zettrik/eddy2power/project_presentation_notes.md

# Windpower to the people
sense, think, act

## hardware
* nodemcu, mcp3208, mosfets, acs, 
* think pcb

## software
* arduino code, munin plugin

## data/information flow
* nodemcu -> sensor -> mqtt -> grafana

## visualization
* realtime: mqtt channel
* overview: munin
* better overview: grafana

## ideas
* drop nodemcus high power usage
* design sensor pcb
* design highpower switching (acting) pcb
