zettrik/eddy2power/work_in_progress/dumploadcontroller.pdf

https://www.warlock.com.au/dumploadcontroller.htm

Design & Construction:

# Dumpload and charge-controller circuit

### for Wind Turbines

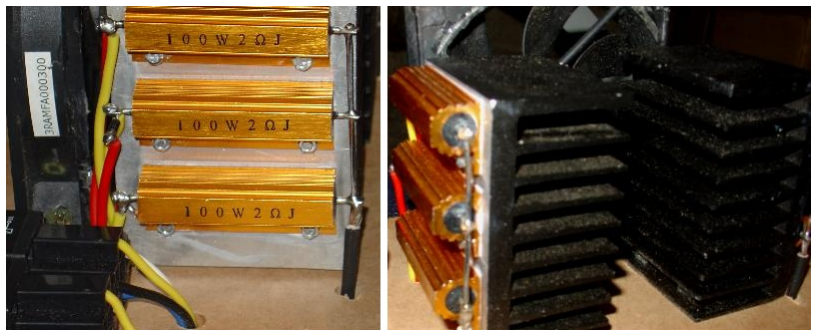
[picture p5: figure]

Abstract:
Wind turbine voltage regulation is usually achieved by diverting or dumping excess power into a dumpload (as heat). A universal 4-stage wind turbine dumpload charge controller circuit (inc. resistor load) was designed and built (using veroboard) for $140.

Without a charge controller, the wind turbine's main storage battery will overcharge resulting in reduced battery capacity and damage. Exceeding the maximum charging voltage on your 12/24v lead-acid battery system, will overcharge the battery, release hydrogen gas and result in permanent capacity loss.

14/12/2009

www.warlock.com.au

- 1/5 -

Copyright © 2009 - 2016 Warlock Engineering Pty. Ltd, All rights reserved. No part of this publication may not be reproduced or used in any manner without the express written permission of the publisher .

Rev. 2.0 - 16/8/2016

## Table of Contents

- 2/5 -

## Charge Controller Circuit

Four voltage comparator OP-AMPs switch-on 40 amp automotive relays when the battery voltage exceeds the trimpot set-voltages.

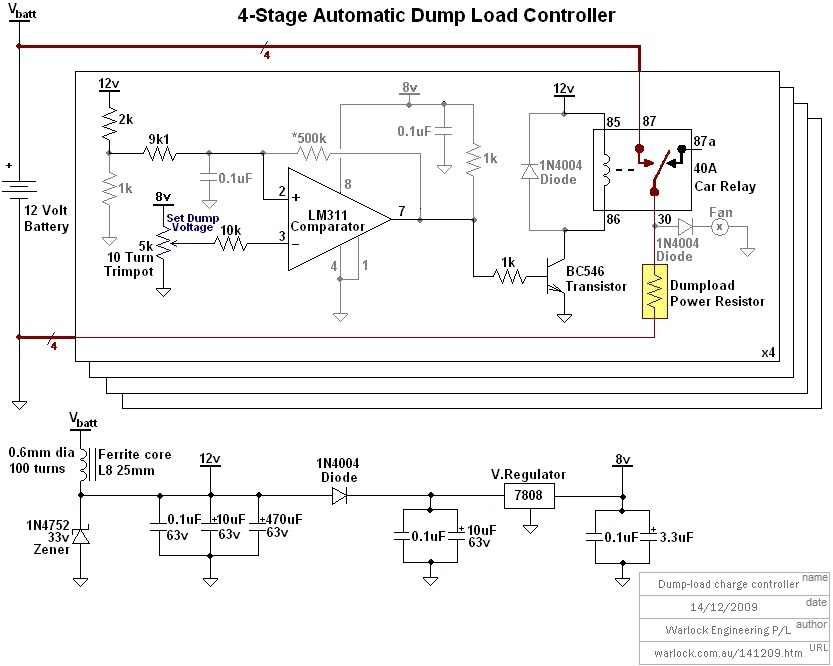
[picture p6: figure]

Figure 1. Circuit Diagram
A Zener diode and LC filter protects the op-amp from voltage spikes and noise. The 7808 voltage regulator provides power to the op-amp and voltage reference.
relay | on-
| voltage | off-
| | voltage | resistance | power | total-
| | | | | power
1 | 13.90 V | 13.75 V | 2 Ohm | 100 W | 100 W
2 | 14.00 V | 13.85 V | 2 Ohm | 100 W | 200 W
3 | 14.20 V | 14.05 V | 1 Ohm | 200 W | 400 W
4 | 14.30 V | 14.15 V | 1 Ohm | 200 W | 600 W

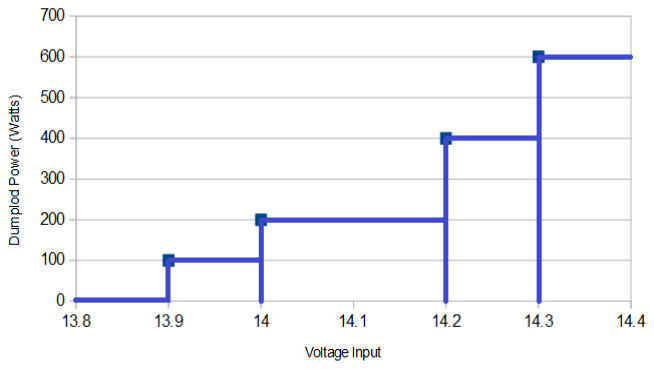
[picture p7: figure]

Figure 2. - Voltage thresholds and Power-load curve

- 3/5 -

The 500kW positive feedback resistor protects the relays from becoming unstable (oscillation) with 0.15 Volts of on/off hysteresis.

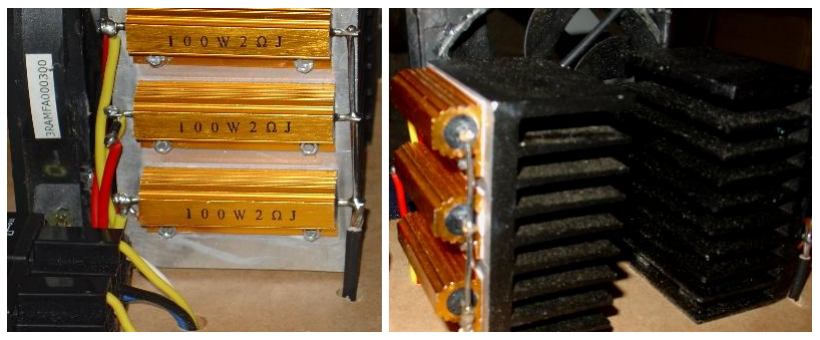
[picture p8: figure]

Figure 3. - Heatsink and Fan 6 x 100 watt power resistors connect to the battery with the automotive relays (see table 1), each relay is capable of diverting up to 40 Amps (576 Watts @ 12V) to the dumpload, the power-load curve for a typical 12v battery system (double for 24 volts) is shown in figure 2 .

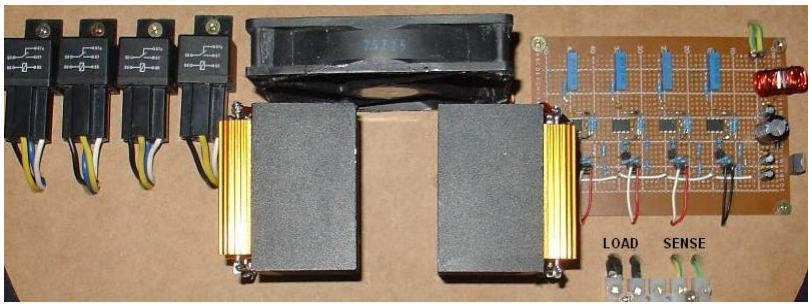
[picture p9: figure]

Figure 4. - Complete System Only 4 wires (load & sense) connect to the battery system, protecting it from overcharge and damage.

This type of power resistor requires a high quality fan and heatsink to operate, however the circuit works with any type of load (up to 40A).

- 4/5 -

Parts List

Qty | Part | Description | Unit cost | Cost
4 | LM311 | Comparator | $1.75 | $7.00
4 | BC547 | NPN Transistor | $0.26 | $1.04
1 | 7808 | Voltage Regulator, 8.0 Volts | $1.65 | $1.65
4 | 5k | 10-turn trimpot resistor | $1.75 | $7.00
9 | 1N4004 | Diode | $0.13 | $1.17
1 | 1N4752 | Zener diode , 33 Volts | $0.55 | $0.55
1 | L8 | 25x15x10mm Toroid Core | $1.75 | $1.75
28 | - | Resistors | $0.06 | $1.68
15 | - | Capicators | $0.35 | $5.25
1 | - | 305mm veroboard | $11.50 | $11.50
| | | Total | $38.95

Figure 5. Parts List (PCB)

Heatsink | $20.00
12 Volt Fan | $12.00
electronic components | $38.59
40 Amp automotive relays (x4) | $24.00
2 W (100 Watt) resistors (x6) | $48.00
Total cost | $142.59

Figure 6. Parts List (Misc.)

- 5/5 -
