zettrik/eddy2power/circuits/555_timer_pins.jpg

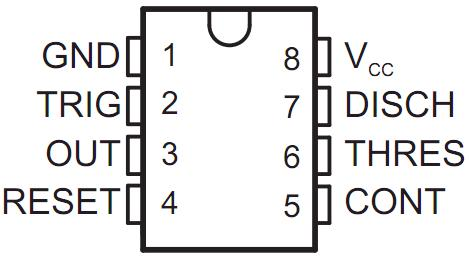
circuits/555_timer_pins.jpg
