zettrik/eddy2power/circuits/Entladeschutz_Steckplatine.png

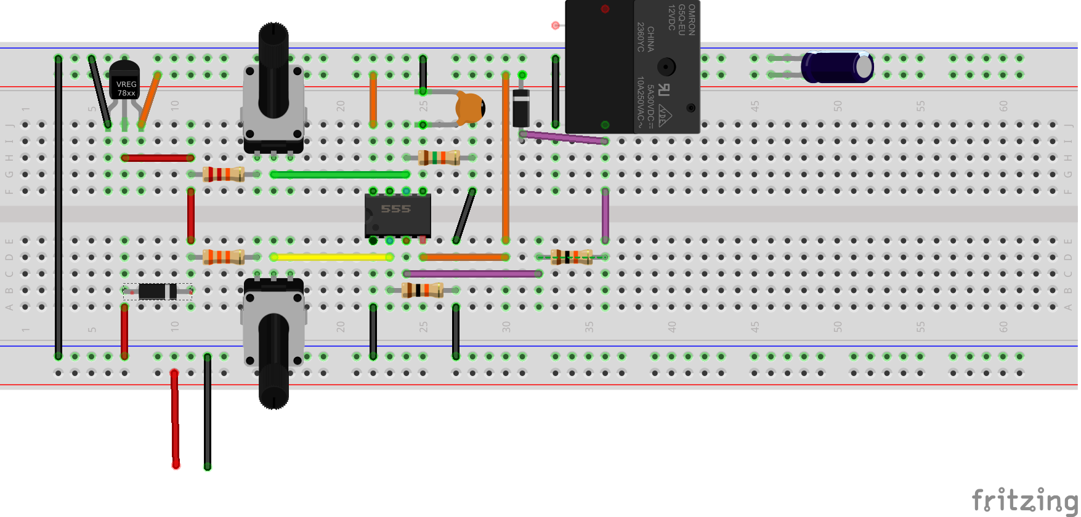
circuits/Entladeschutz_Steckplatine.png
