zettrik/eddy2power/circuits/mcp3008_3208_pins.png

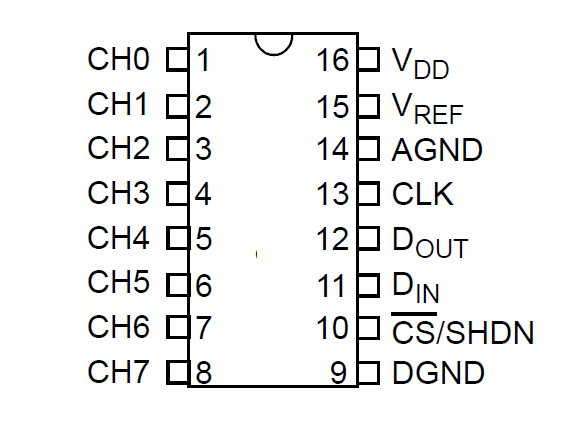
circuits/mcp3008_3208_pins.png
