zettrik/eddy2power/circuits/MCP3008_an_Pi_mit_Spannungsteiler_Steckplatine.png

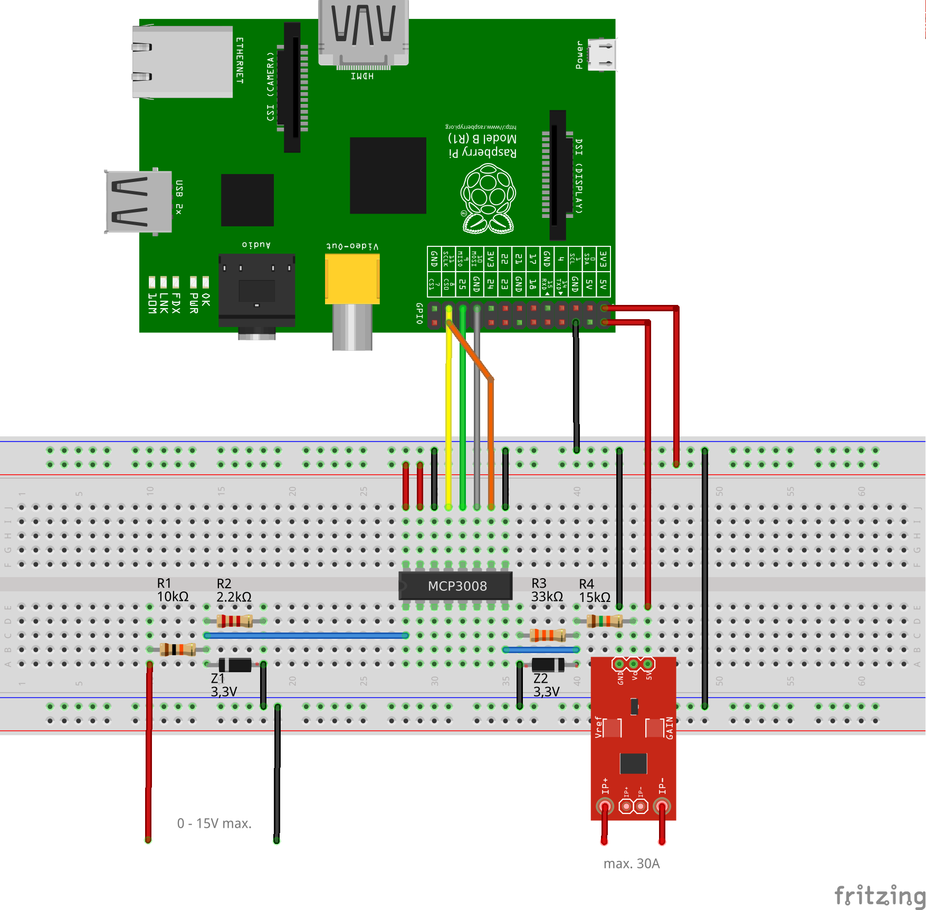
circuits/MCP3008_an_Pi_mit_Spannungsteiler_Steckplatine.png
