zettrik/eddy2power/circuits/nodemcu-sdcard_Steckplatine.png

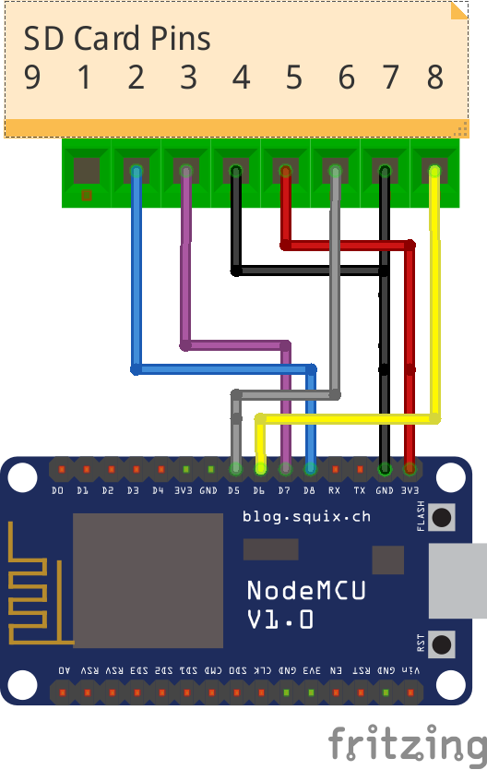
circuits/nodemcu-sdcard_Steckplatine.png
