zettrik/eddy2power/circuits/Spannungsteiler_Berechnung.jpg

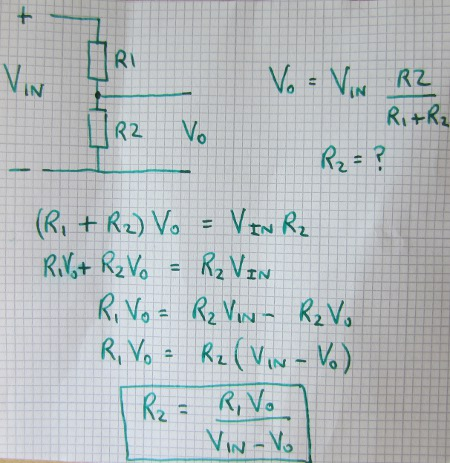
circuits/Spannungsteiler_Berechnung.jpg
