zettrik/eddy2power/circuits/Spannungsteiler_Steckplatine.png

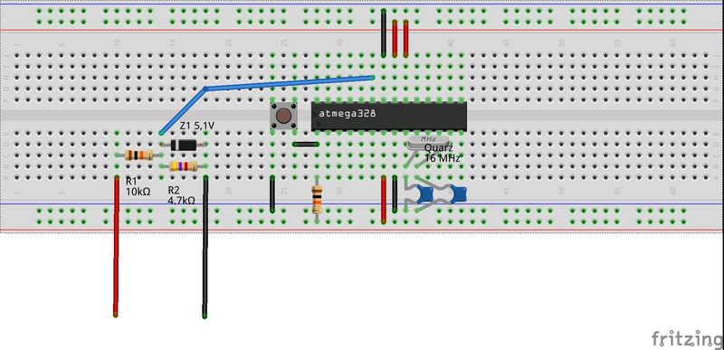
circuits/Spannungsteiler_Steckplatine.png
