zettrik/eddy2power/photos/anemometer/anemometer_am_mast.jpg

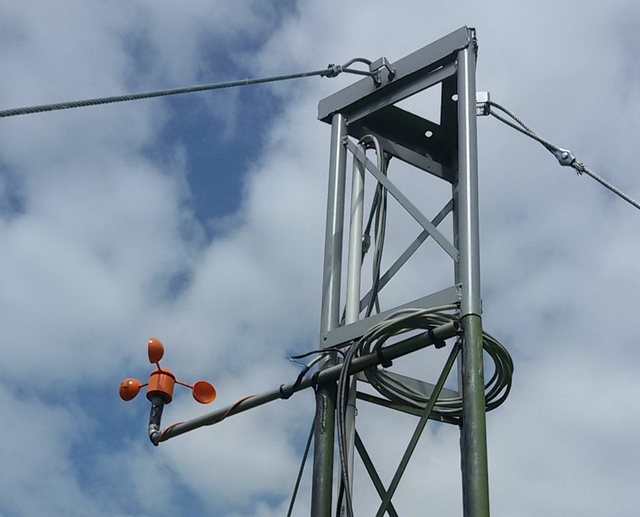
photos/anemometer/anemometer_am_mast.jpg
