zettrik/eddy2power/photos/rotor_blade/darrieus-skelett.jpg

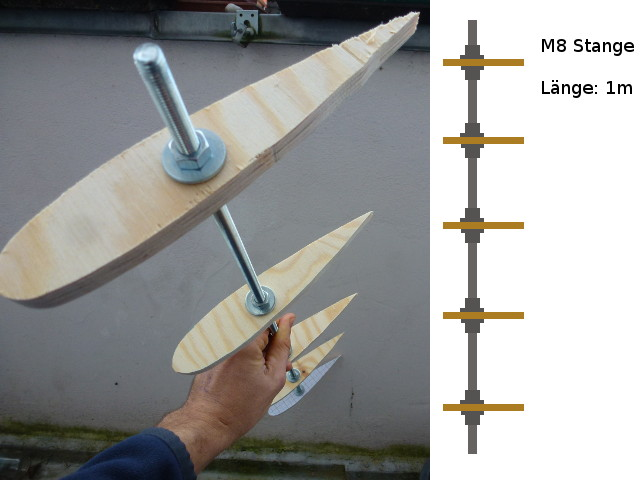
photos/rotor_blade/darrieus-skelett.jpg
