zettrik/eddy2power/photos/rotor_blade/folie_rippe_bohrloch.jpg

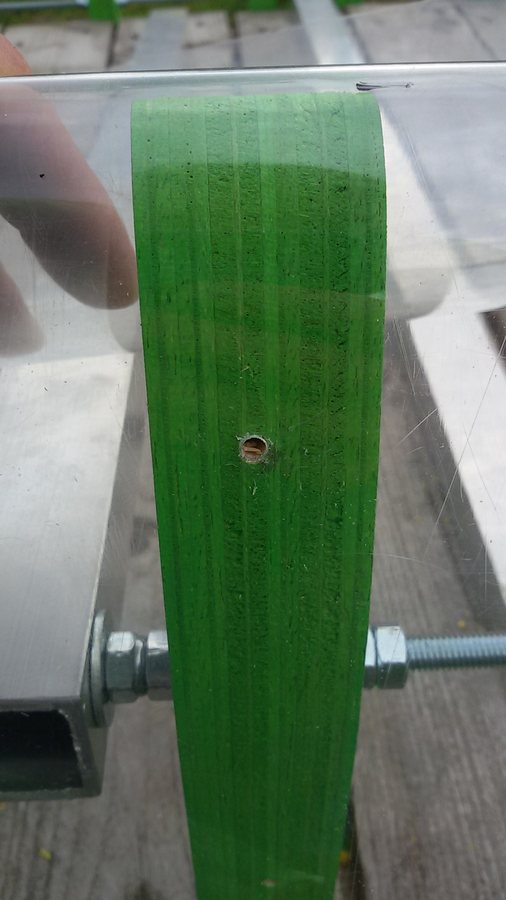
photos/rotor_blade/folie_rippe_bohrloch.jpg
