zettrik/eddy2power/photos/rotor_blade/folie_rotorarm_loch.jpg

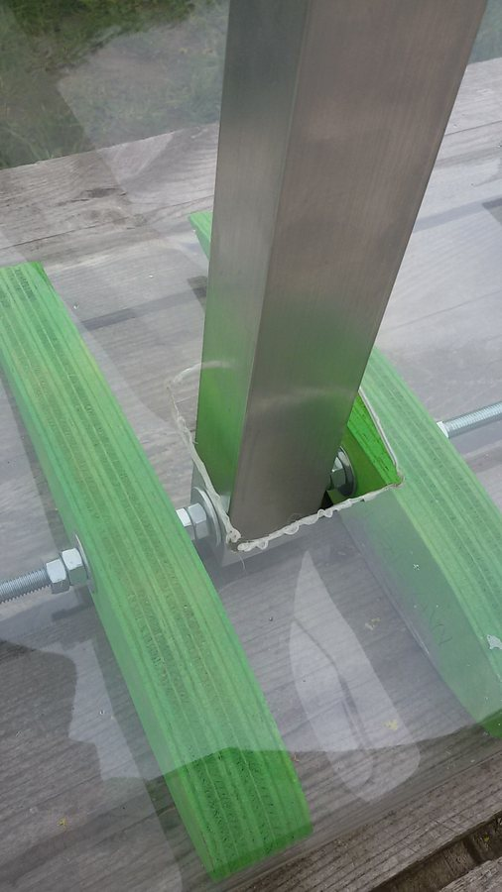
photos/rotor_blade/folie_rotorarm_loch.jpg
