zettrik/eddy2power/photos/rotor_blade/naca-profil.jpg

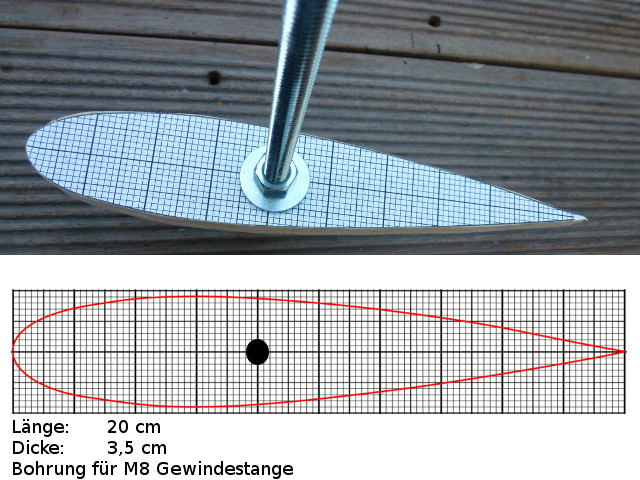
photos/rotor_blade/naca-profil.jpg
