zettrik/eddy2power/photos/rotor_blade/niete1.jpg

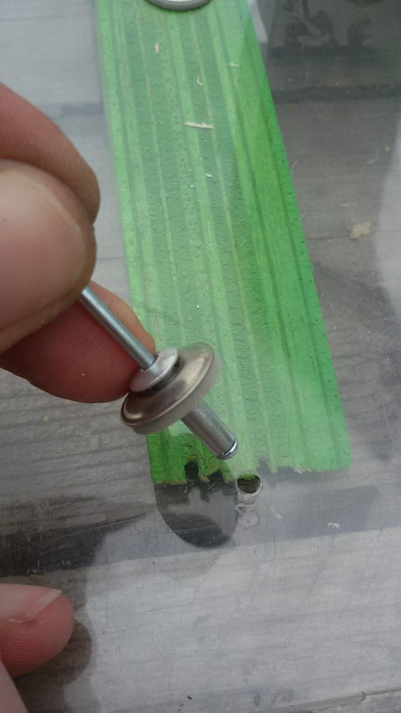
photos/rotor_blade/niete1.jpg
