zettrik/eddy2power/photos/rotor_blade/niete2.jpg

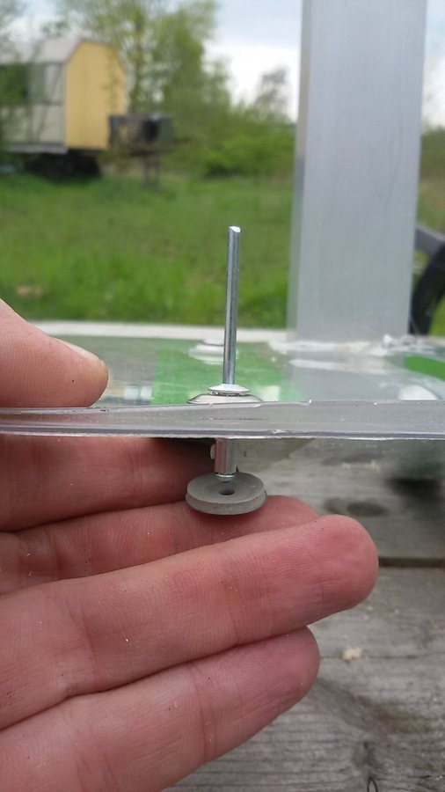
photos/rotor_blade/niete2.jpg
