zettrik/eddy2power/photos/rotor_blade/rotorblatt_fertig.jpg

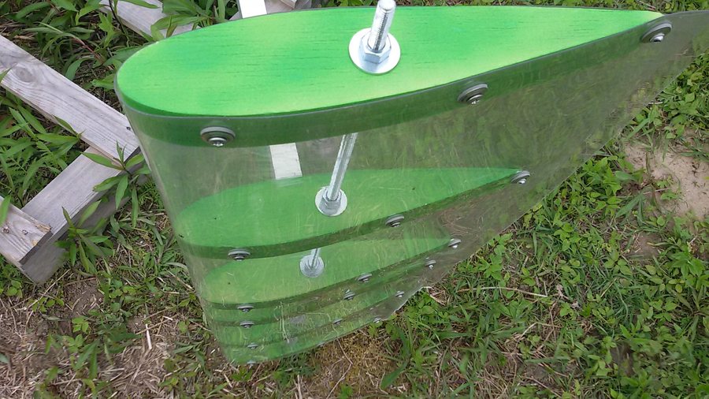
photos/rotor_blade/rotorblatt_fertig.jpg
