zettrik/eddy2power/photos/rotor_blade/verschrauben.jpg

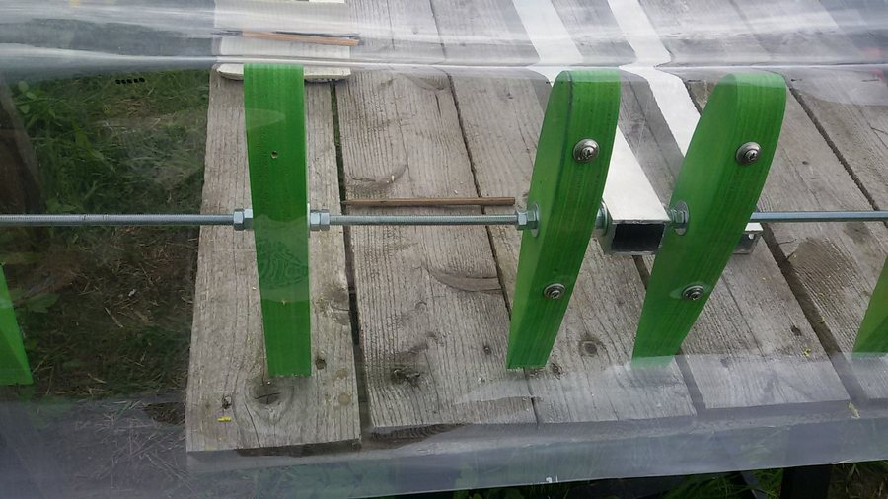
photos/rotor_blade/verschrauben.jpg
