zettrik/eddy2power/work_in_progress/3_Phasen_Gleichrichter_Spannung.png

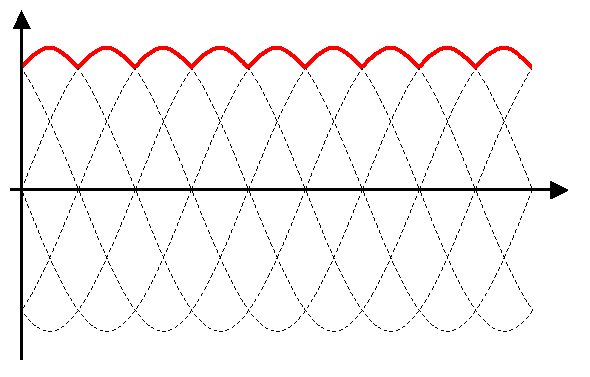
work_in_progress/3_Phasen_Gleichrichter_Spannung.png
