zettrik/eddy2power/work_in_progress/555ChargeController2.jpg

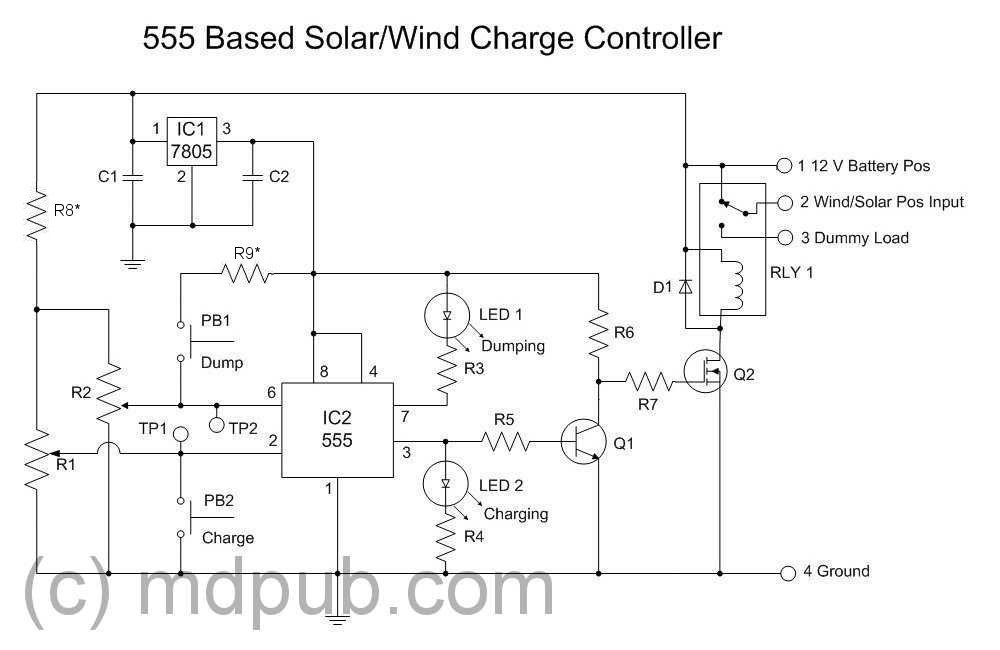
work_in_progress/555ChargeController2.jpg
