zettrik/eddy2power/work_in_progress/Brueckengleichrichter_ani.gif

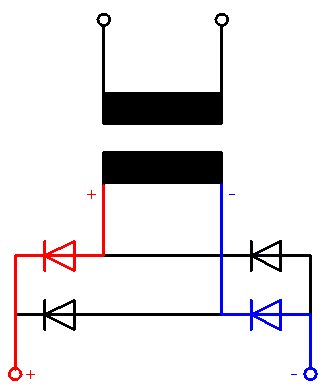
work_in_progress/Brueckengleichrichter_ani.gif
