zettrik/eddy2power/work_in_progress/Diagramm_Windleistung.png

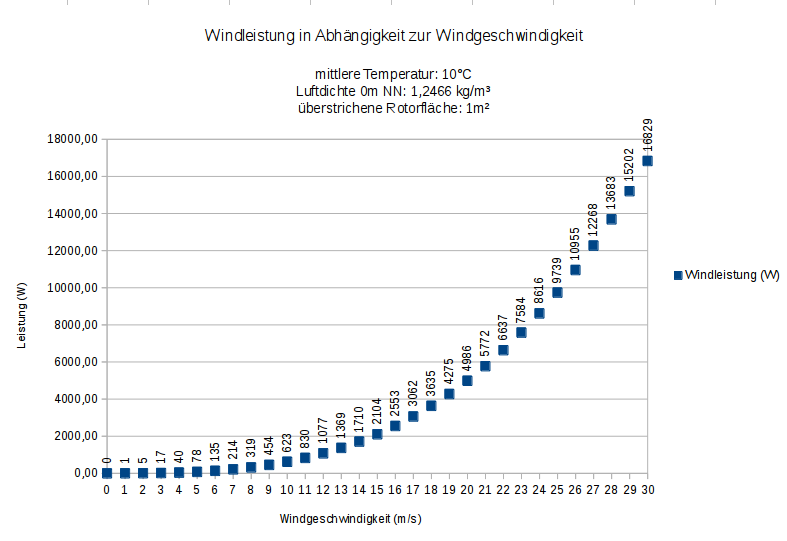
work_in_progress/Diagramm_Windleistung.png
