zettrik/eddy2power/work_in_progress/Drehmomente_H-Rotor.png

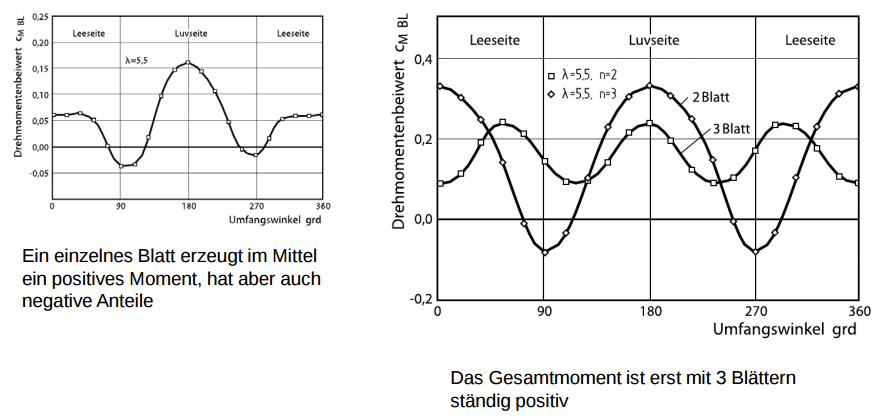
work_in_progress/Drehmomente_H-Rotor.png
