zettrik/eddy2power/work_in_progress/go_with_the_flow.jpg

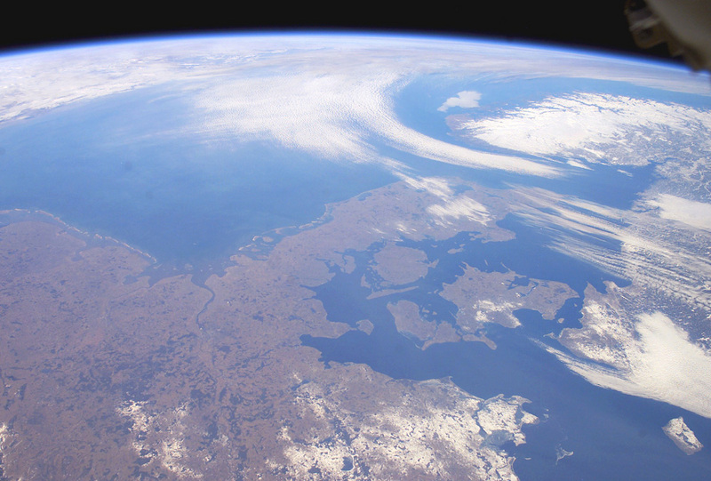
work_in_progress/go_with_the_flow.jpg
