zettrik/eddy2power/work_in_progress/Kräfte_am_H-Rotor.png

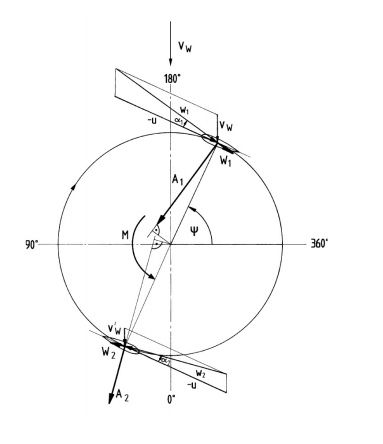
work_in_progress/Kräfte_am_H-Rotor.png
