zettrik/eddy2power/work_in_progress/nodemcu-esp8266/nodemcu-wind-power-monitor-mcp3208-relays_Steckplatine.png

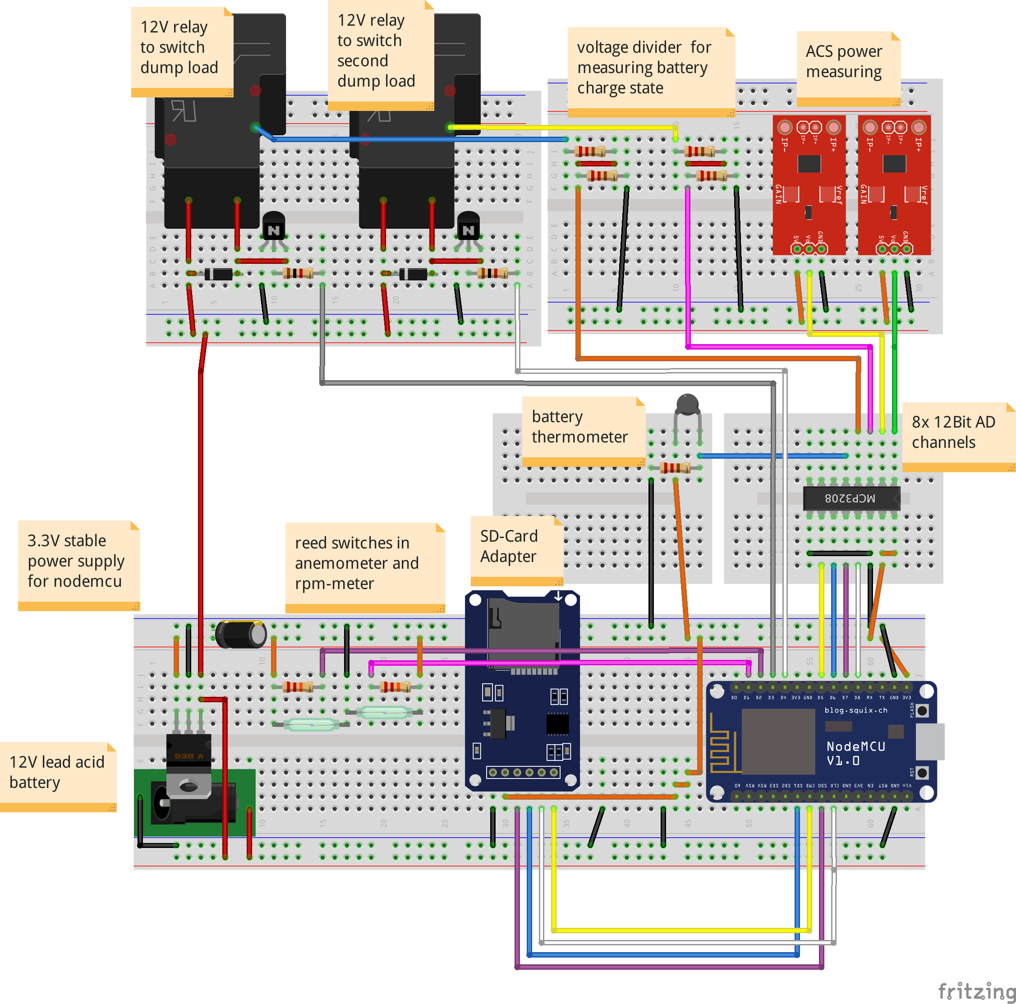
work_in_progress/nodemcu-esp8266/nodemcu-wind-power-monitor-mcp3208-relays_Steckplatine.png
