zettrik/eddy2power/work_in_progress/nodemcu-esp8266/nodemcu-wind-power-monitor.png

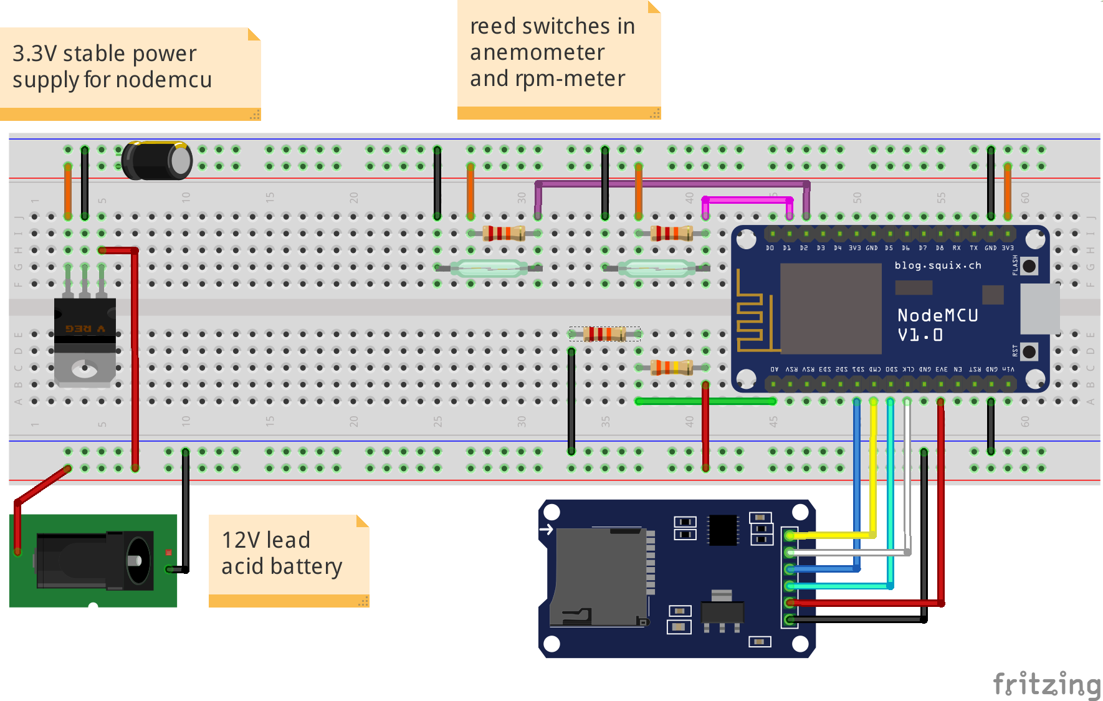
work_in_progress/nodemcu-esp8266/nodemcu-wind-power-monitor.png
