zettrik/eddy2power/work_in_progress/nodemcu-esp8266/NodeMCU_SD_Card_pin_mapping.png

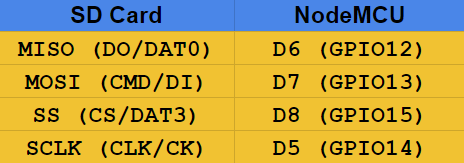
work_in_progress/nodemcu-esp8266/NodeMCU_SD_Card_pin_mapping.png
