zettrik/eddy2power/work_in_progress/raspberry-pi_pin-info.png

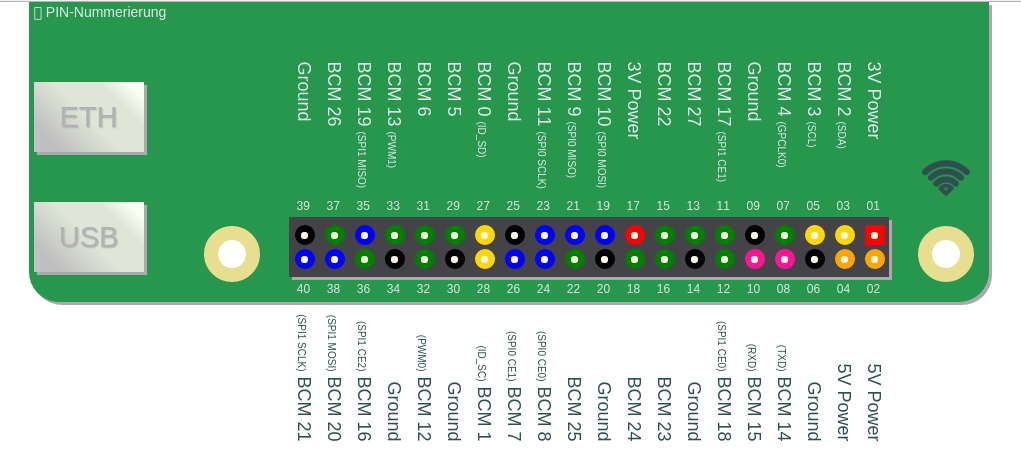
work_in_progress/raspberry-pi_pin-info.png
