zettrik/eddy2power/work_in_progress/ServoDriver.PNG

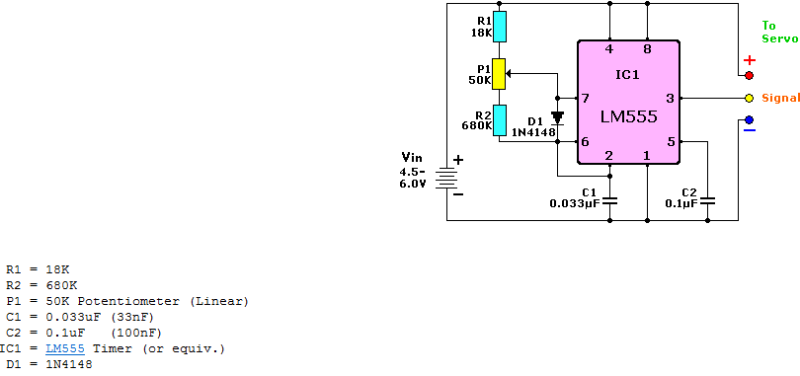
work_in_progress/ServoDriver.PNG
