zettrik/eddy2power/work_in_progress/nodemcu-esp8266/voltage_divider_for_ad_converter.ods

calculations for voltage divider at analog/digital converter
maximum input voltage (V) | 20,00 | 30,00 | 60,00
estimated voltage @mcp3208 (V) | 3,30 | 3,30 | 3,30
r1 (kOhm) | 30,00 | 47,00 | 100,00
r2 (kOhm) | 10,00 | 10,00 | 10,00
poti (kOhm) | 10,00 | 10,00 | 10,00
r2 parallel to poti (kOhm) | 5,00 | 5,00 | 5,00
r3 (kOhm) | 0,00 | 0,00 | 0,00
total resistance (kOhm) | 35,00 | 57,00 | 105,00
multiplier | 0,17 | 0,11 | 0,05
voltage @divider (V) | 3,33 | 3,19 | 3,00
