zettrik/eddy2power/work_in_progress/localelectricity_dot_org-Wind_Turbine_Instructions.pdf

## Local Electricity Project: DIY Wind Turbine

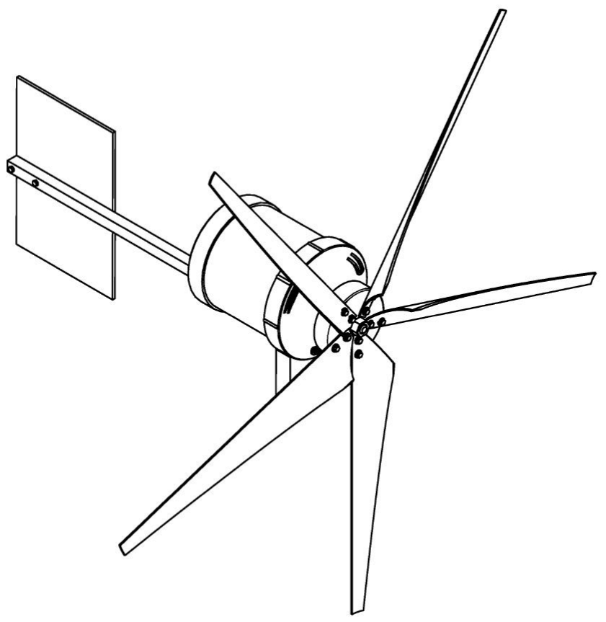
[picture p119: figure]

SAFETY NOTE: Wind turbines can be extremely dangerous and should never be installed near highly populated areas. Always double check your work and make sure all fasteners use locking nuts or threadlocker.

## Introduction

This is a guide to making your own low cost wind turbine using readily available parts, tools and labour. Please read the instructions all the way through before attempting to make your own turbine.

Most of the materials used were sourced from my local hardware store (Bunnings, Australia), with the exception of the treadmill motor, which was bought off eBay for $40AUD.

I tested the motor by turning it in a drill press and measured the voltage output at different speeds with a dummy load and datalogger, achieving 20W at 400RPM.

This wind turbine was built and tested with a
maximum output of 20W, although more detailed analysis is required to determine the power curve.

Tools and materials required are listed below, but it should be noted that the instructions can be altered to suit your own circumstances.

We have split tools into those that are required, and those that are recommended for better precision, which is particularly important with the blades.

## Contact Us

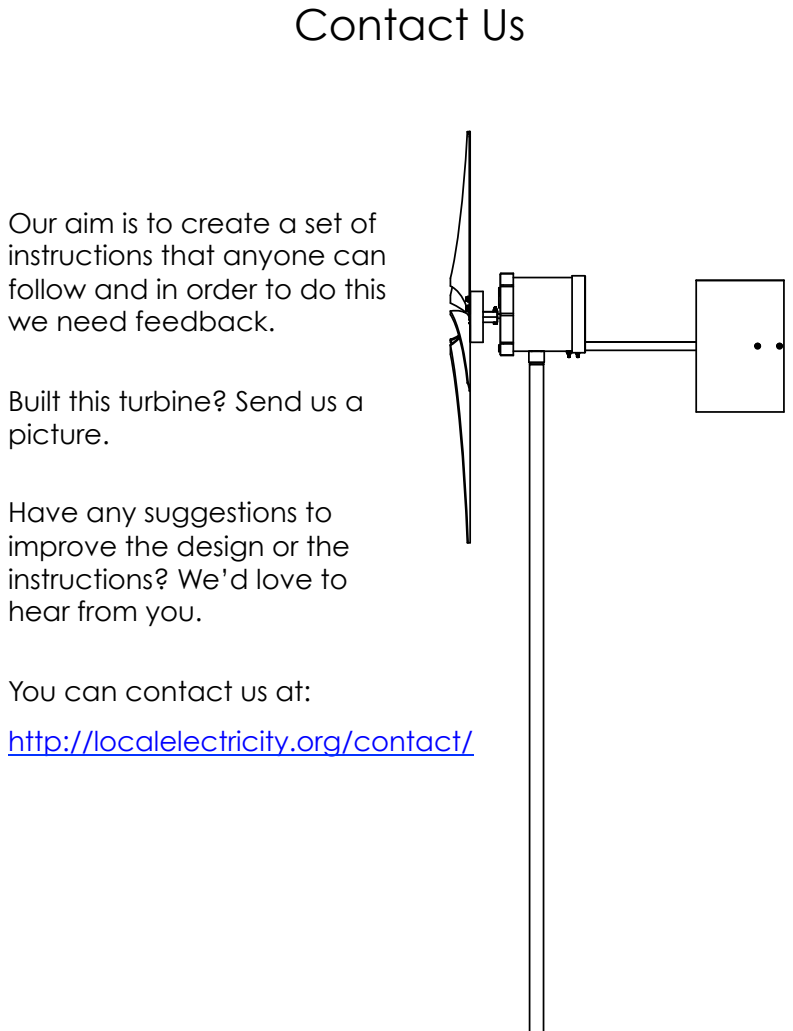
[picture p120: page 3]

Our aim is to create a set of
instructions that anyone can
follow and in order to do this
we need feedback.

Built this turbine? Send us a
picture.

Have any suggestions to
improve the design or the
instructions? We’d love to
hear from you.

You can contact us at:
http://localelectricity.org/contact/

## Tools Required

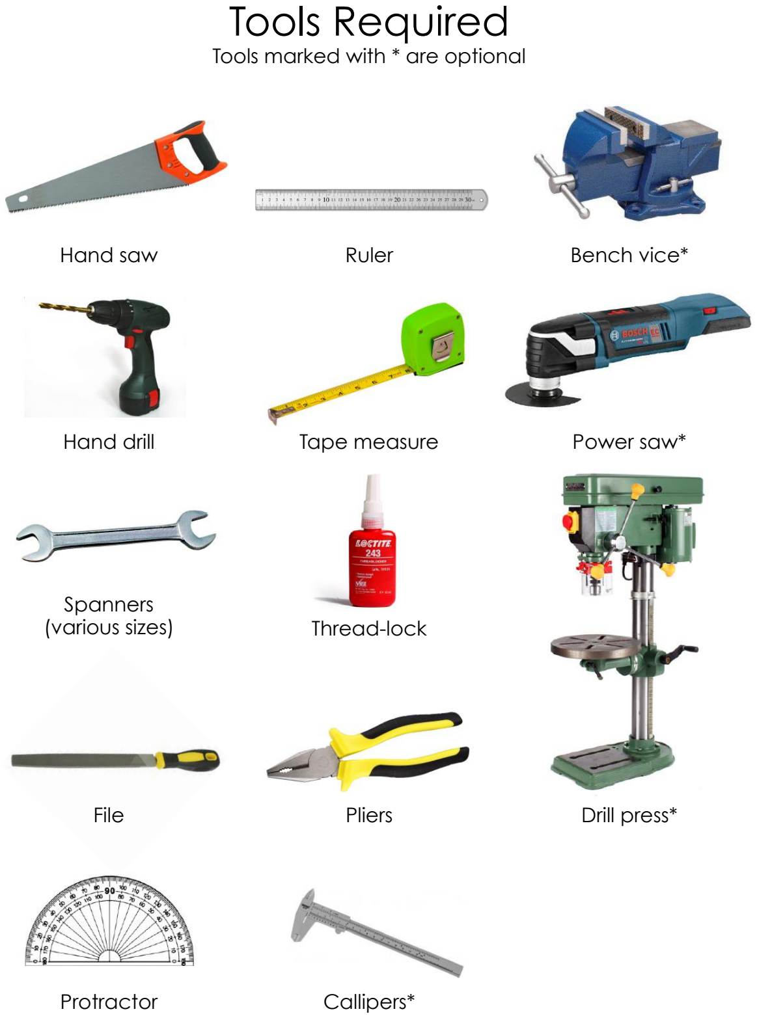
[picture p121: page 4]

Hand saw | Ruler | Bench vice*
Hand drill | Tape measure | Power saw*

Spanners
(various sizes) | Thread-lock
File | Pliers | Drill press*
Protractor | Callipers*

Tools marked with * are optional

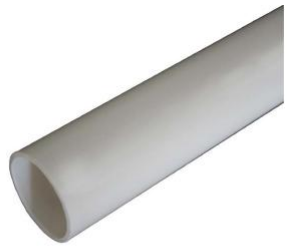
[picture p122: figure]

90mm!x!1m!PVC!pipe! | x1!

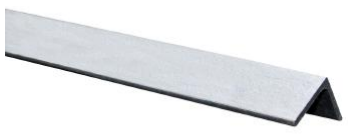
[picture p123: figure]

12x12x1.4mm!Angle! Iron!(0.5m!long)! | x1!

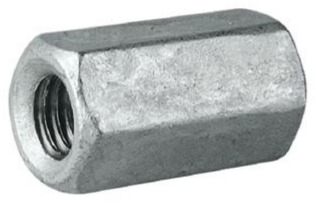
[picture p124: figure]

M16!x!60mm!hex! coupler! | x1!

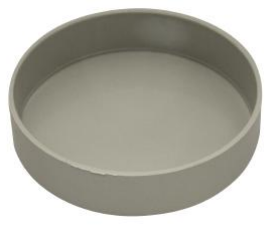
[picture p125: figure]

100mm!PVC!end!cap! | x1!

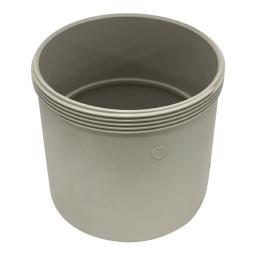
[picture p126: figure]

150mm!PVC!threaded! access!coupling! | x1!

## Materials

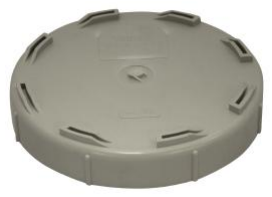
[picture p127: figure]

150mm!PVC!threaded! end!cap! | x1!
150mm!PVC!end!cap! | x1!

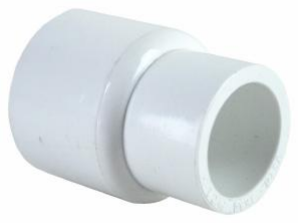
[picture p128: figure]

20mm!to!15mm!PVC! reducer! | x1!

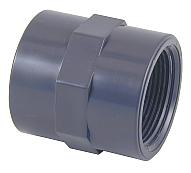
[picture p129: figure]

15mm!PVC!male! thread!adapter! | x1!

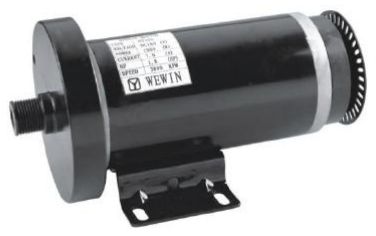
[picture p130: figure]

Treadmill!motor! | x1!

## Materials

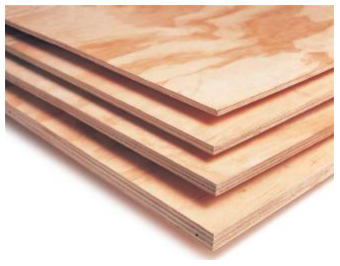
[picture p131: figure]

300x300x5mm! plywood! | x1!

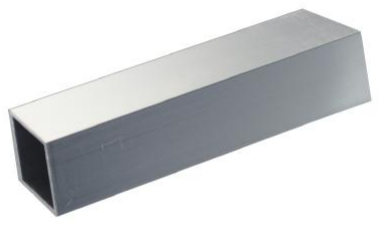
[picture p132: figure]

19mm!aluminium!box! secHon!(500mm!long)! | x1!
15mm!x!200mm!pipe! | x1!

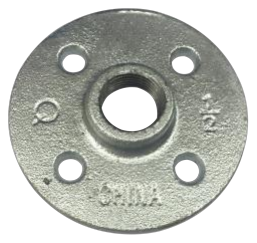
[picture p133: figure]

15mm!pipe!flange! | x1!

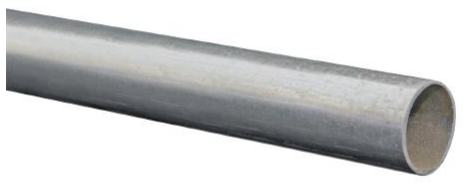
[picture p134: figure]

31.8x1.2mm!steel! tubing!(3m!long)! | x1!

## Materials

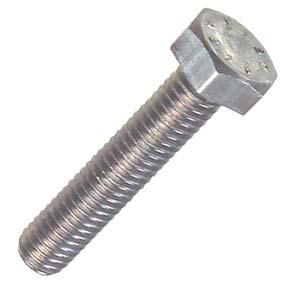
[picture p135: figure]

Bolts:! M16x100mm! M7x20mm! M5x25mm! M5x35mm! 0.5”x1.5”! | x1! x4! X10! X4! x4!

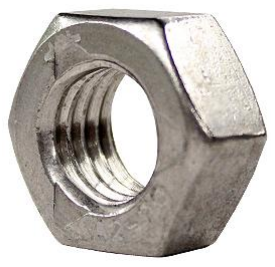
[picture p136: figure]

Nuts:! M16! M7! M5! 0.5”! | x1! x4! X14! x4!

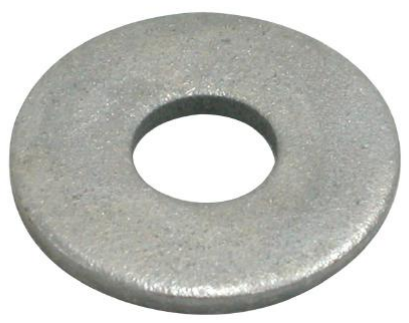
[picture p137: figure]

Washers:! M7! M5! 0.5”! | x4! X14! x4!

## Fasteners

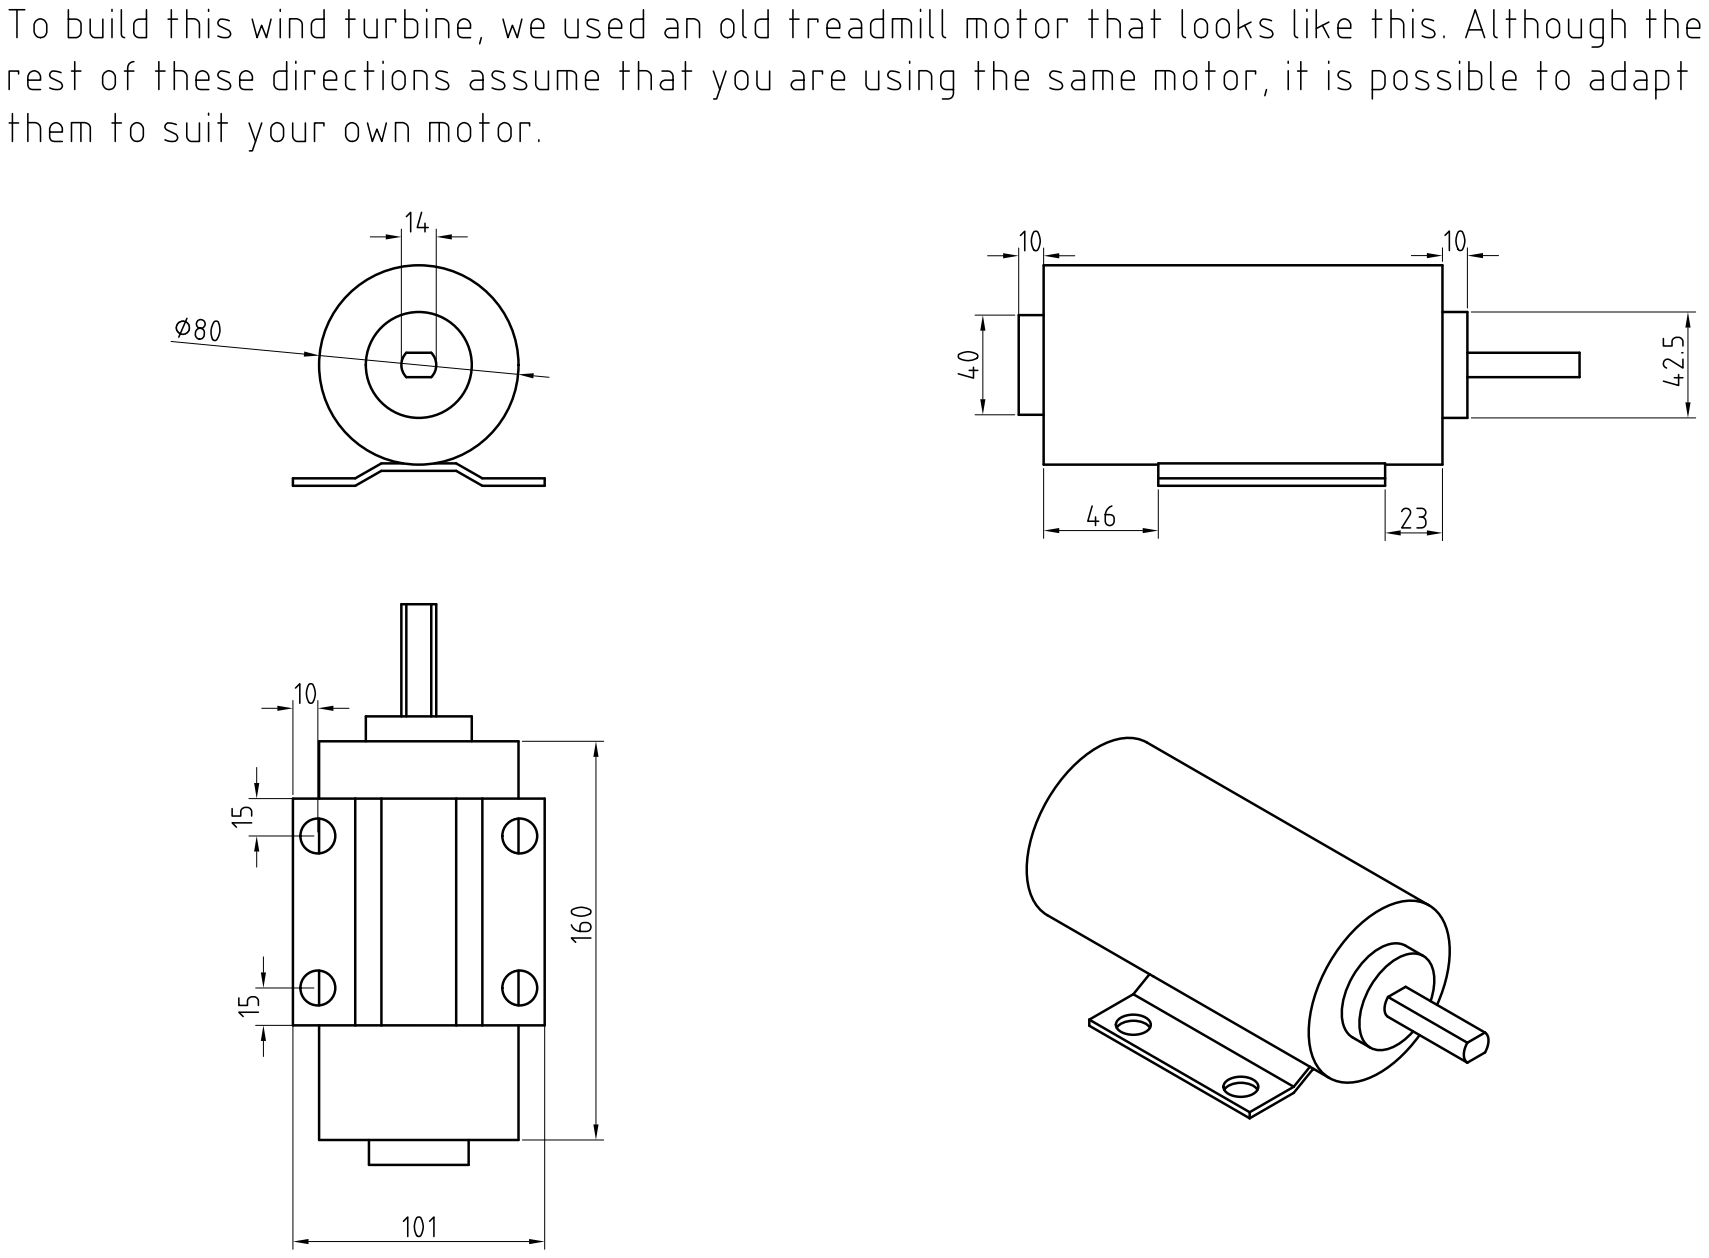
[picture p138: page 9]

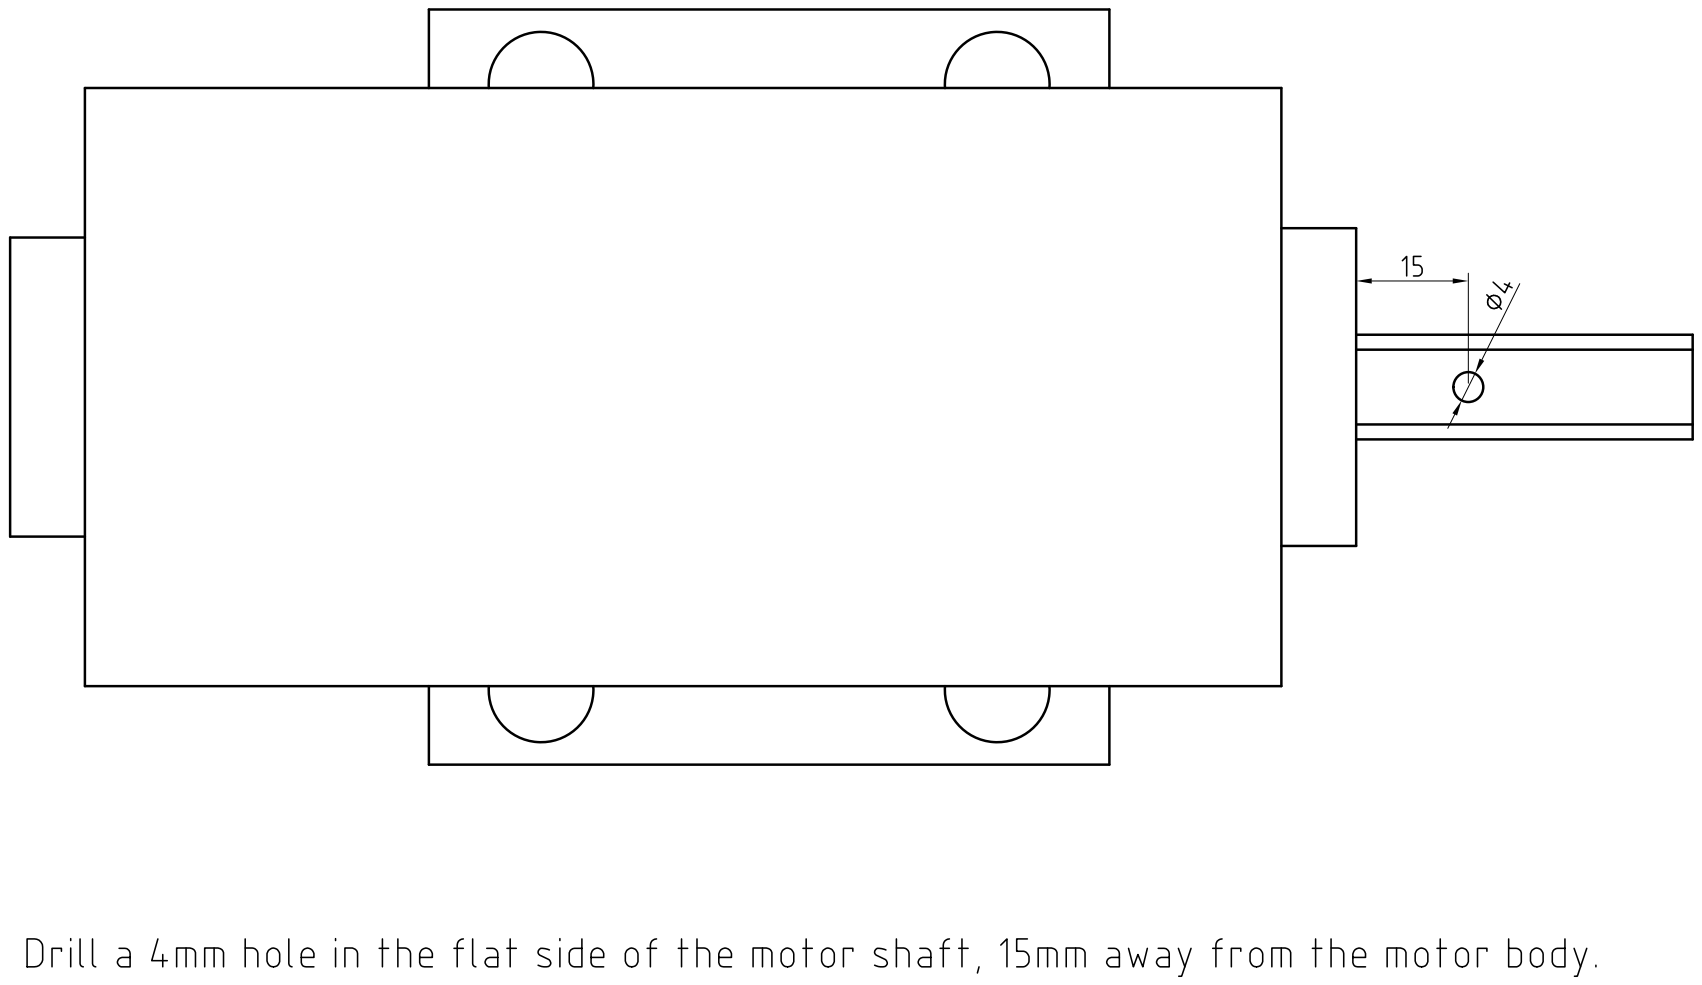
[picture p139: page 10]

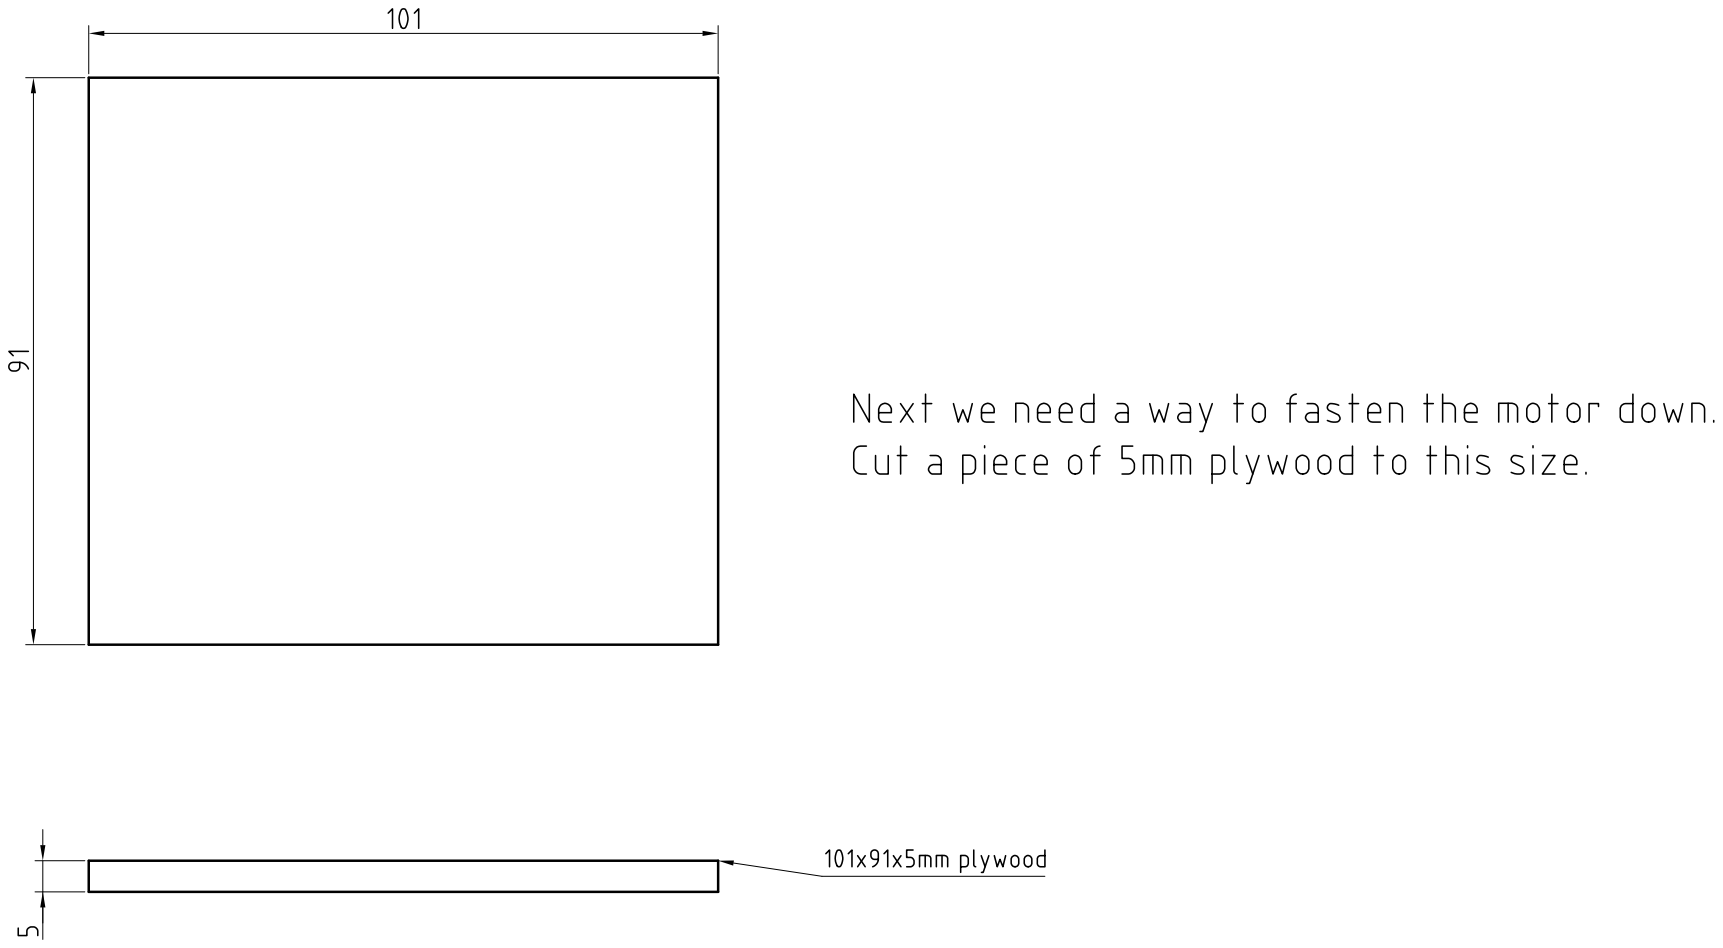
[picture p140: page 11]

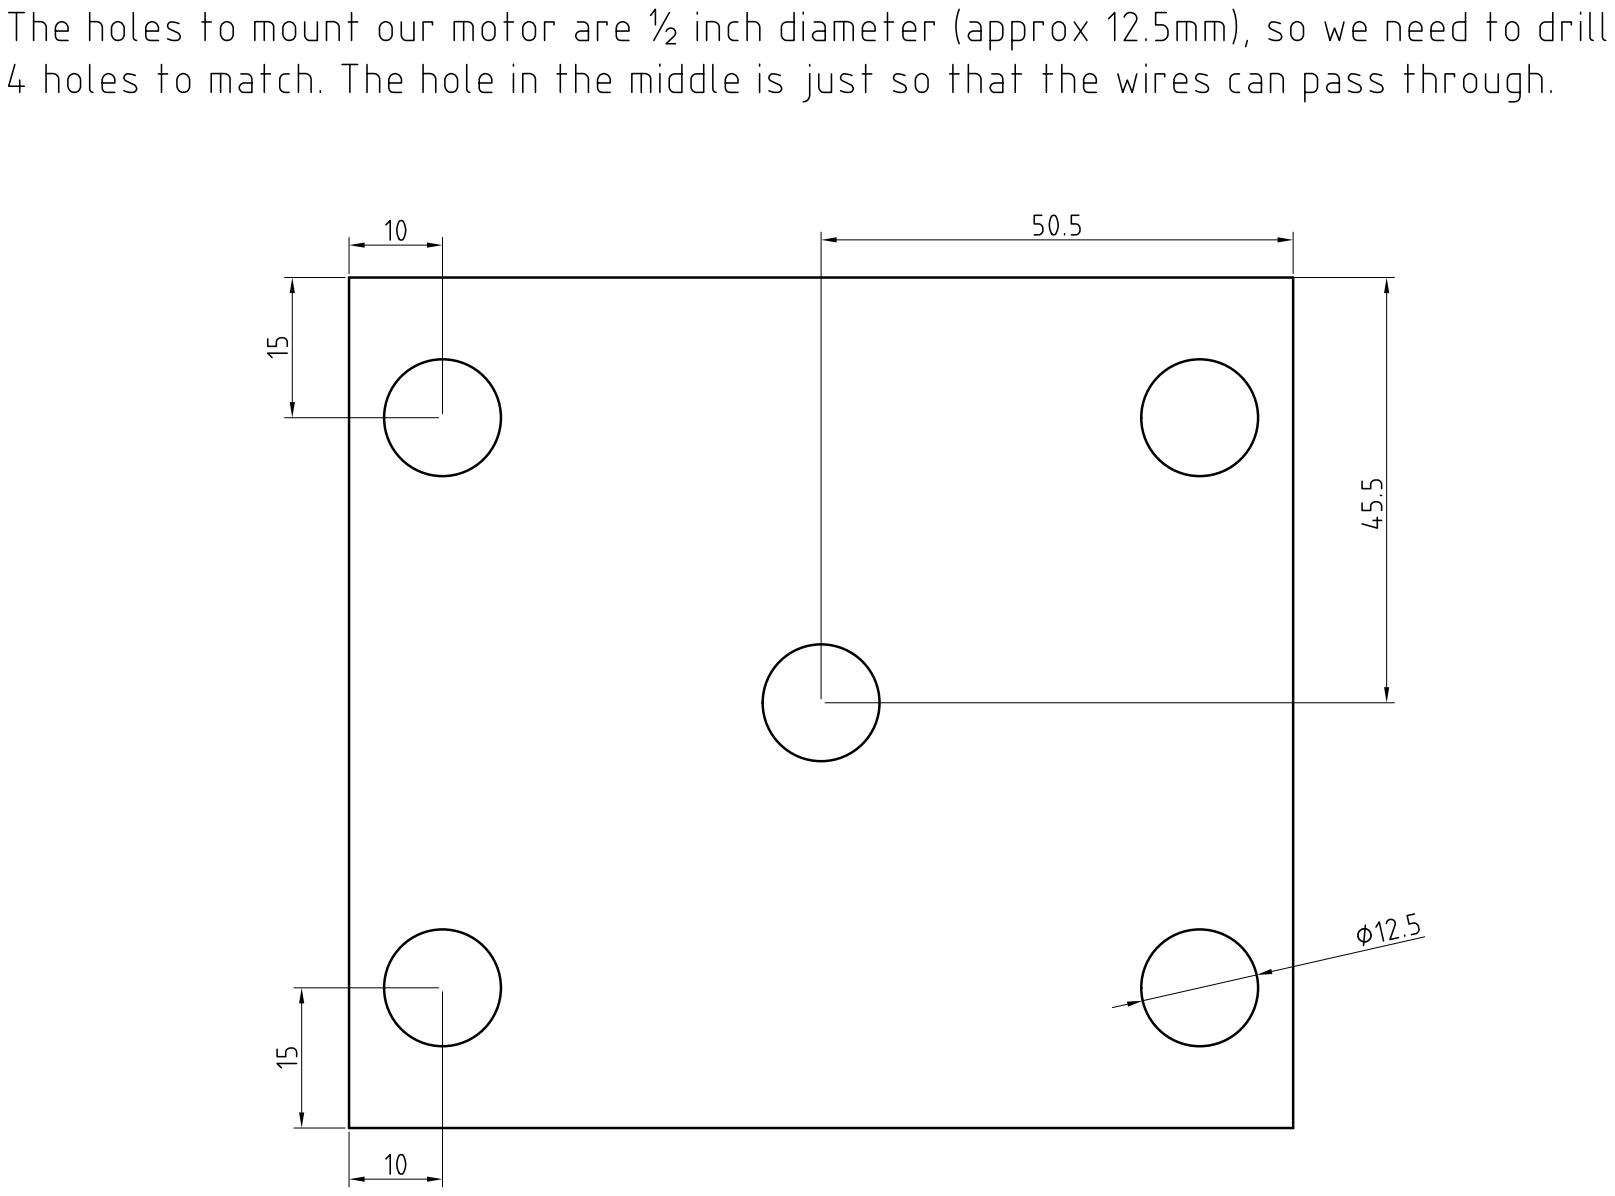
[picture p141: page 12]

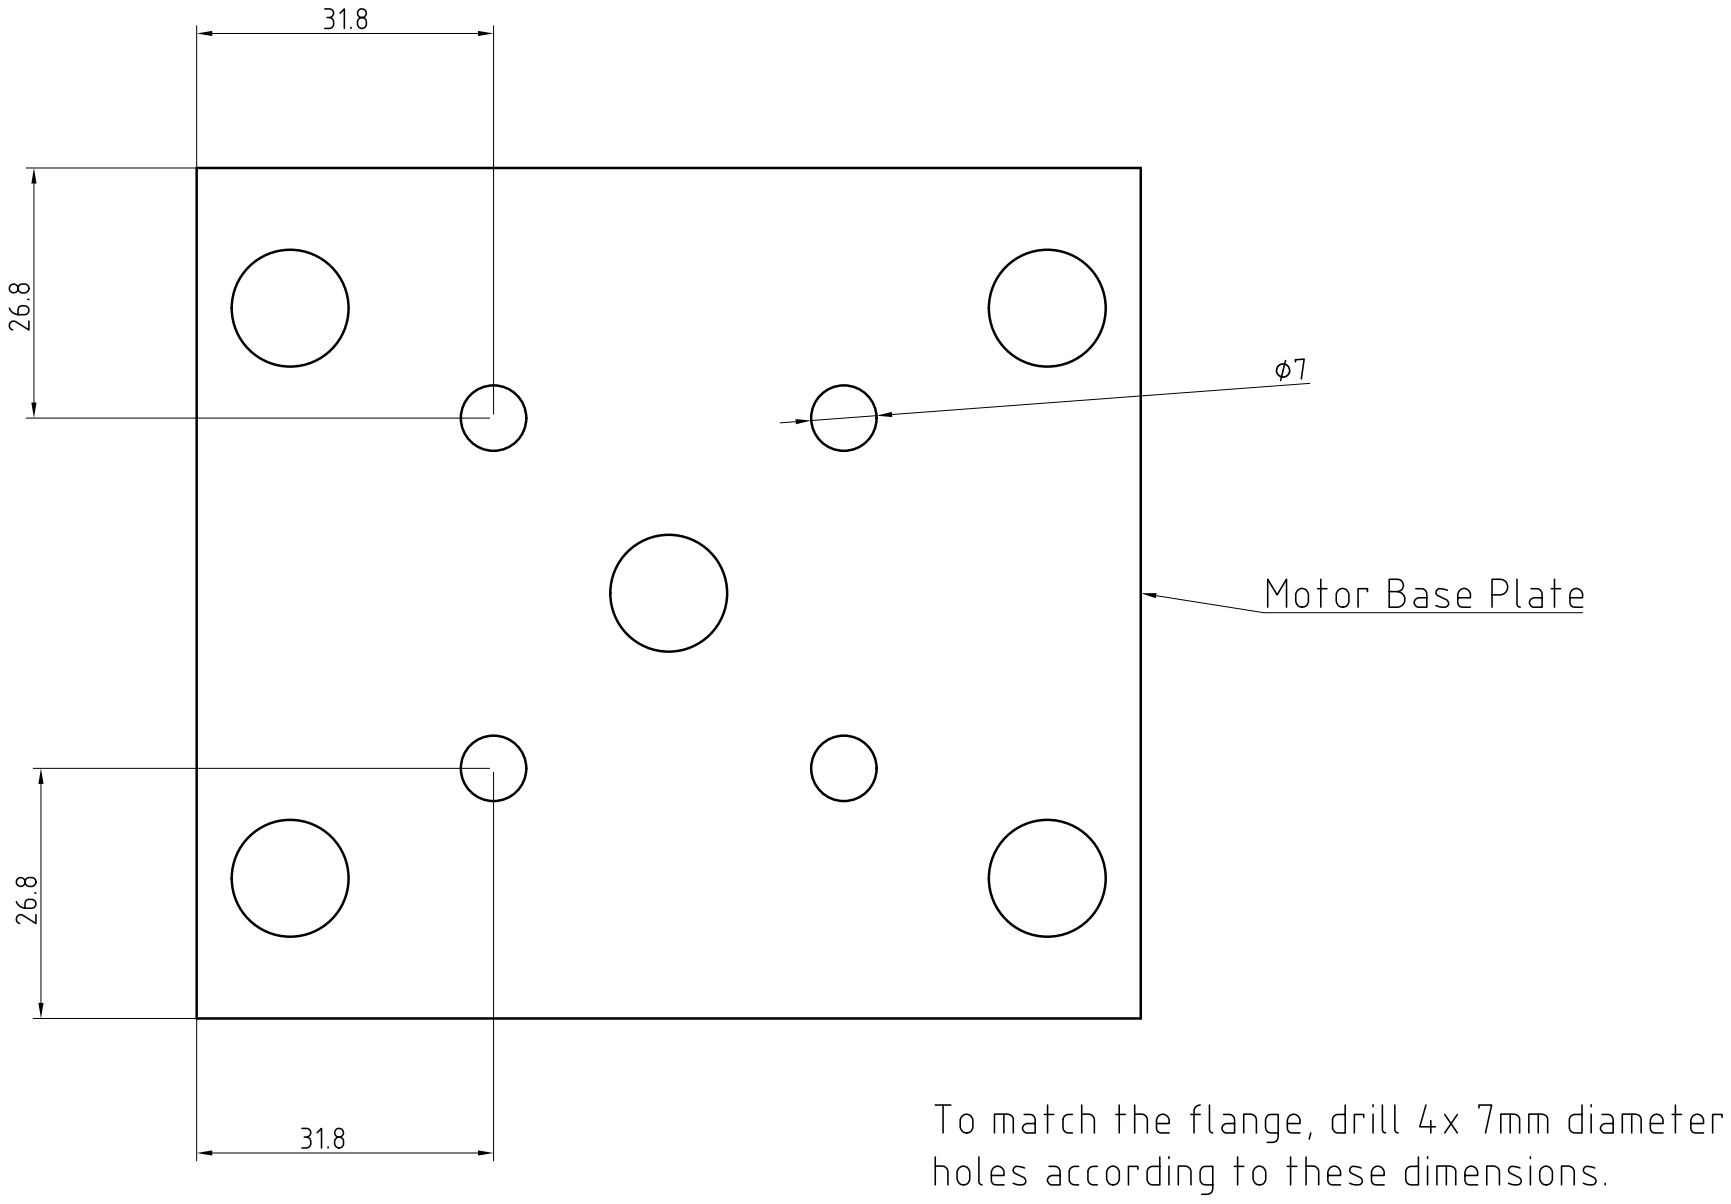
[picture p142: page 13]

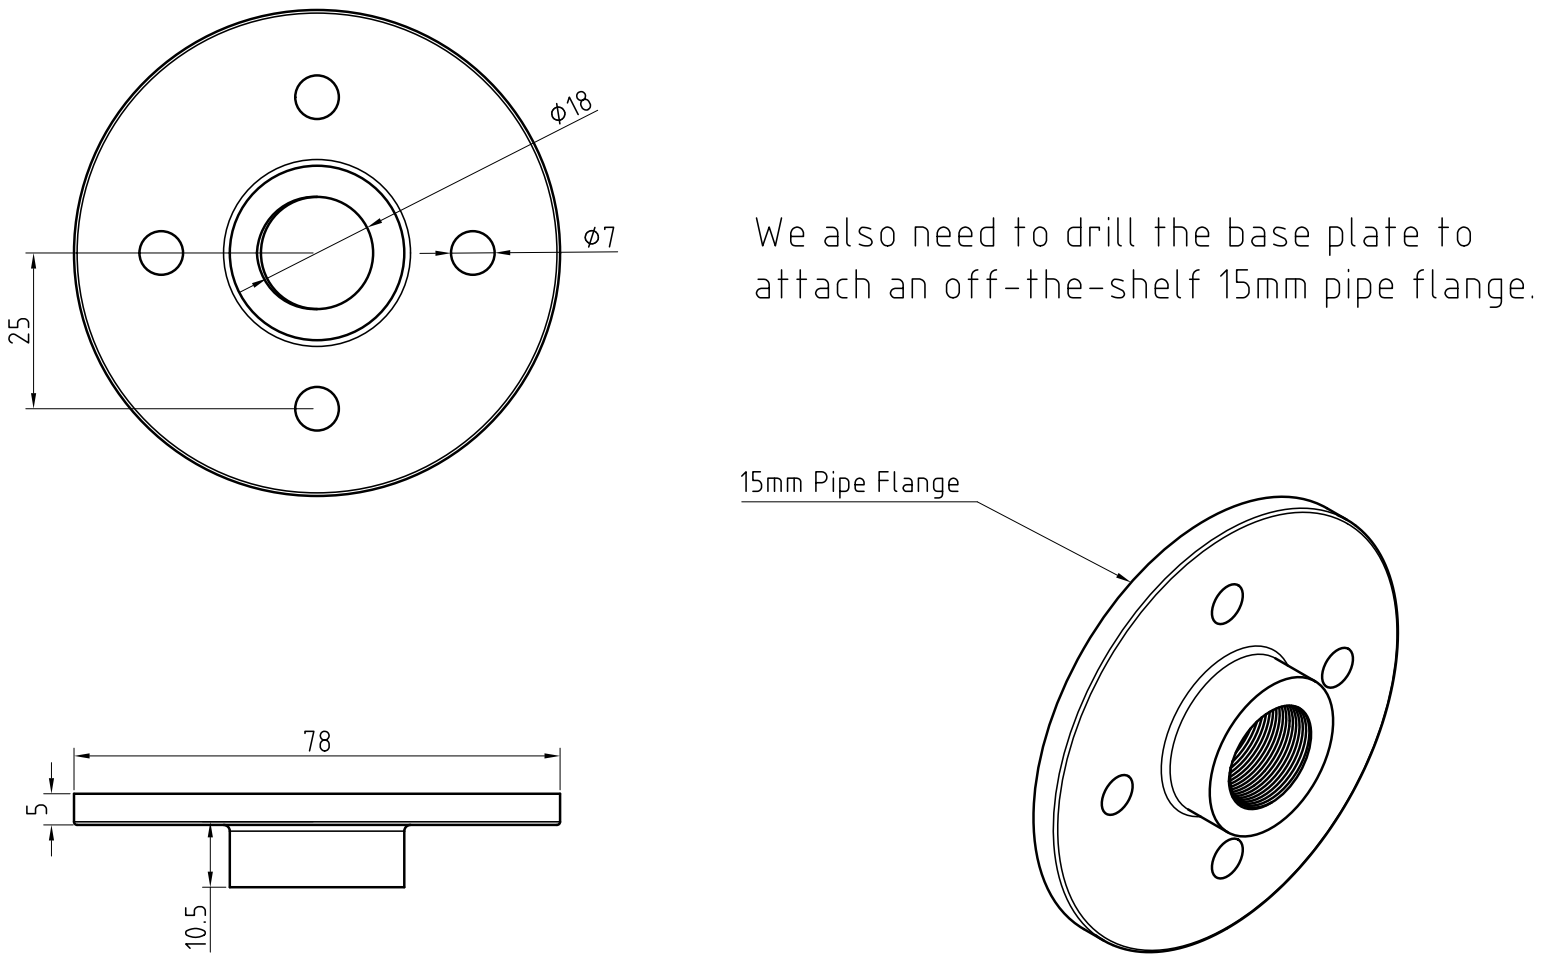
[picture p143: page 14]

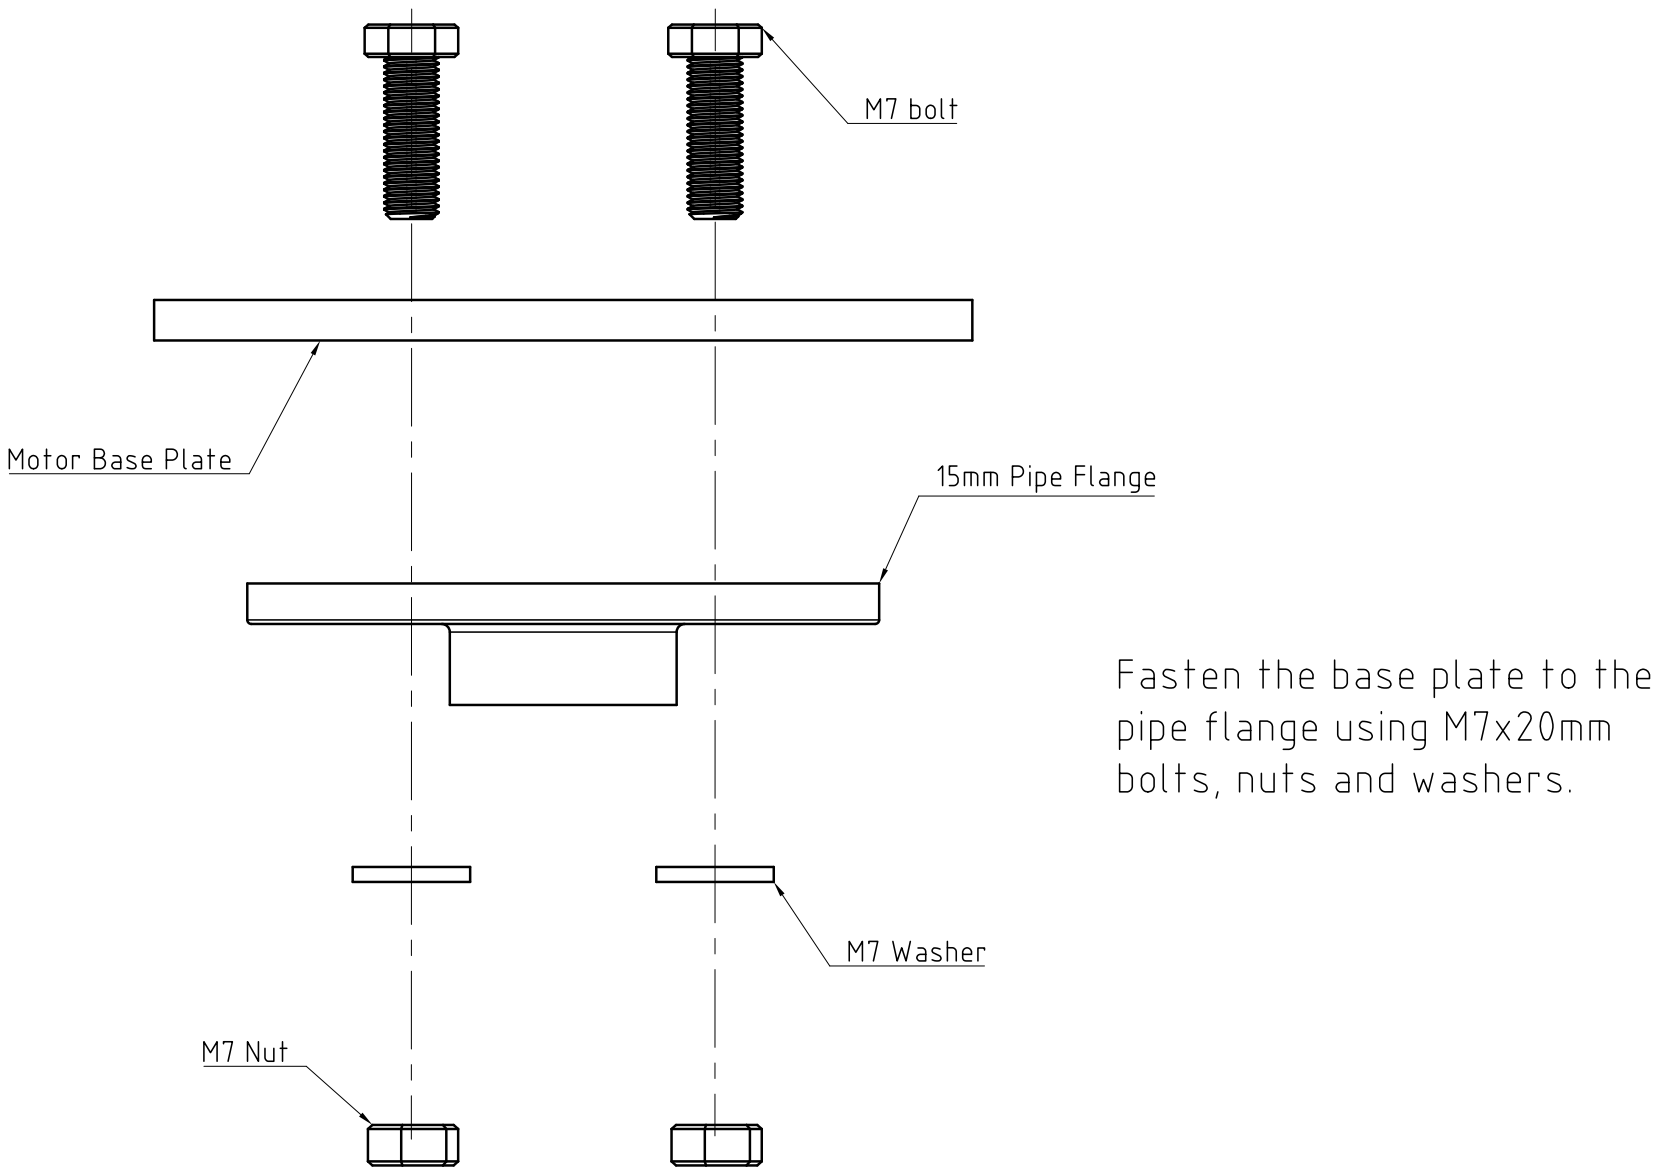
[picture p144: page 15]

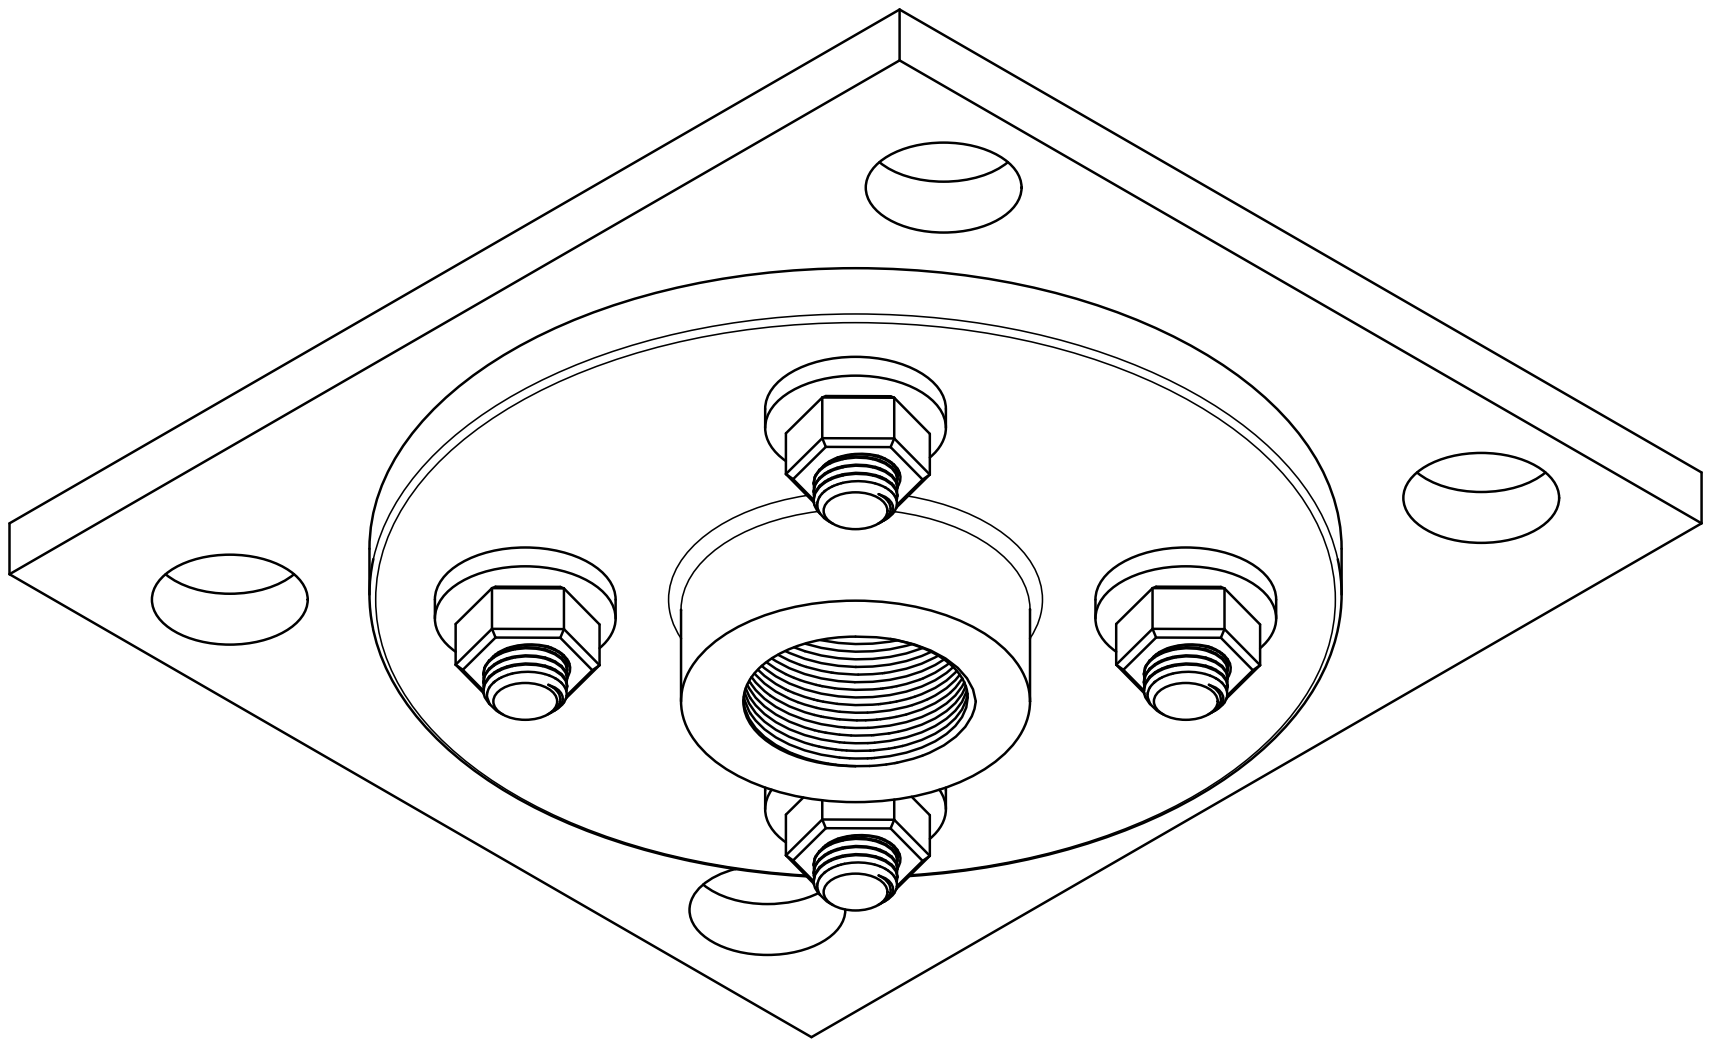
[picture p145: page 16]

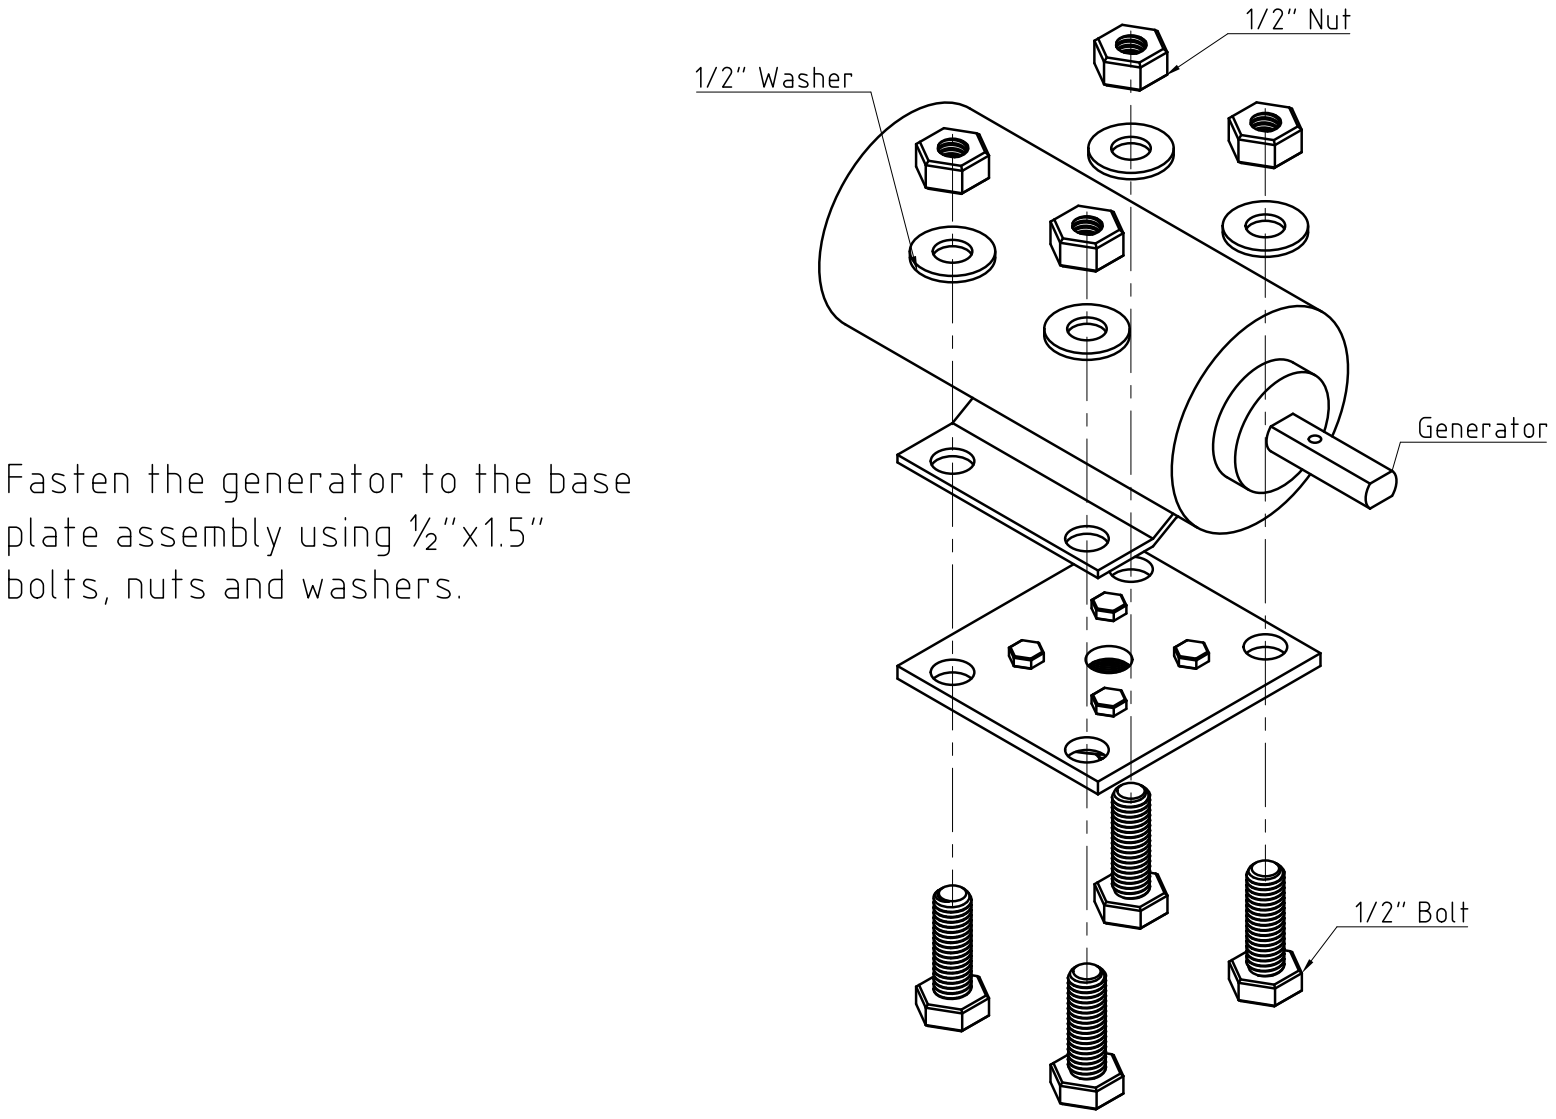
[picture p146: page 17]

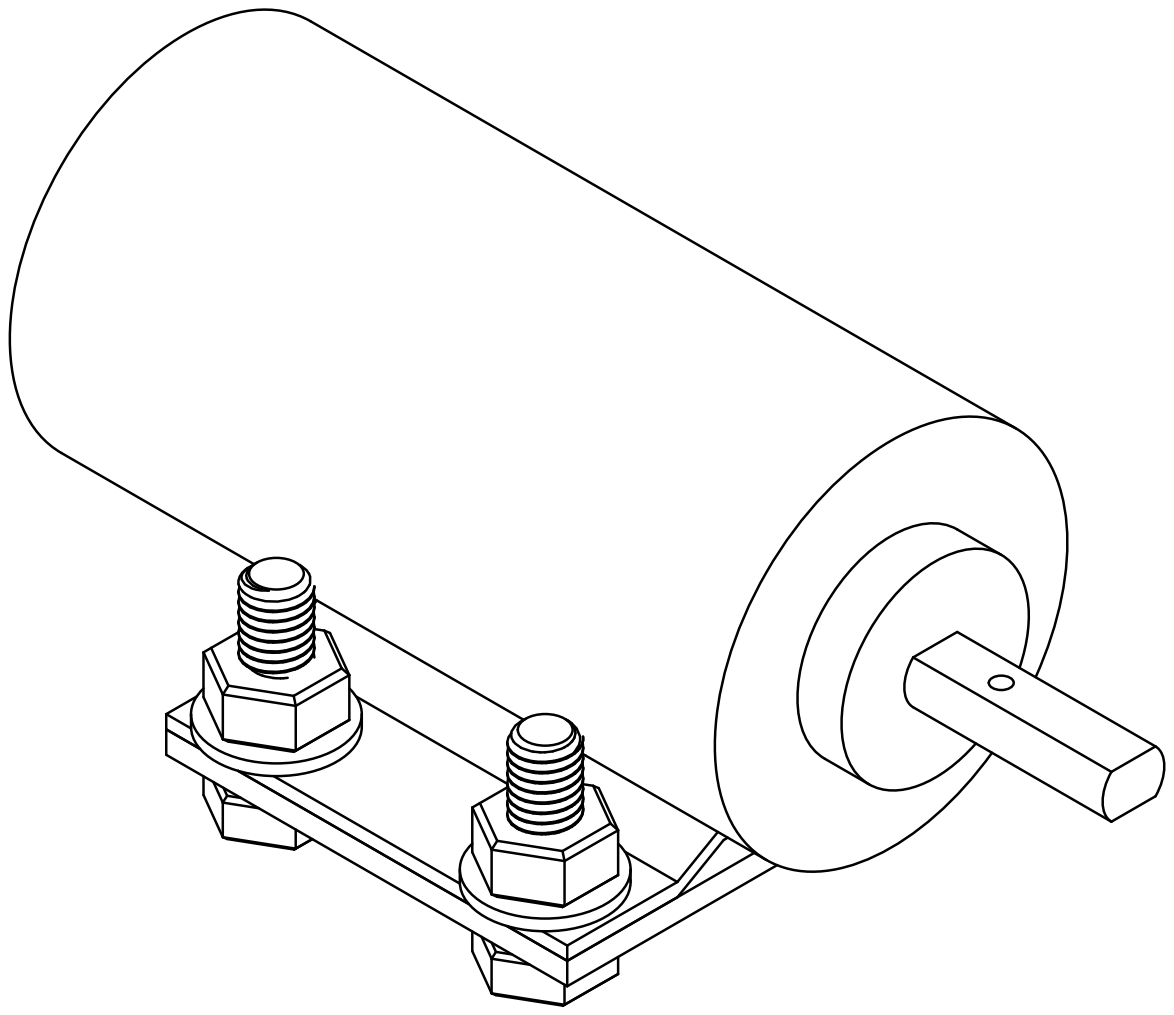
[picture p147: page 18]

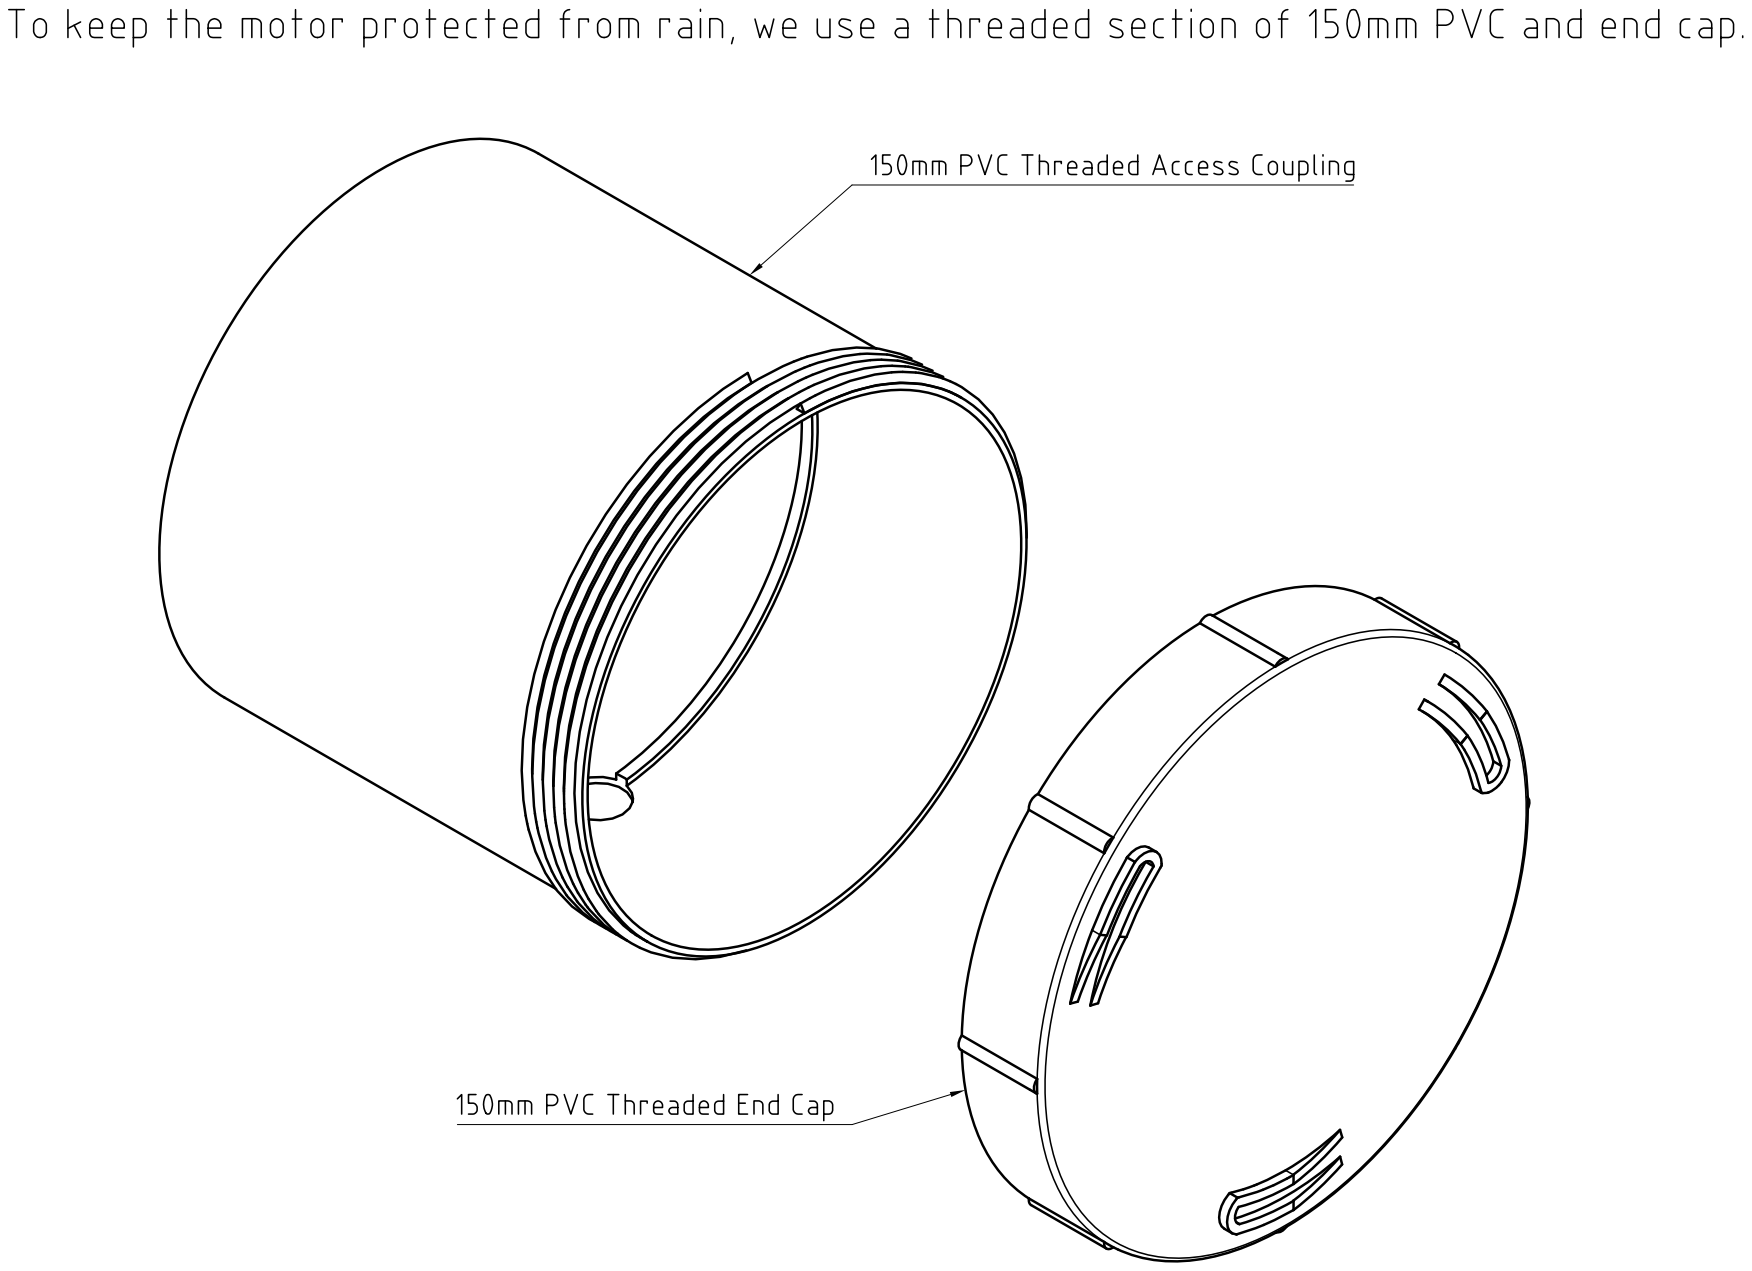
[picture p148: page 19]

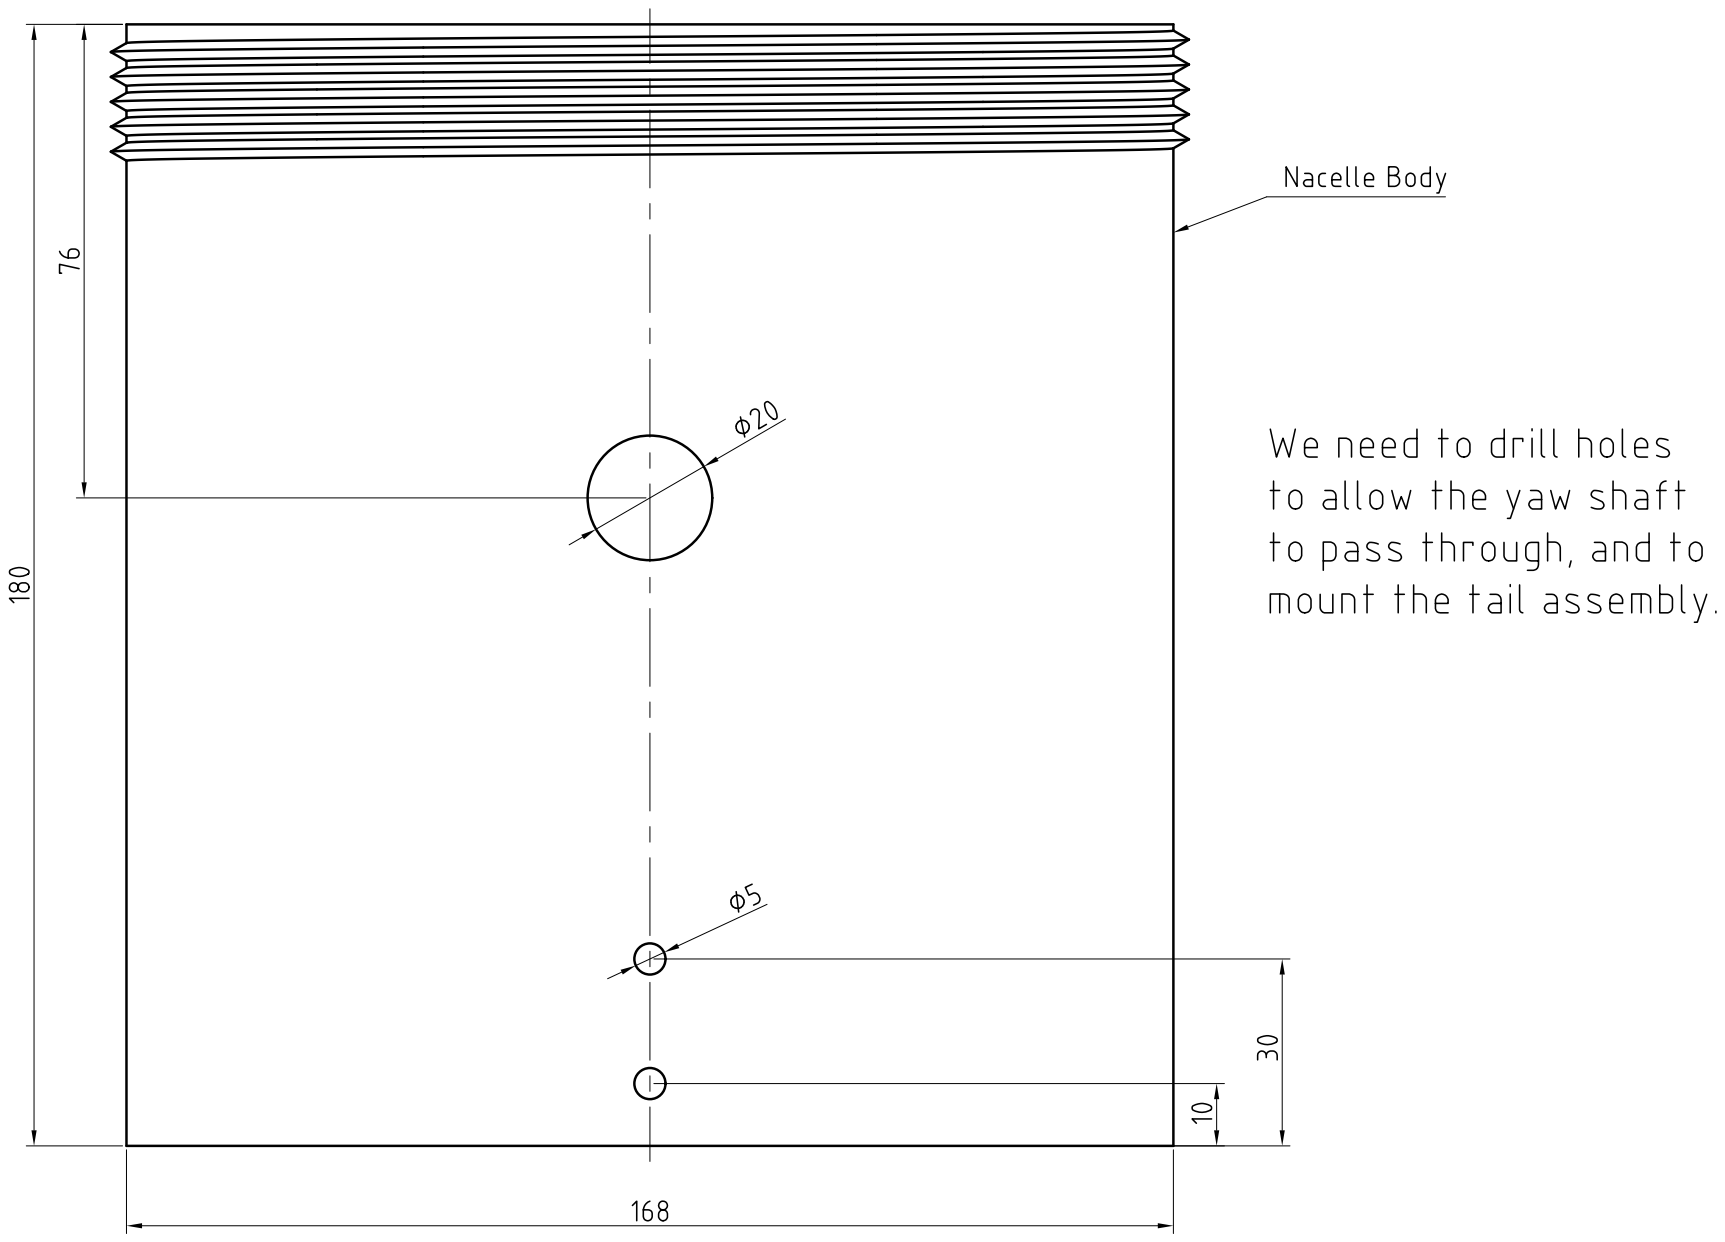
[picture p149: page 20]

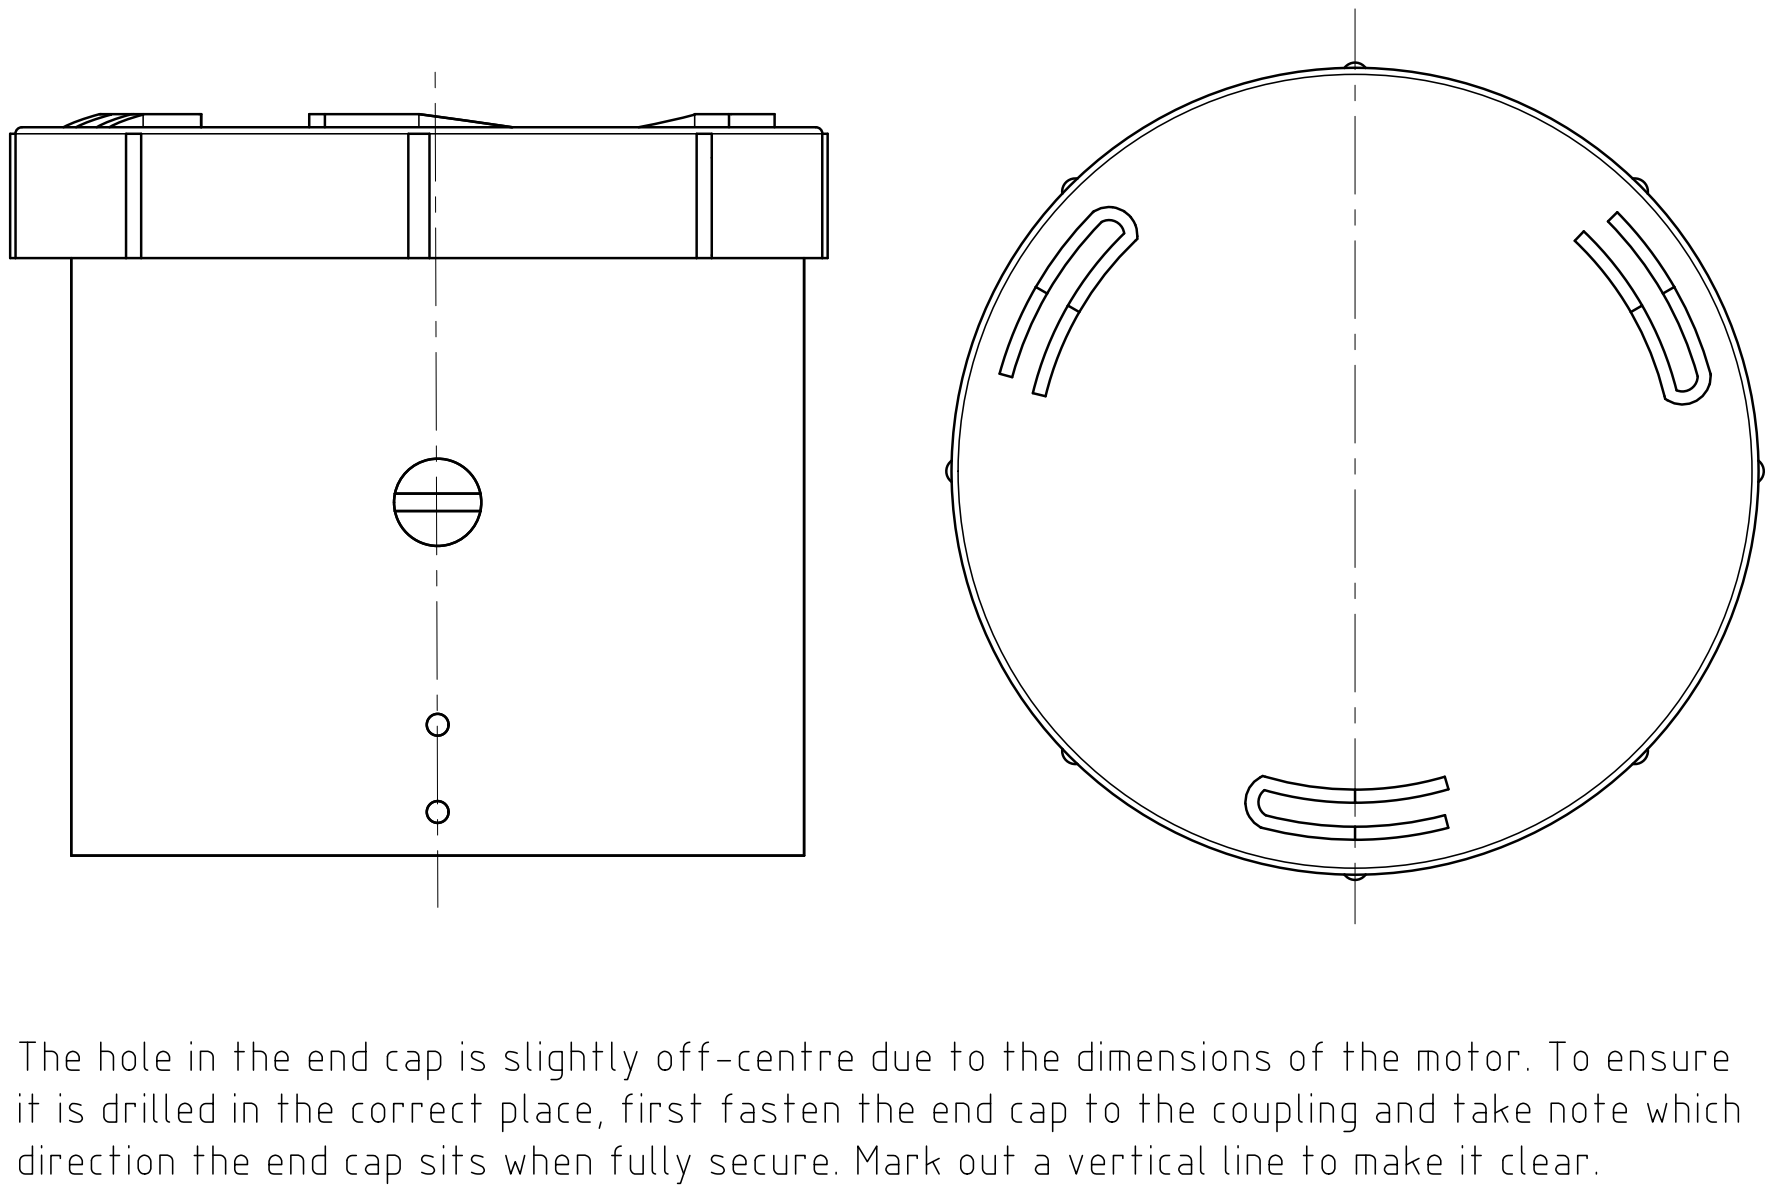
[picture p150: page 21]

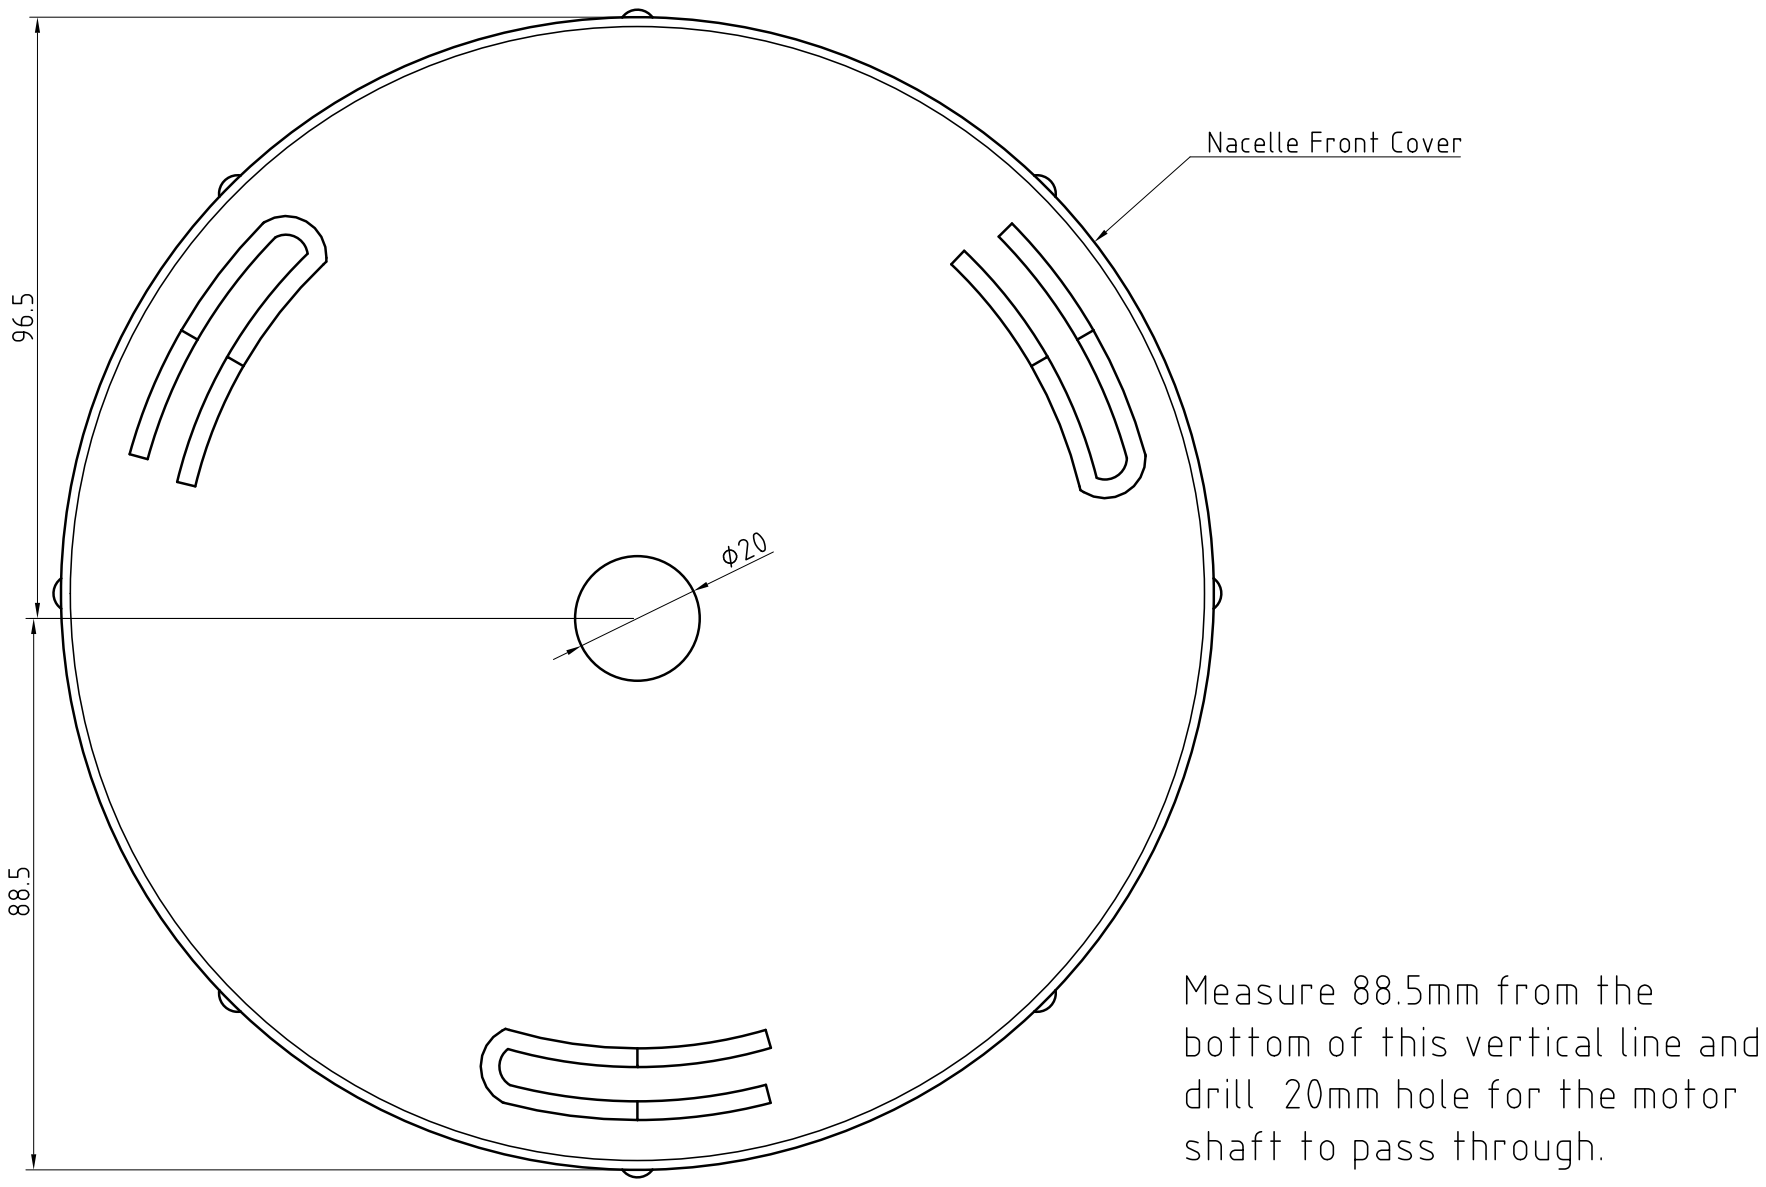
[picture p151: page 22]

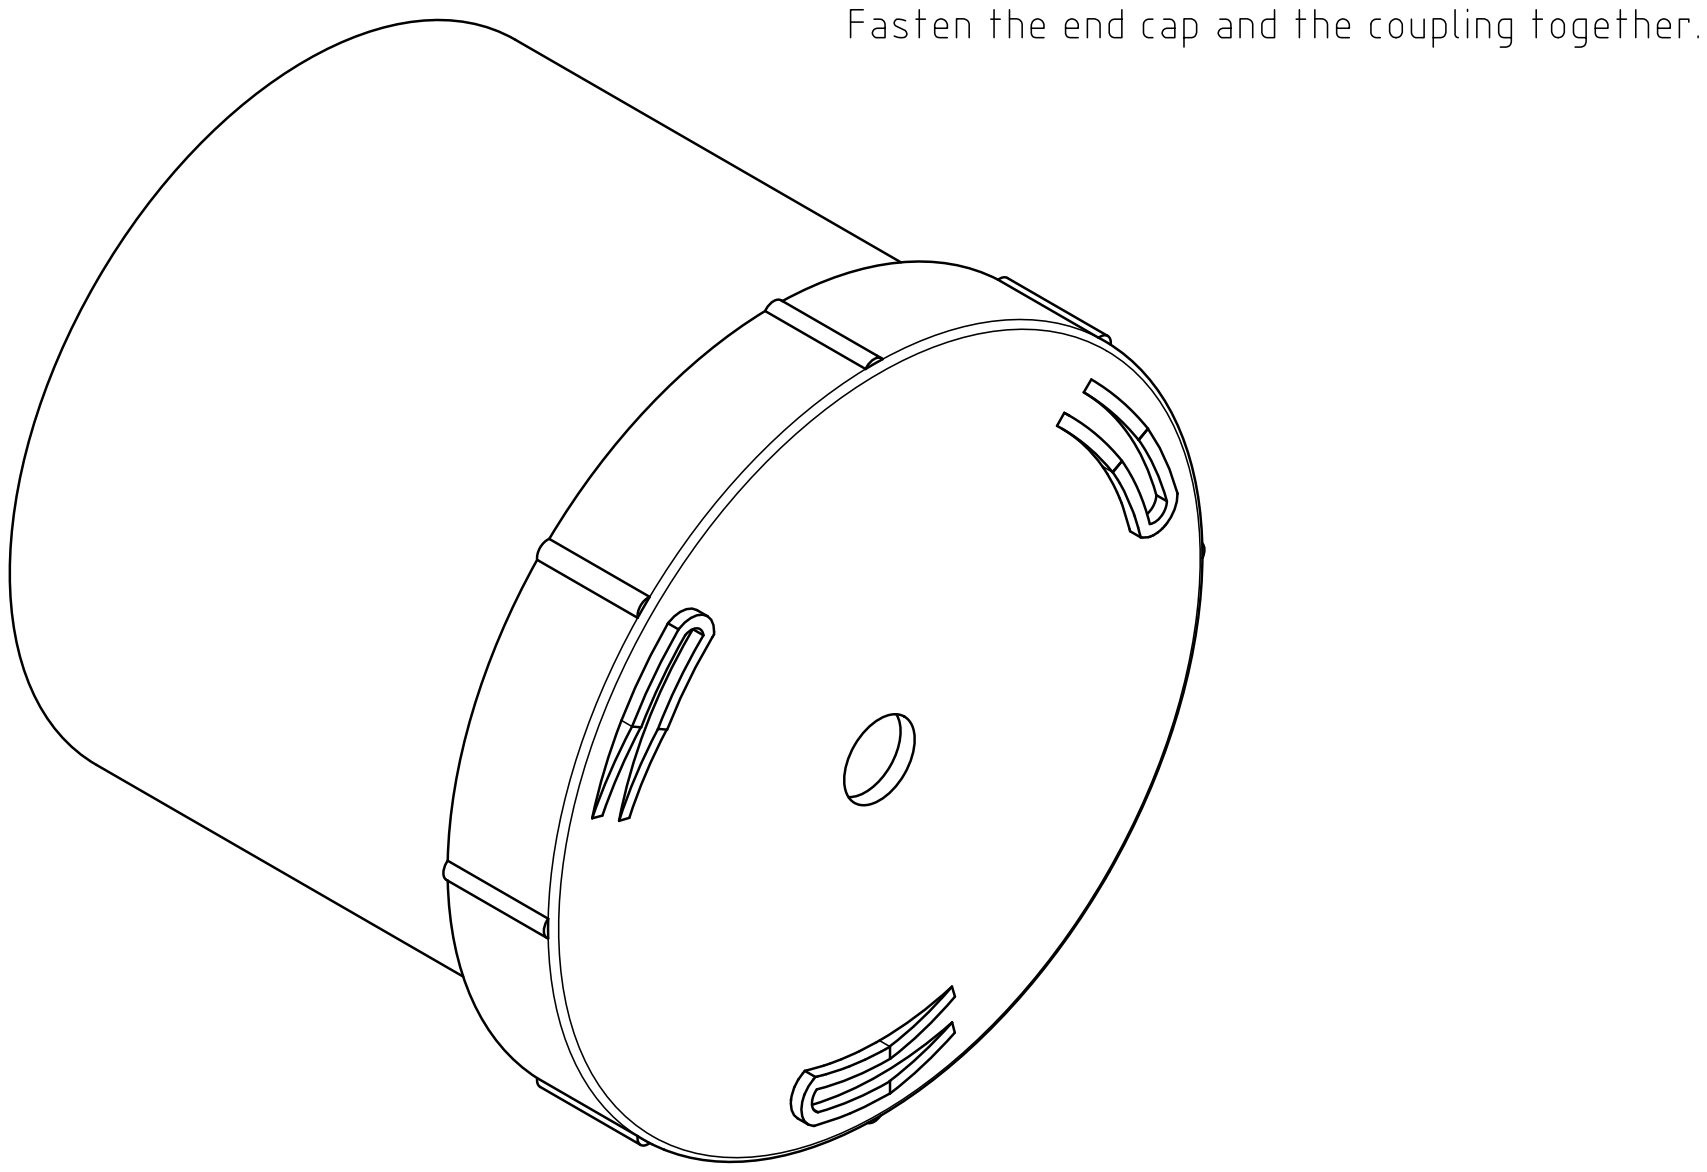
[picture p152: page 23]

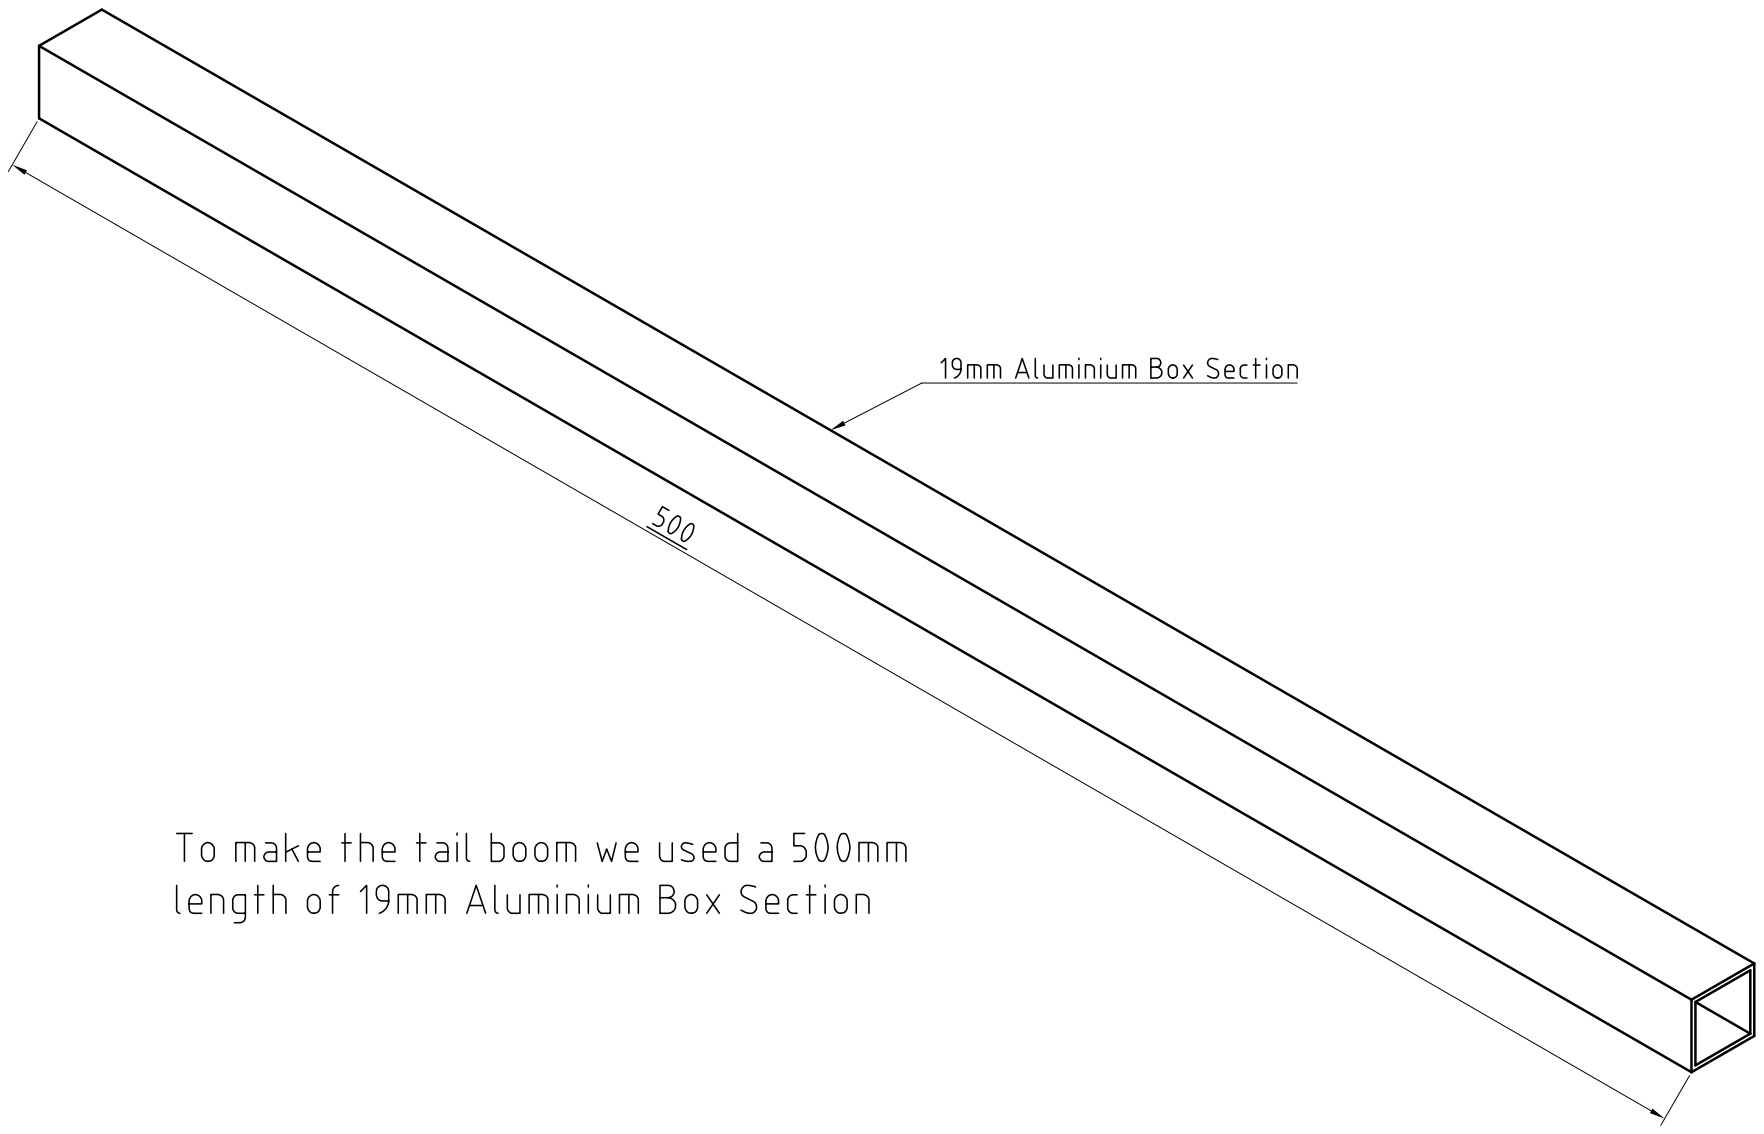
[picture p153: page 24]

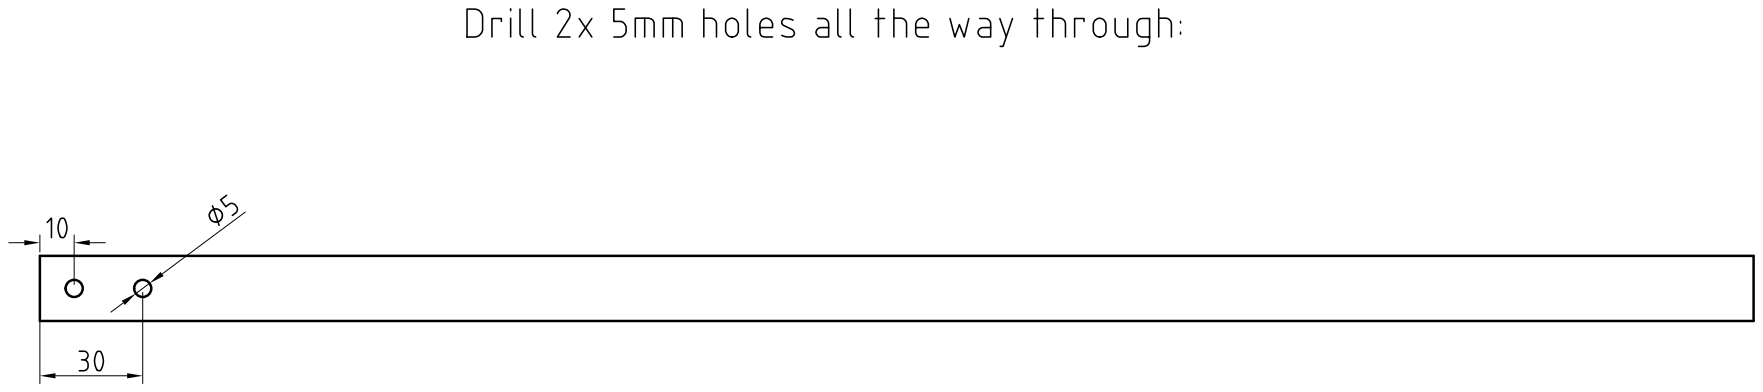
[picture p154: page 25]

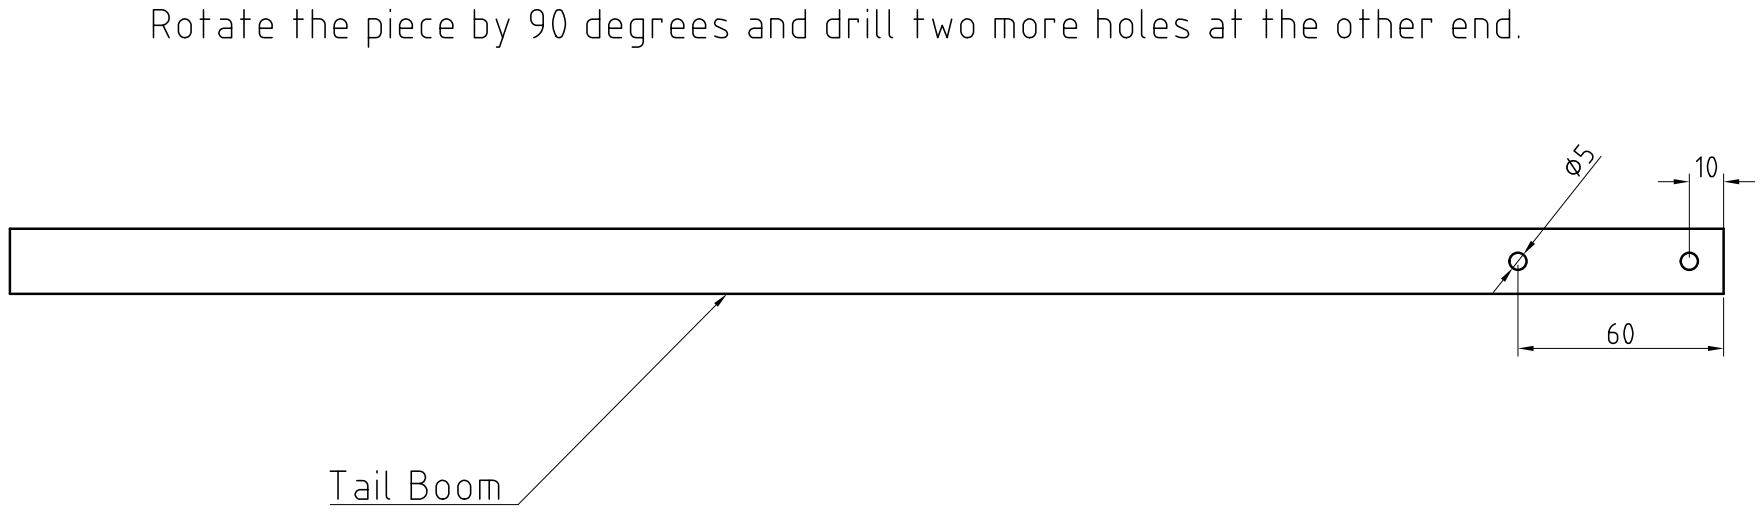
[picture p155: page 26]

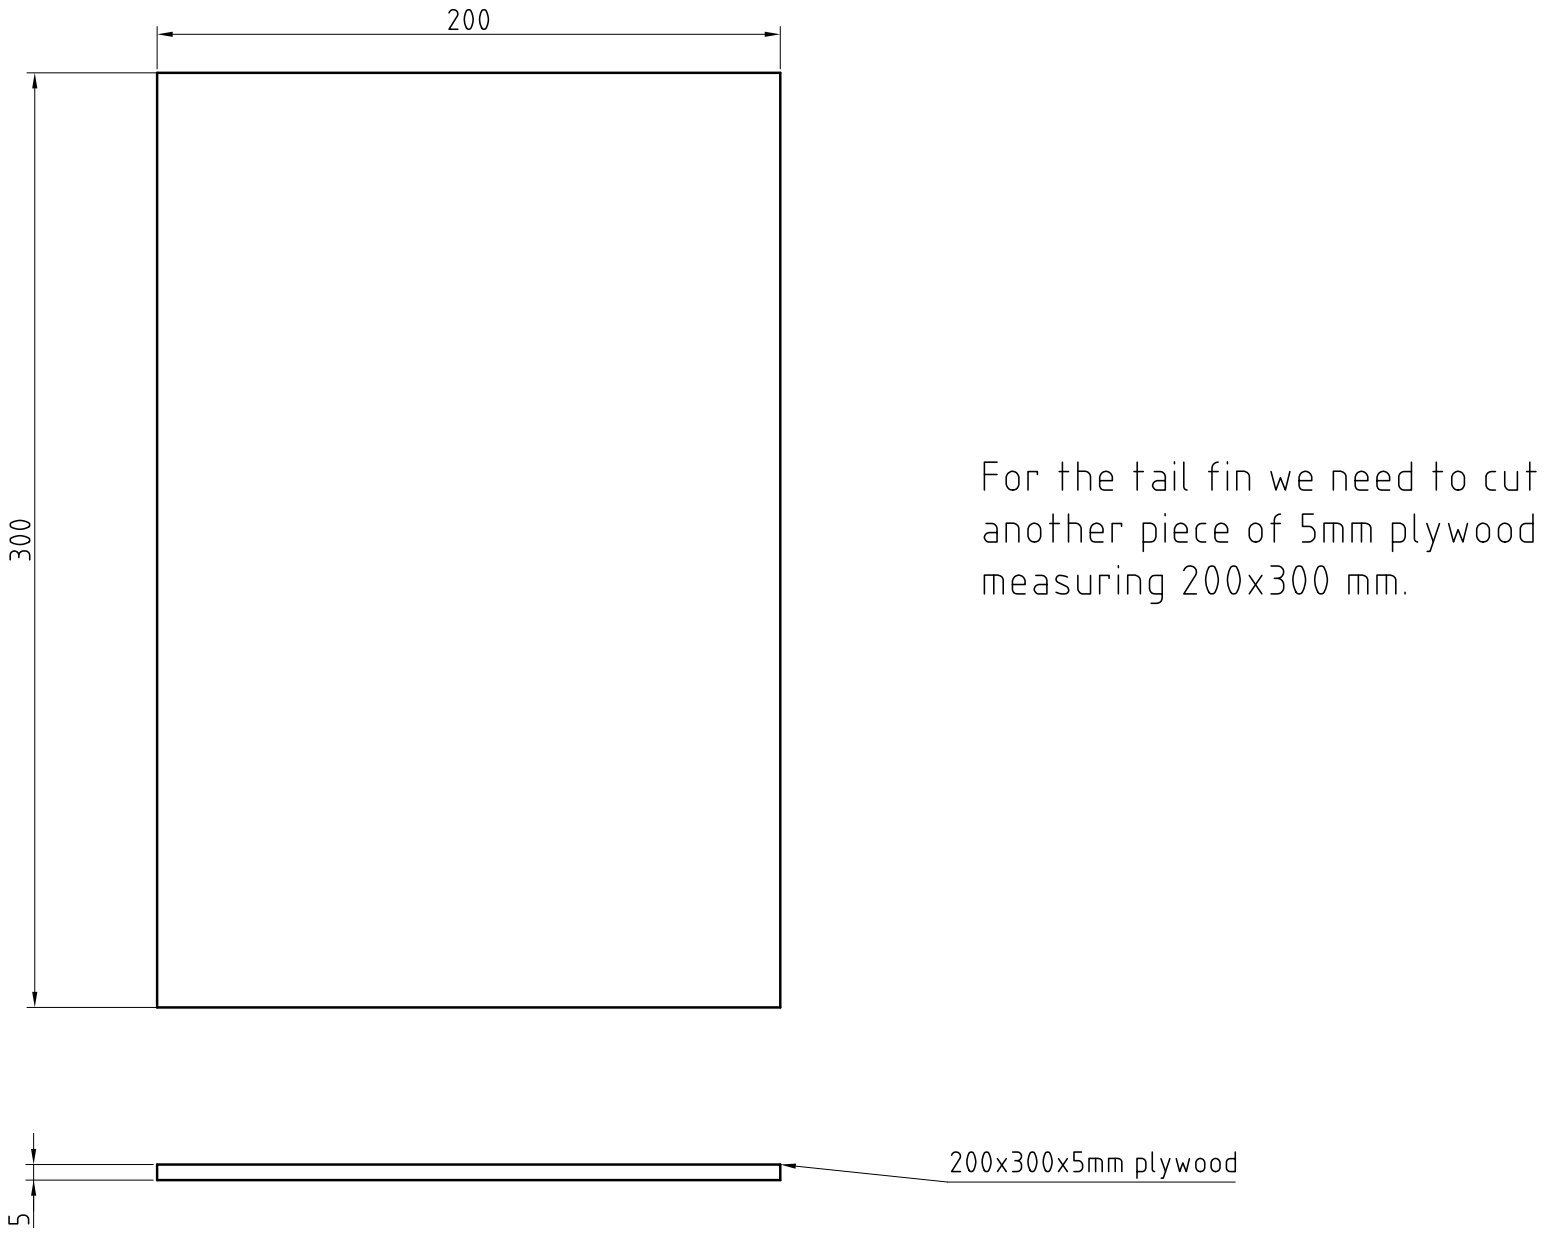
[picture p156: page 27]

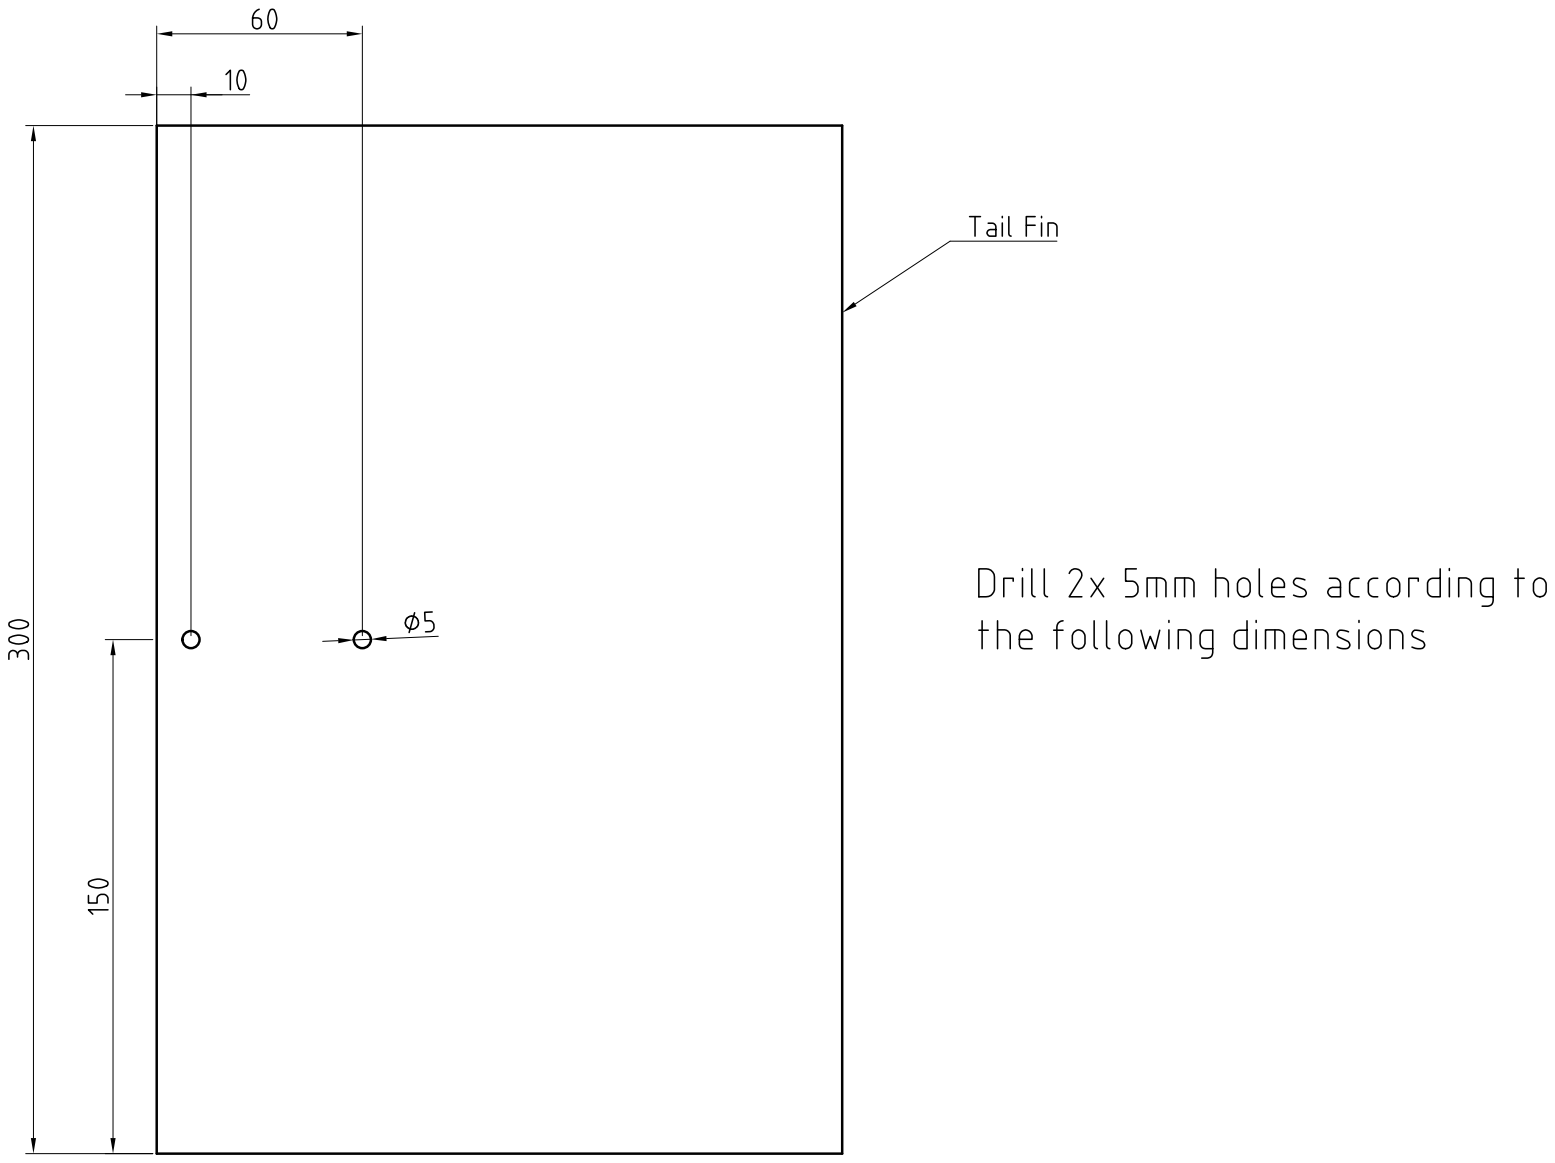
[picture p157: page 28]

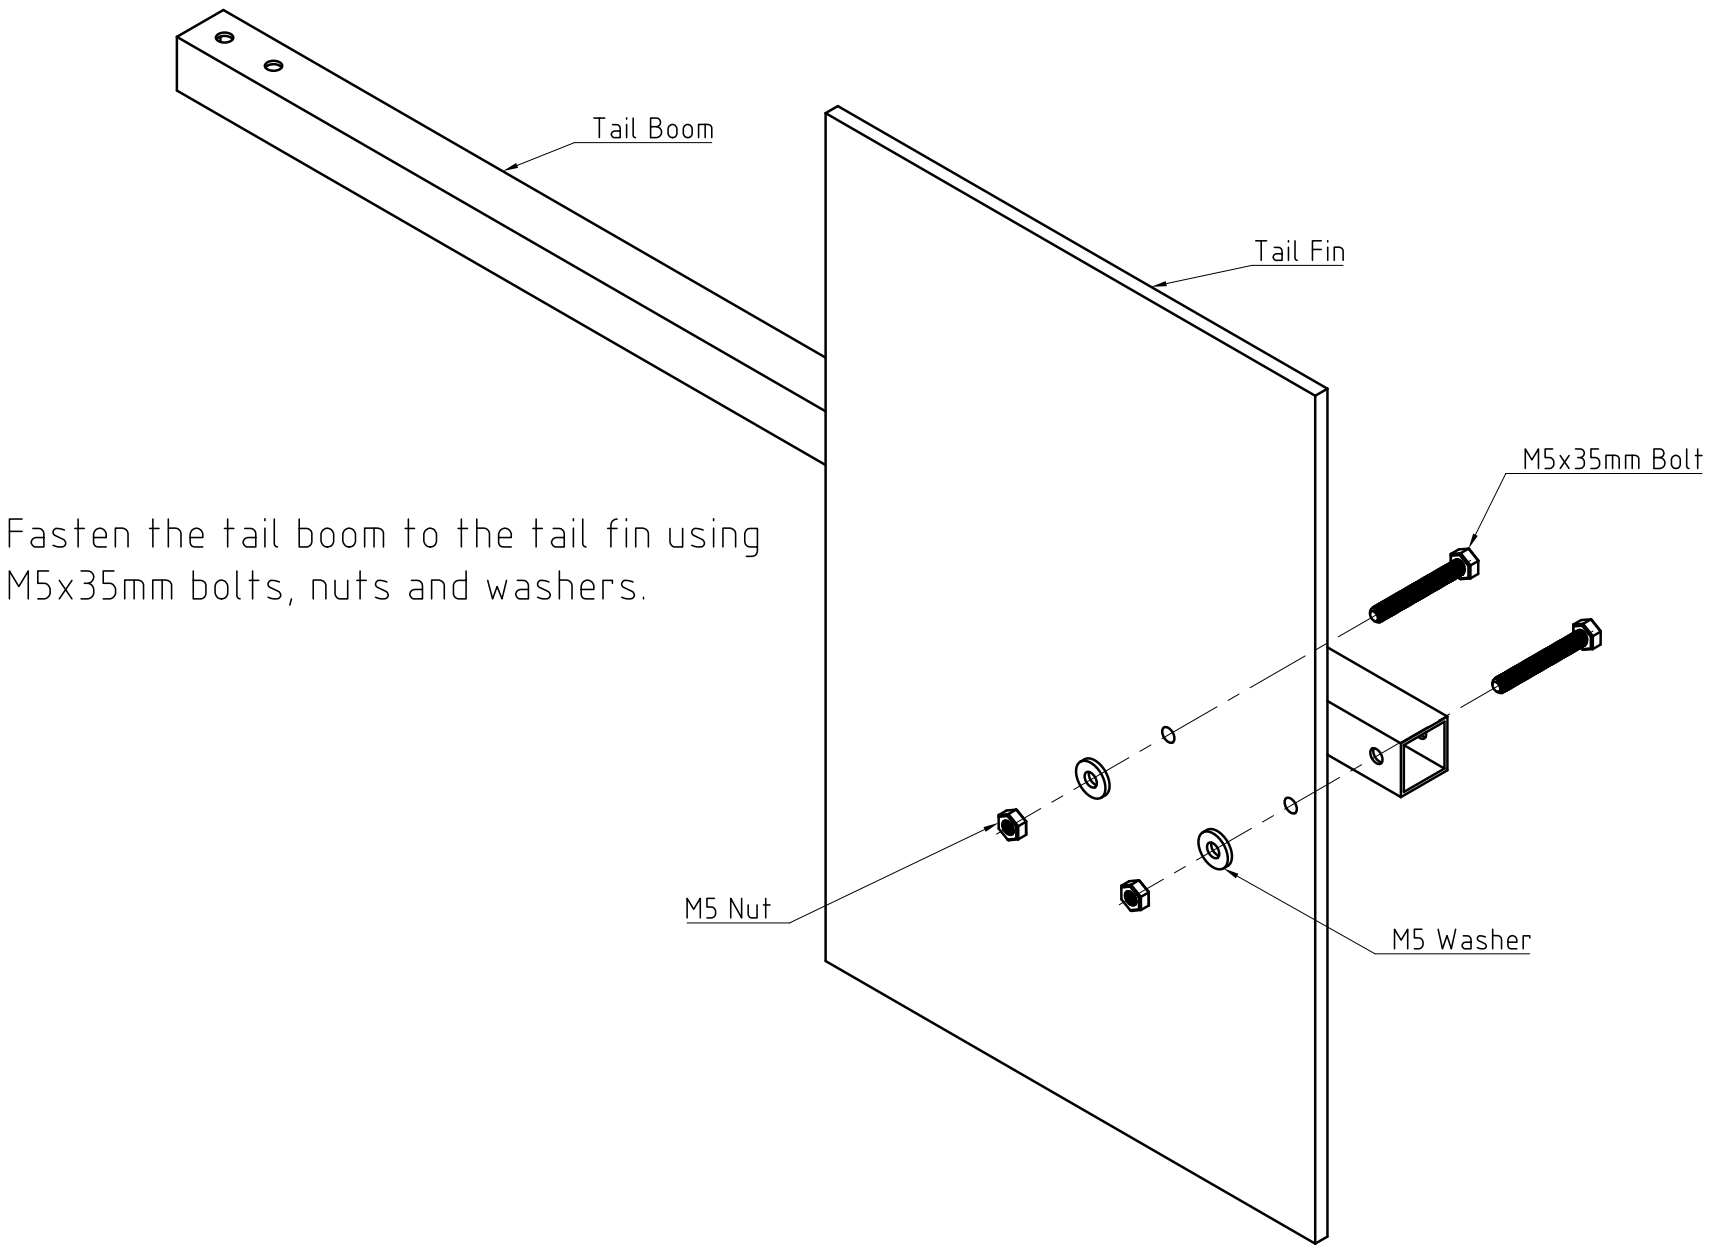
[picture p158: page 29]

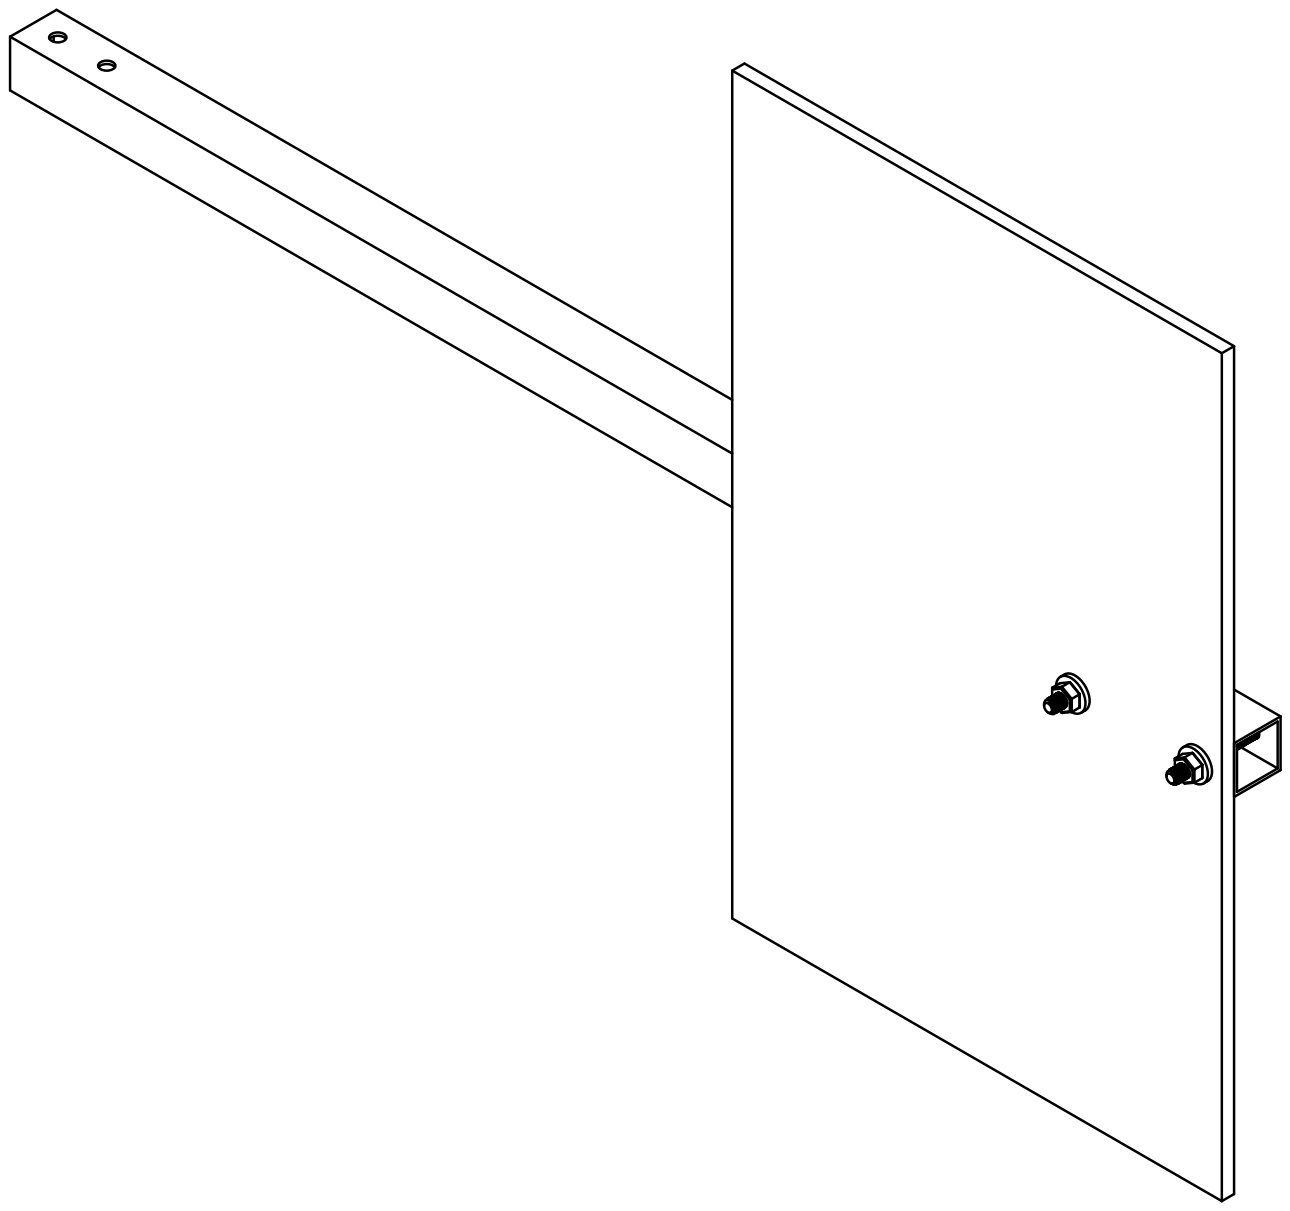
[picture p159: page 30]

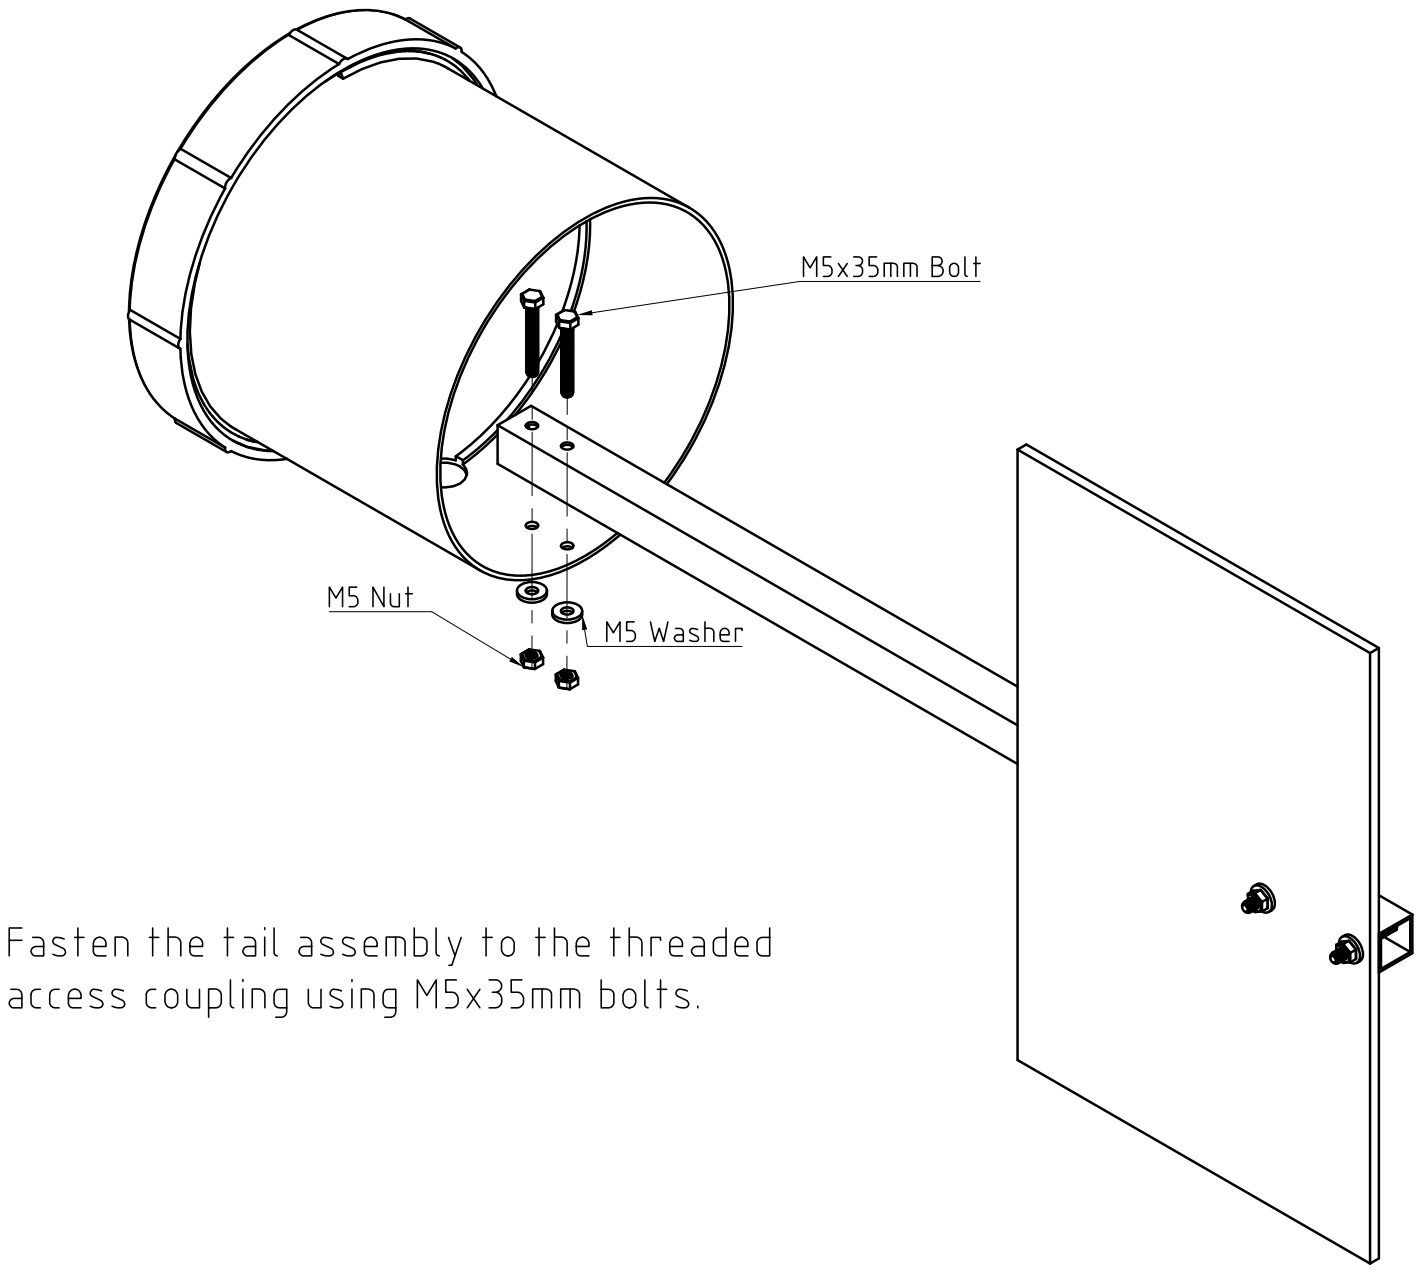
[picture p160: page 31]

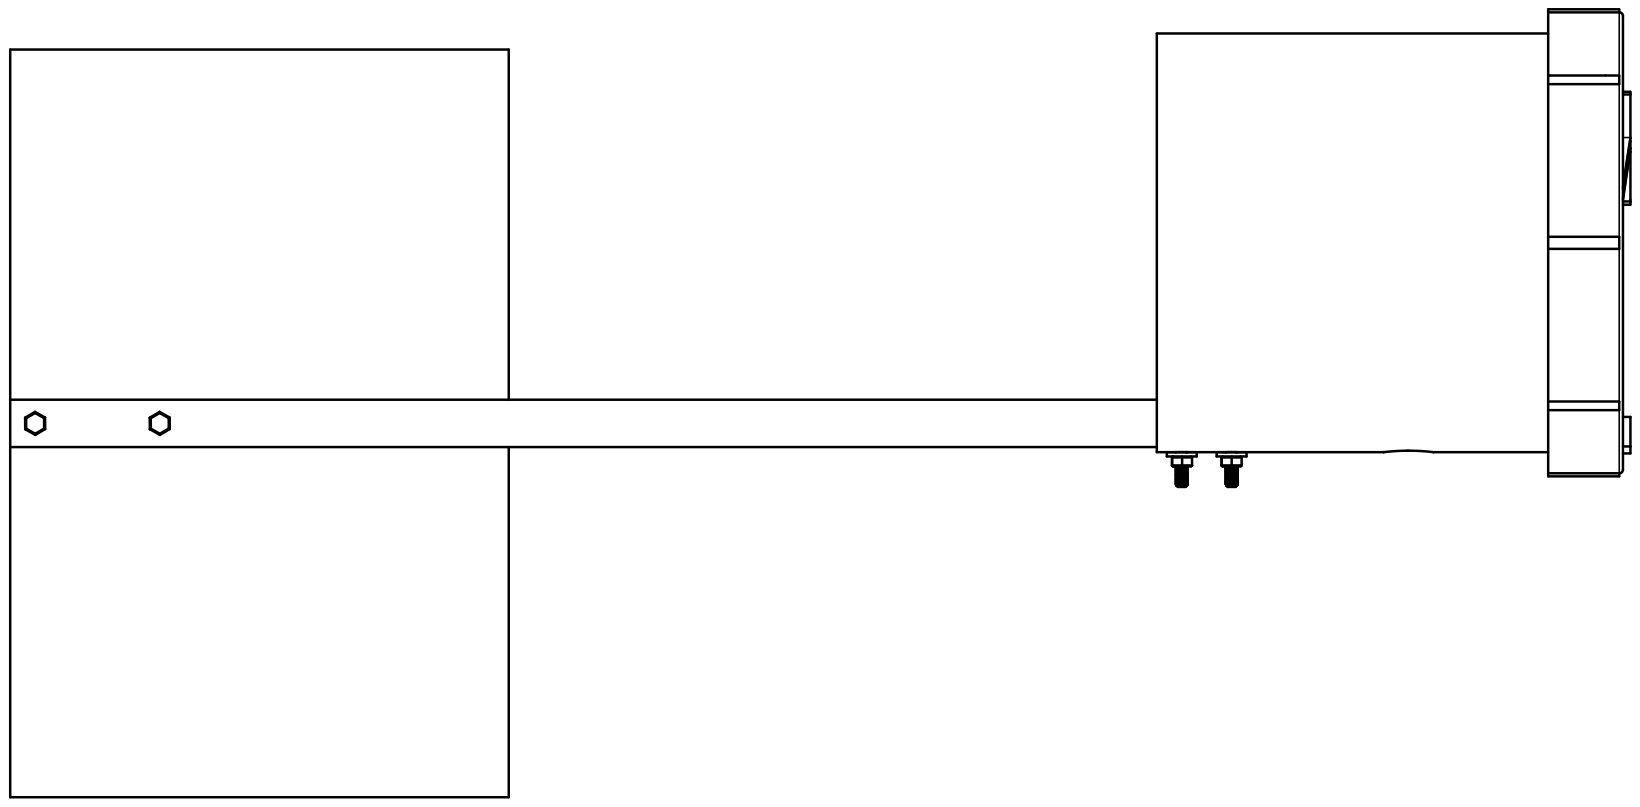
[picture p161: page 32]

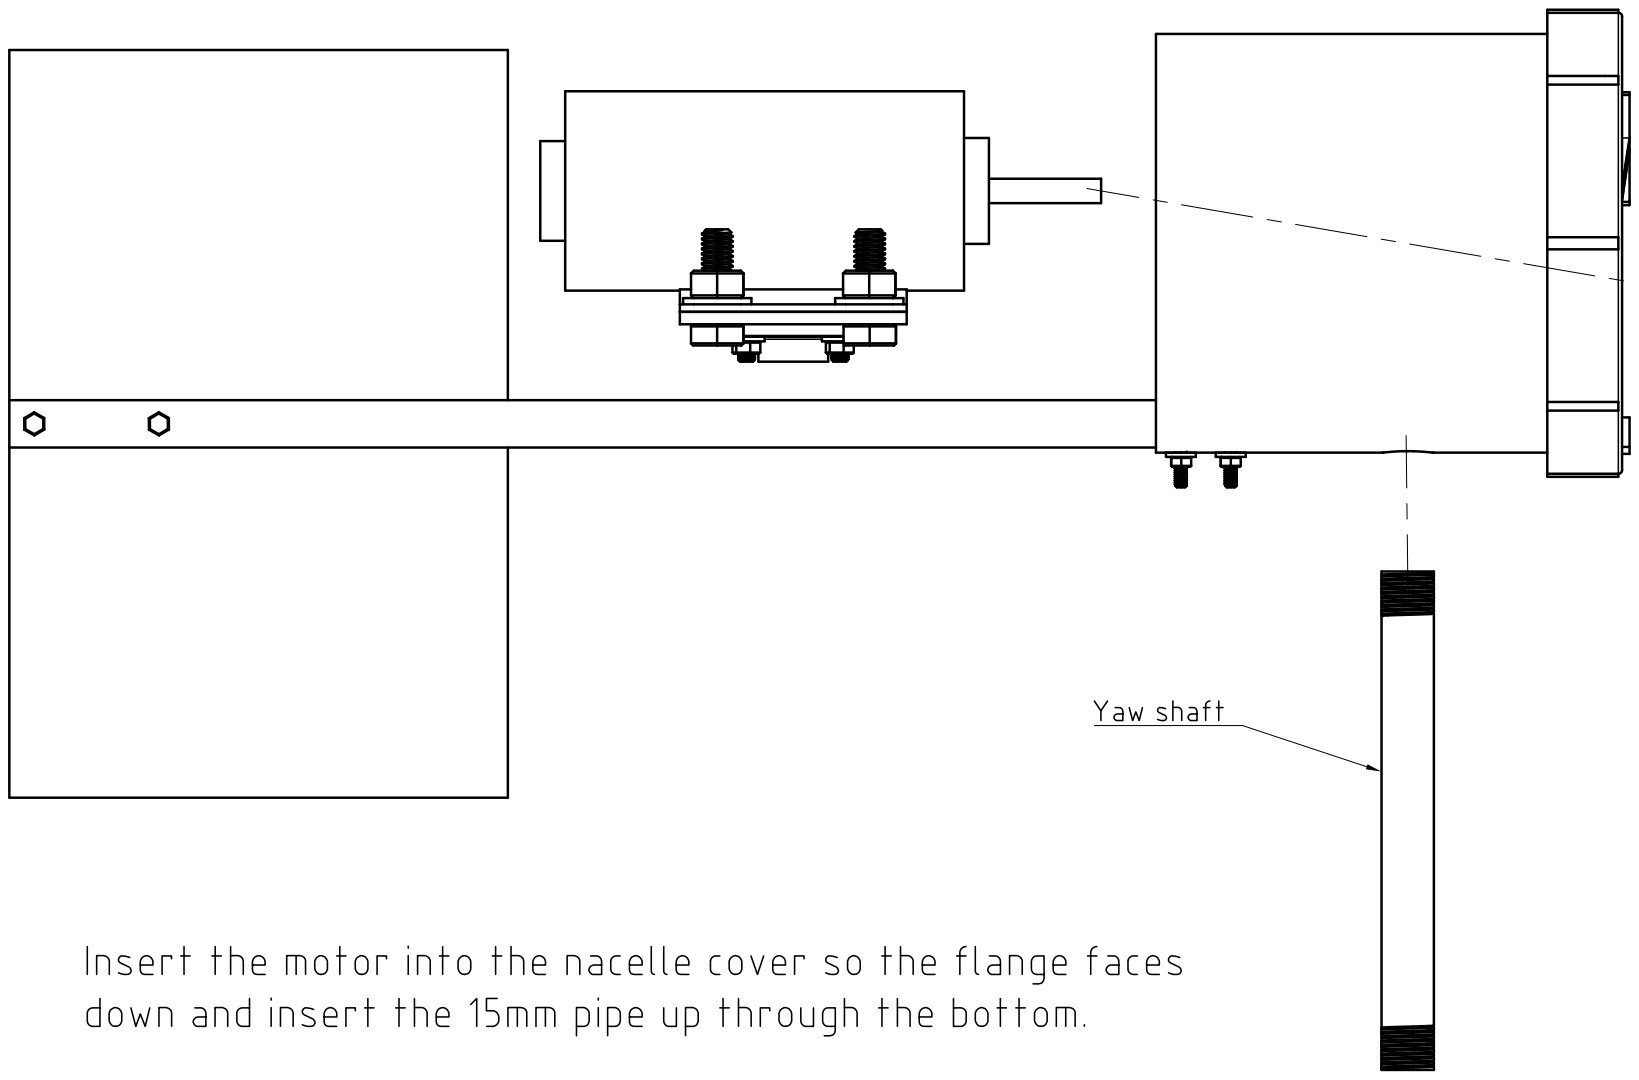
[picture p162: page 33]

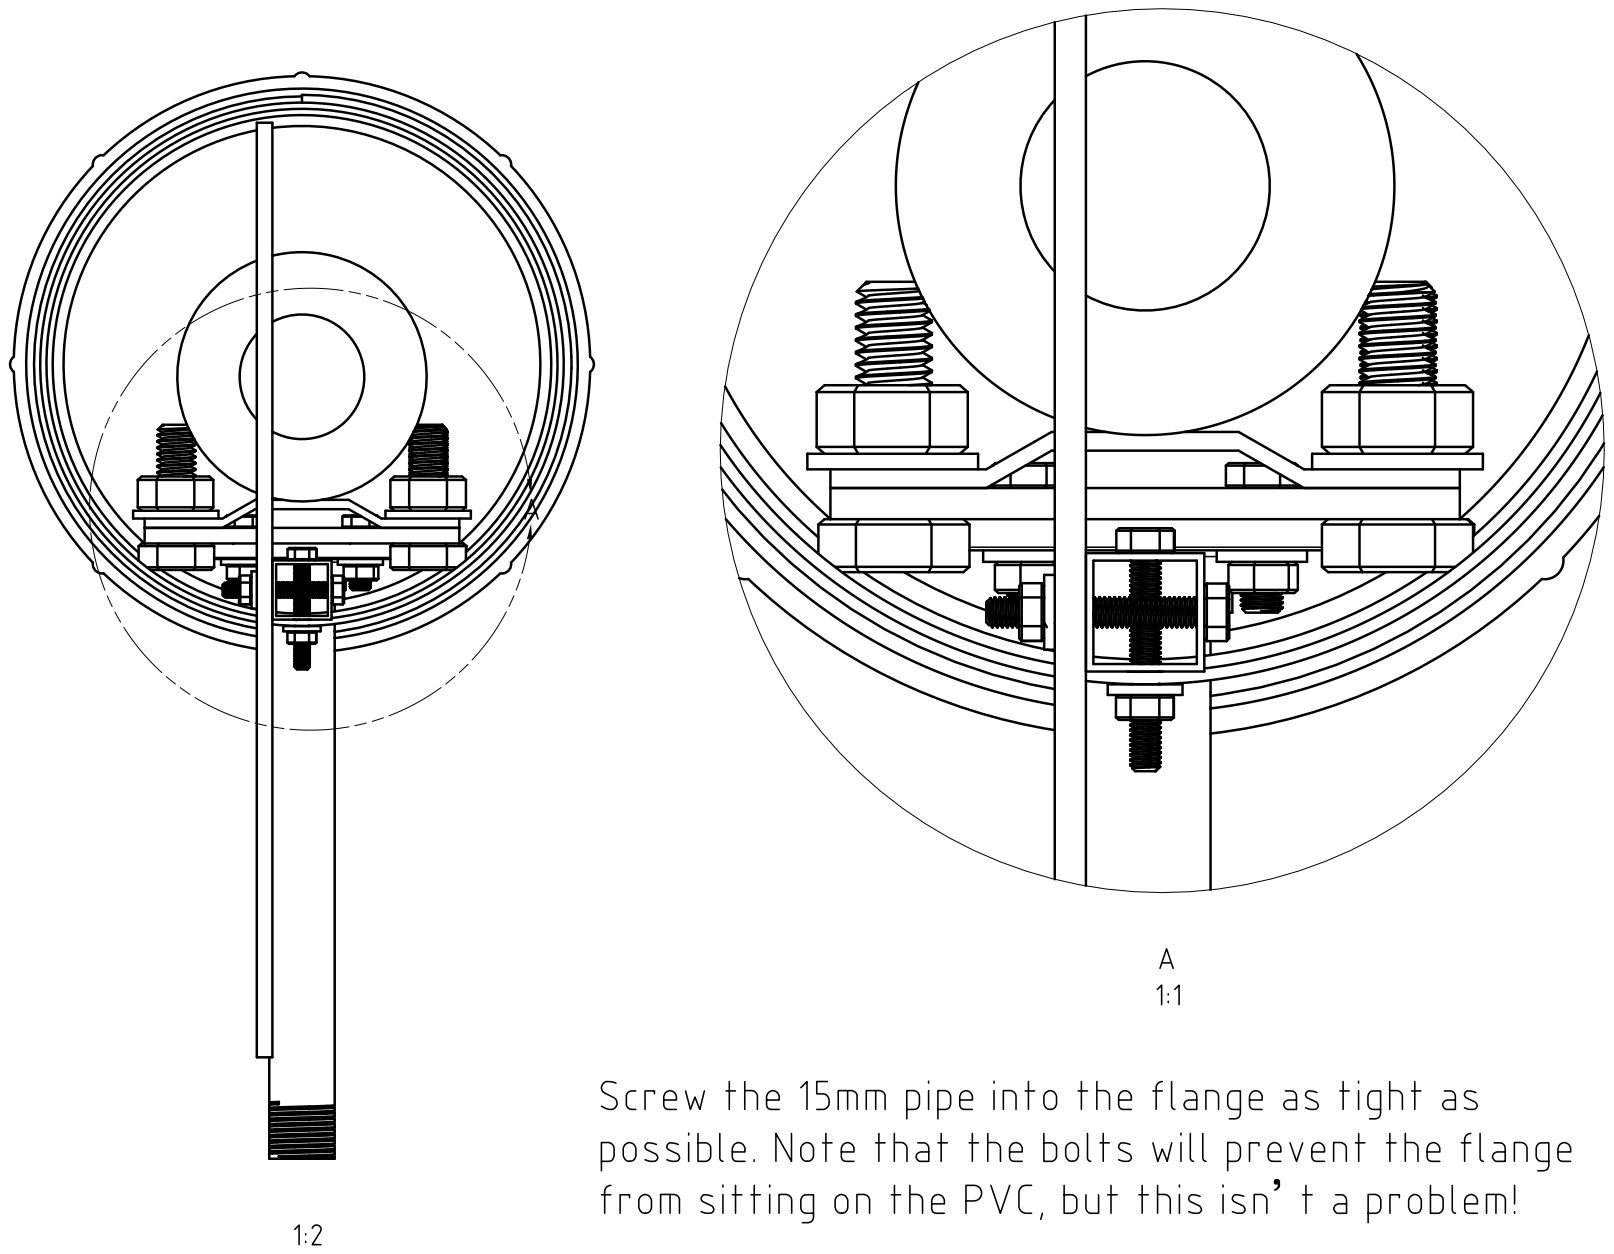
[picture p163: page 34]

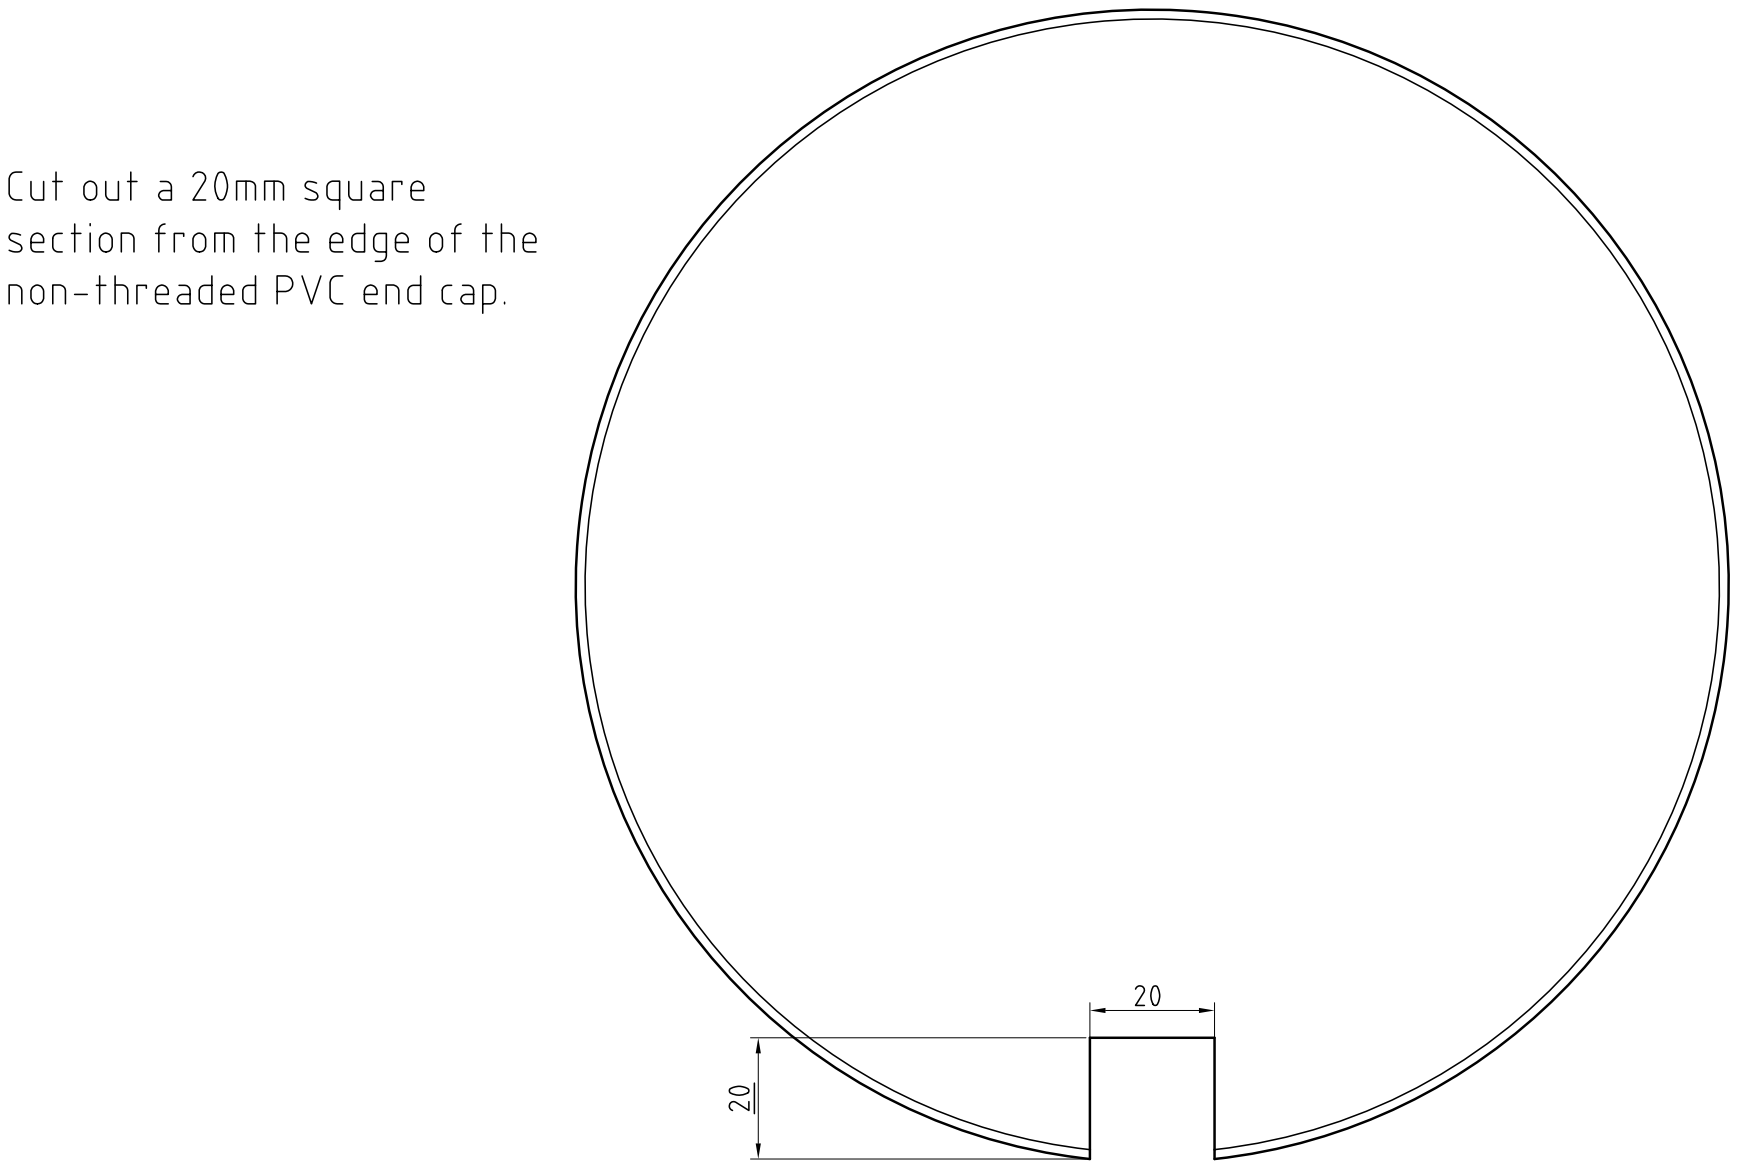
[picture p164: page 35]

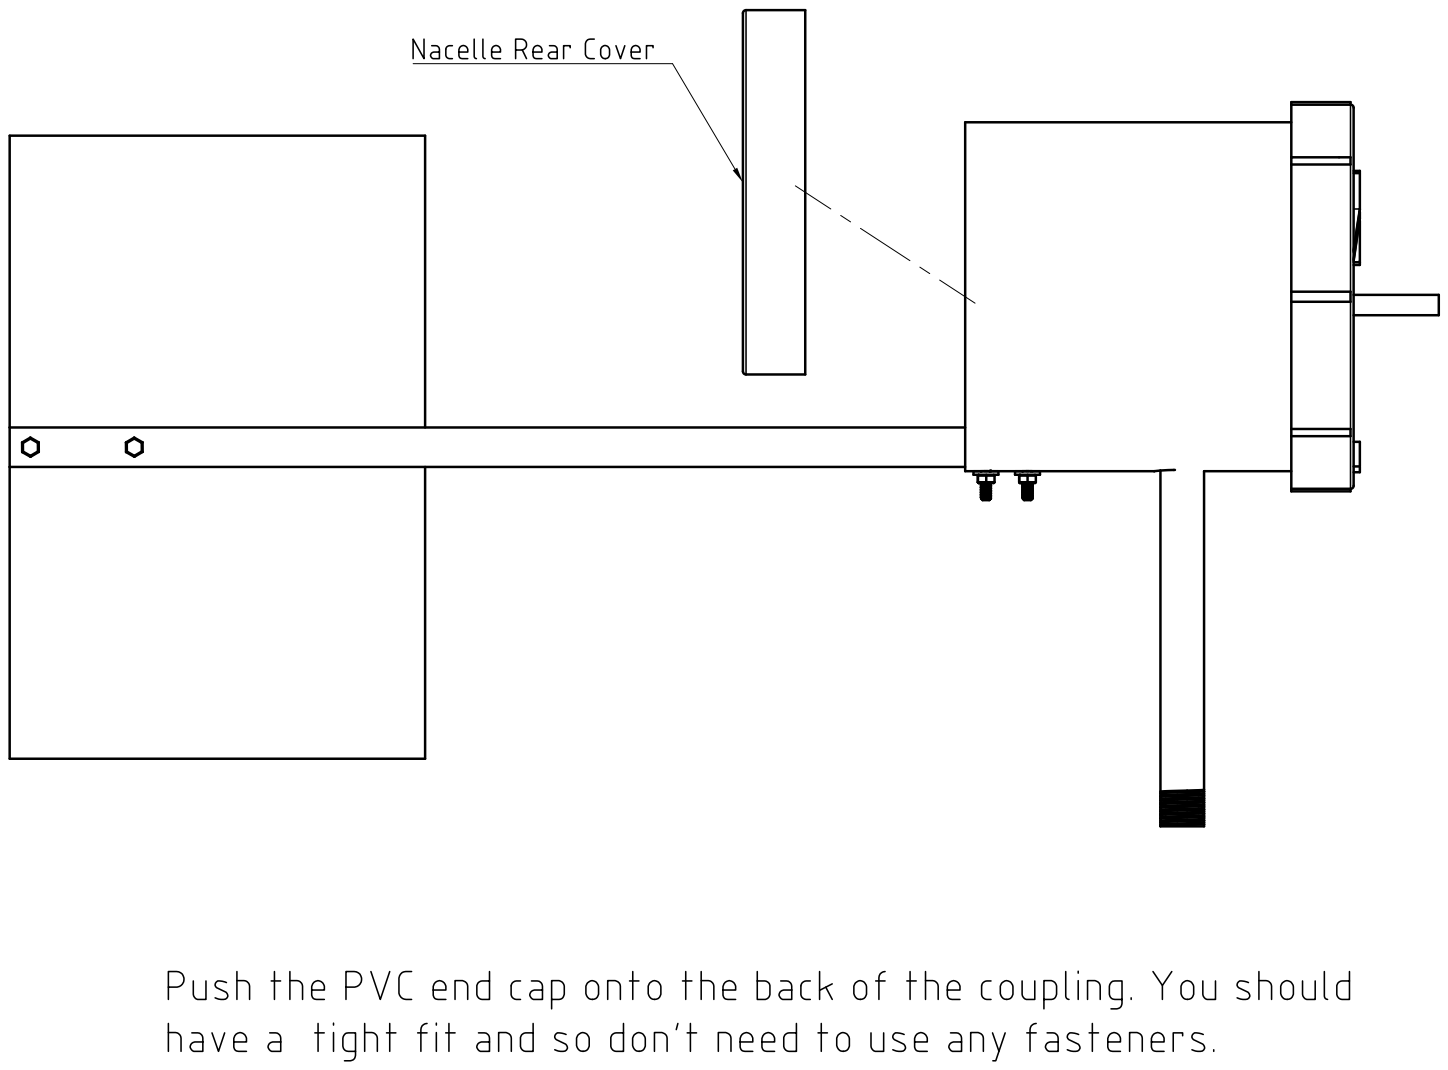
[picture p165: page 36]

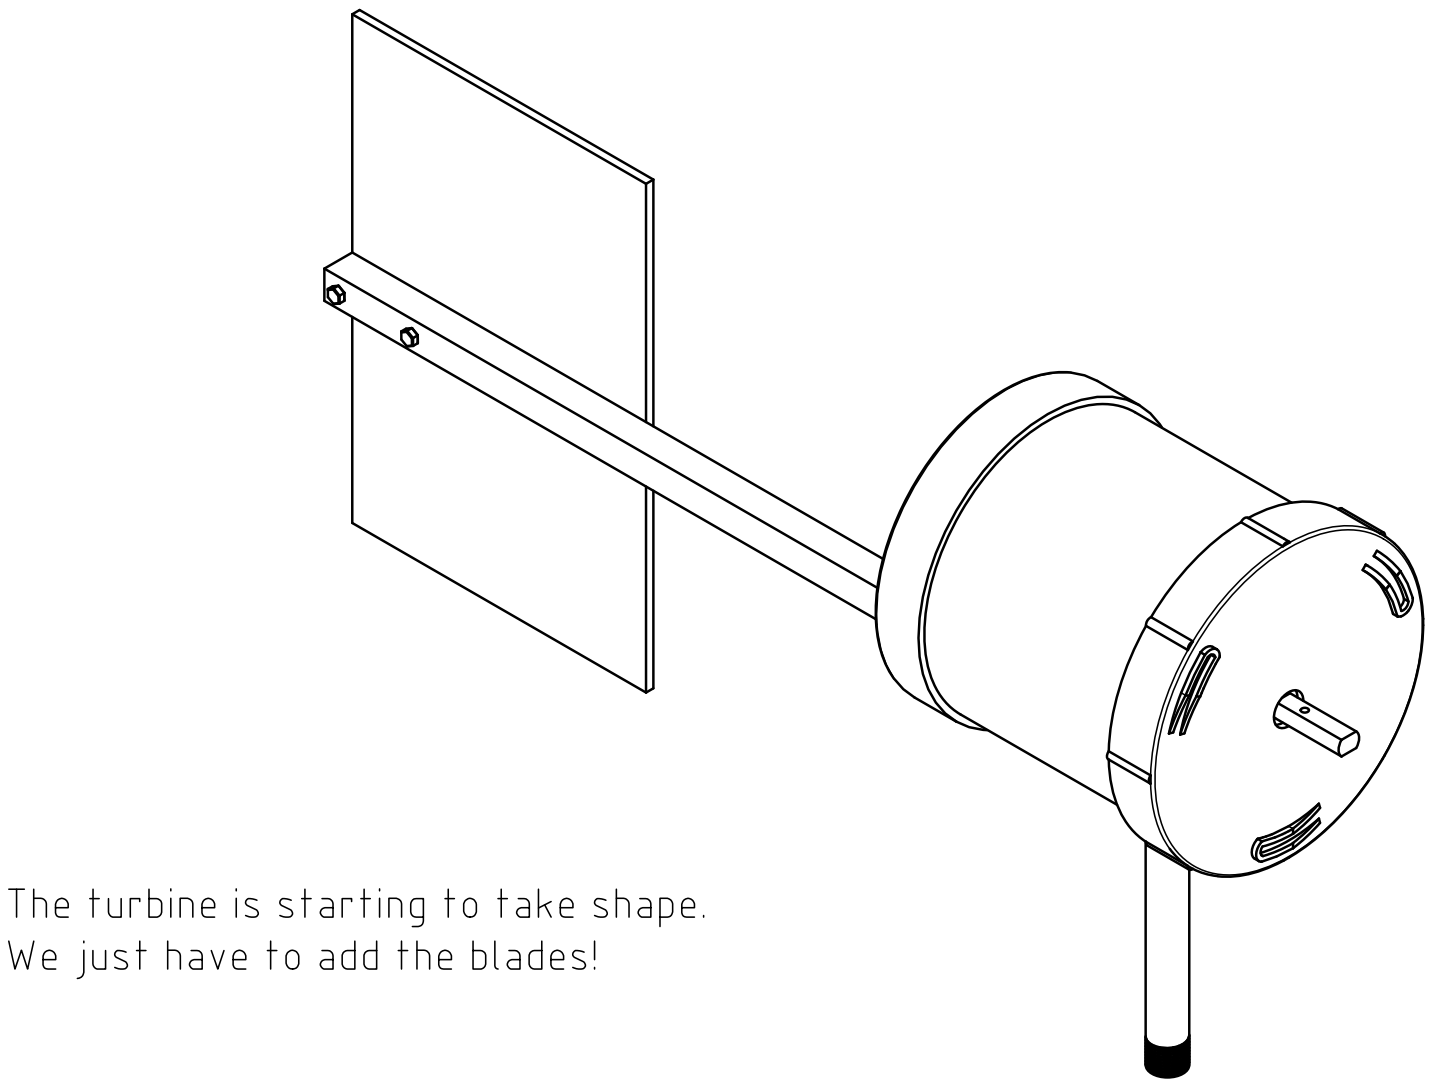
[picture p166: page 37]

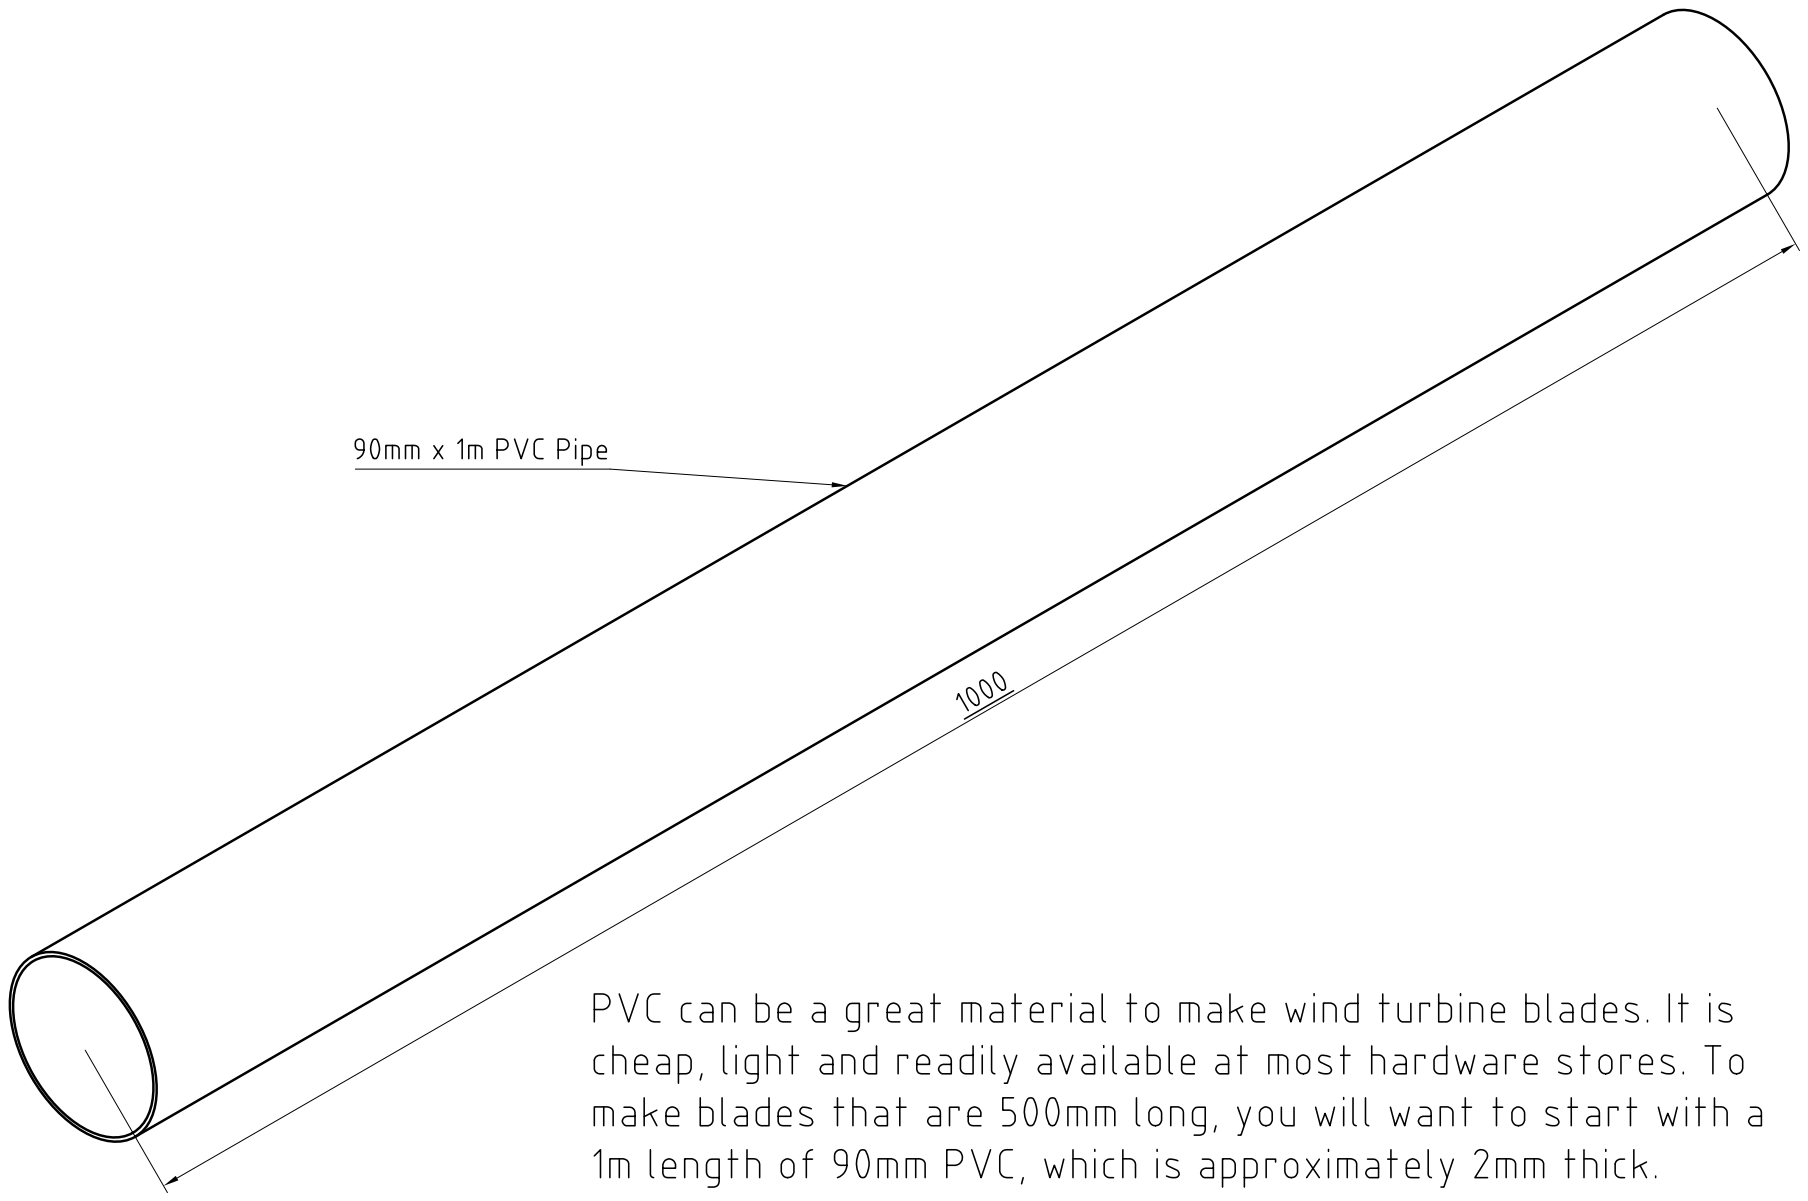
[picture p167: page 38]

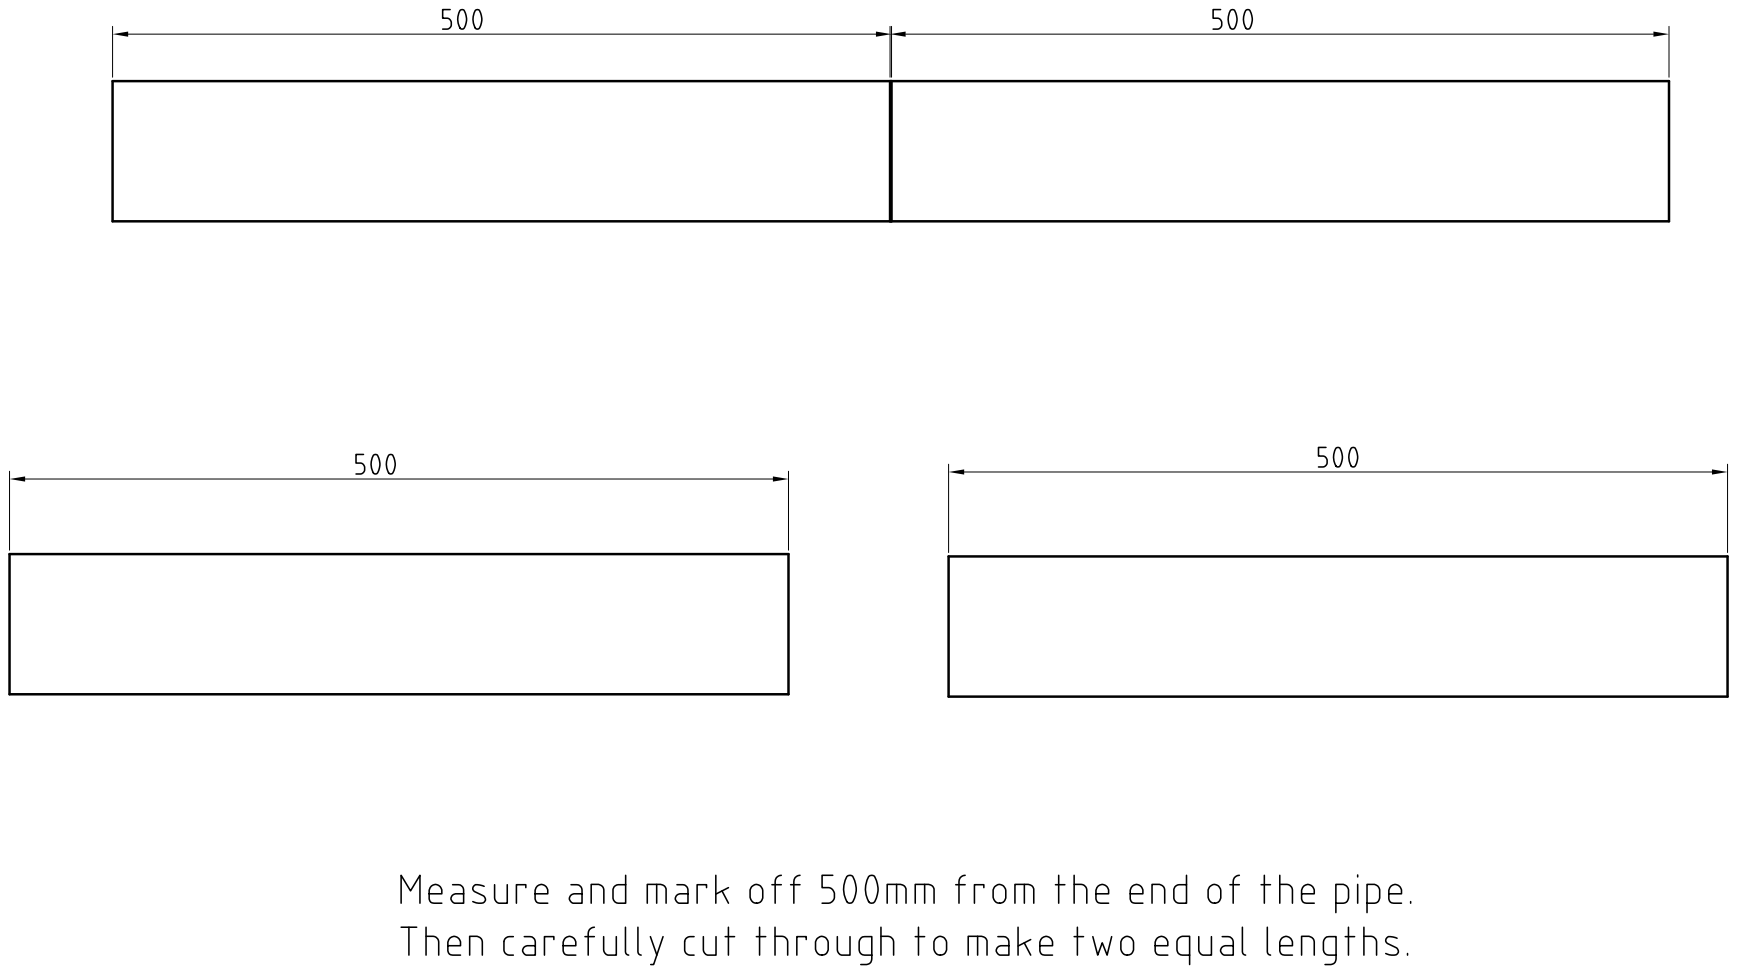
[picture p168: page 39]

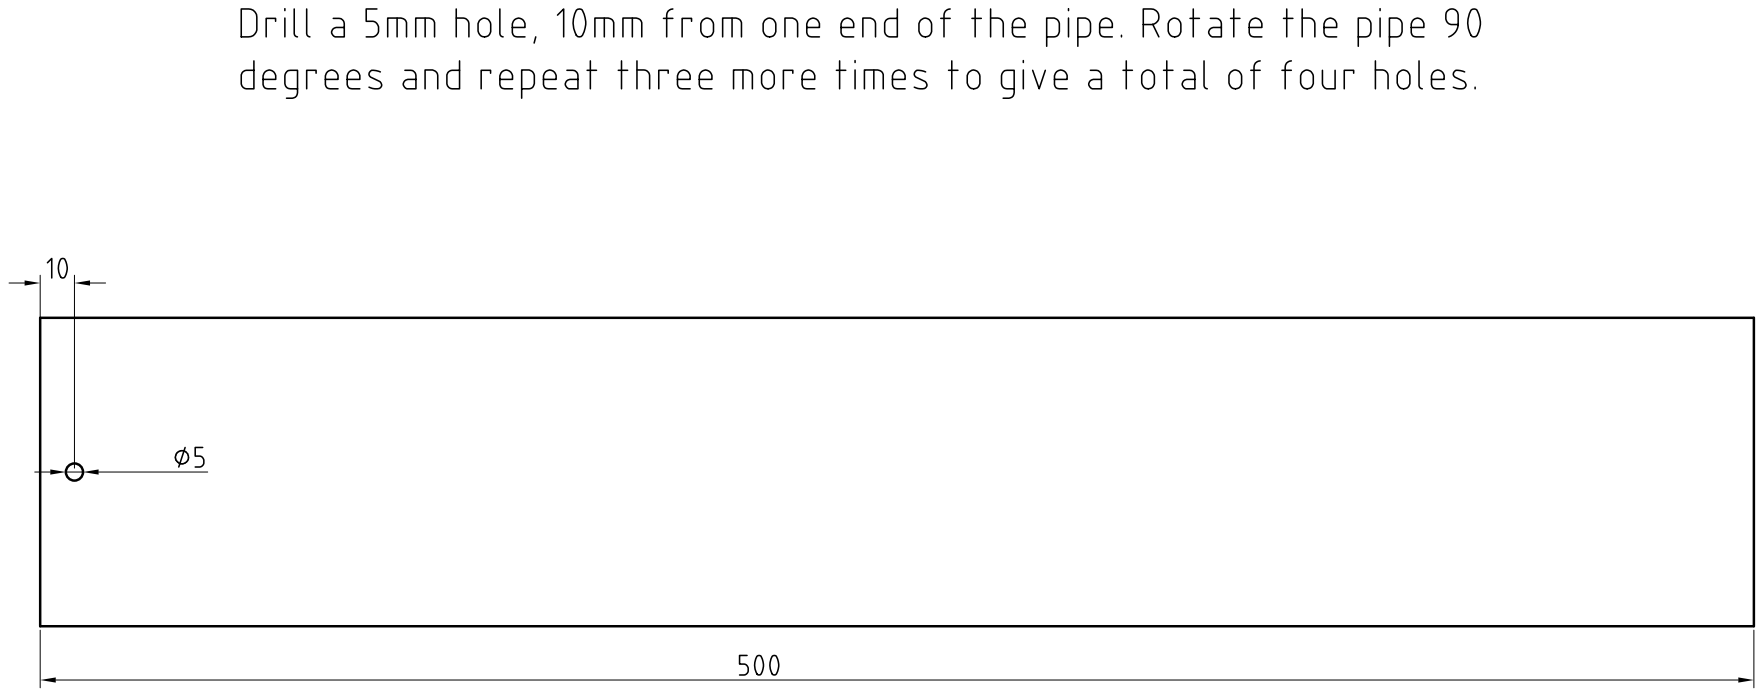
[picture p169: page 40]

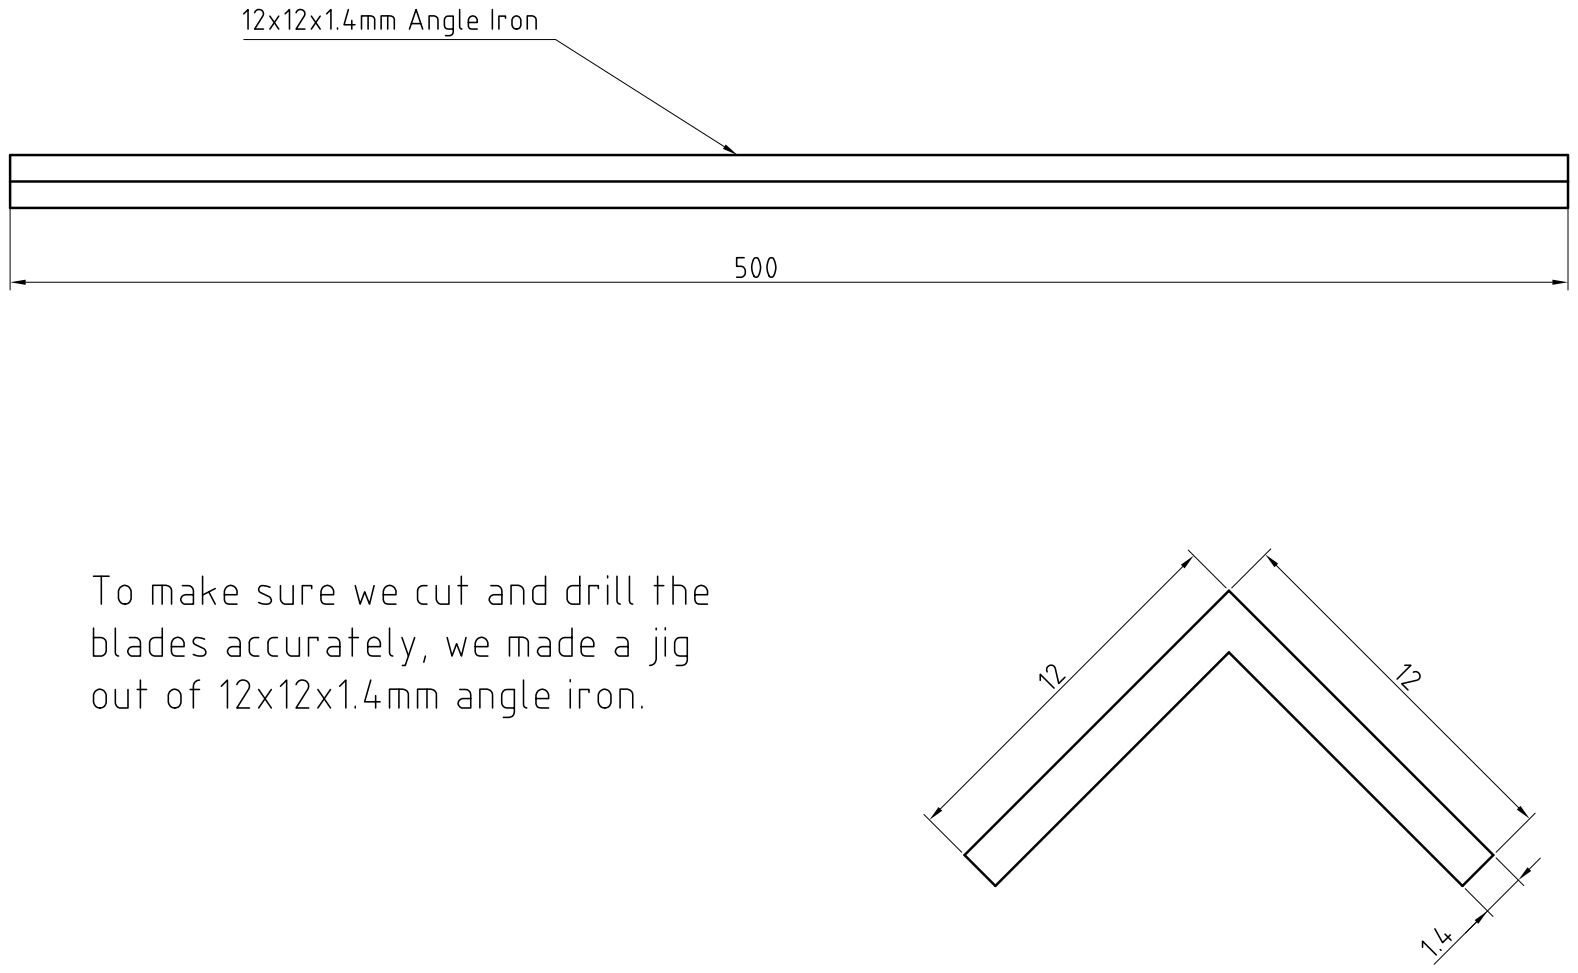
[picture p170: page 41]

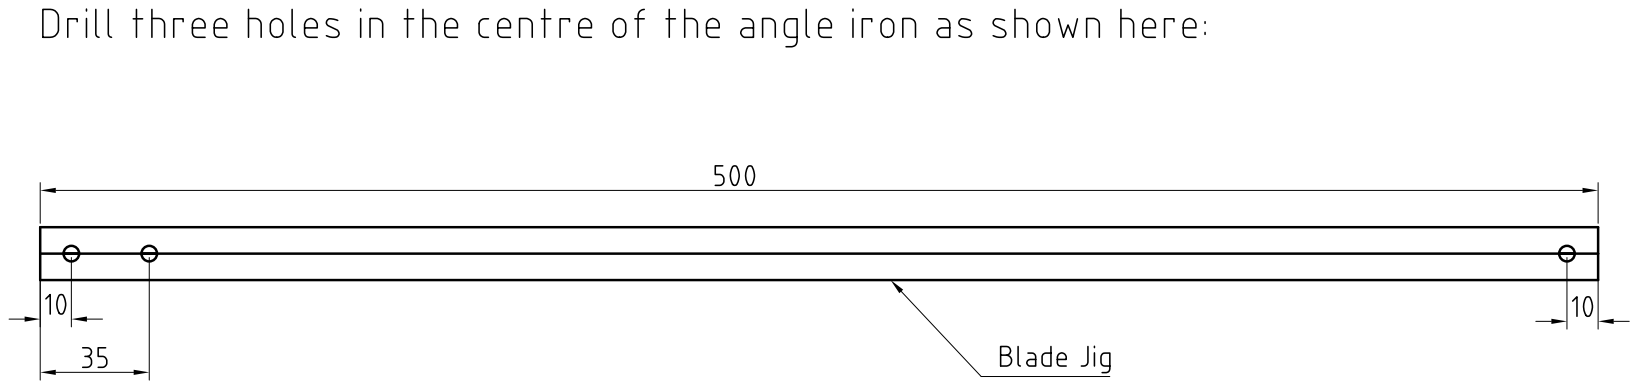
[picture p171: page 42]

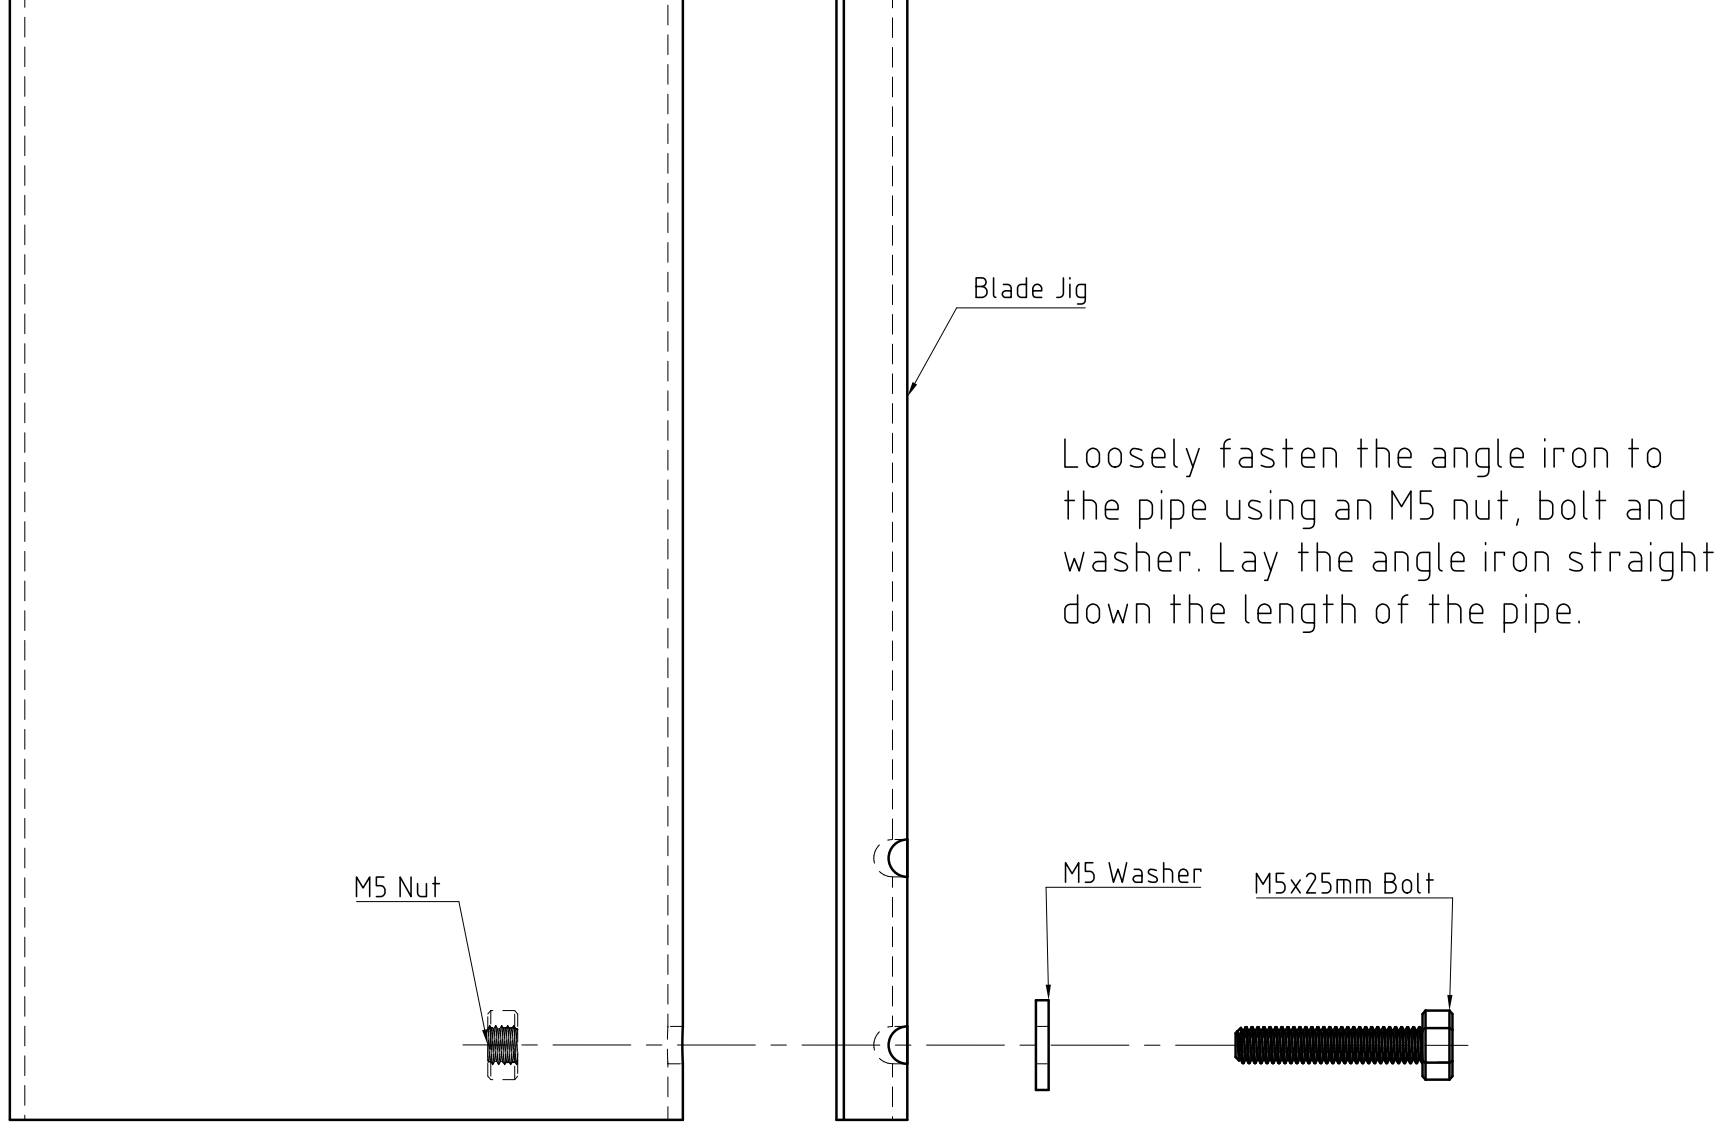
[picture p172: page 43]

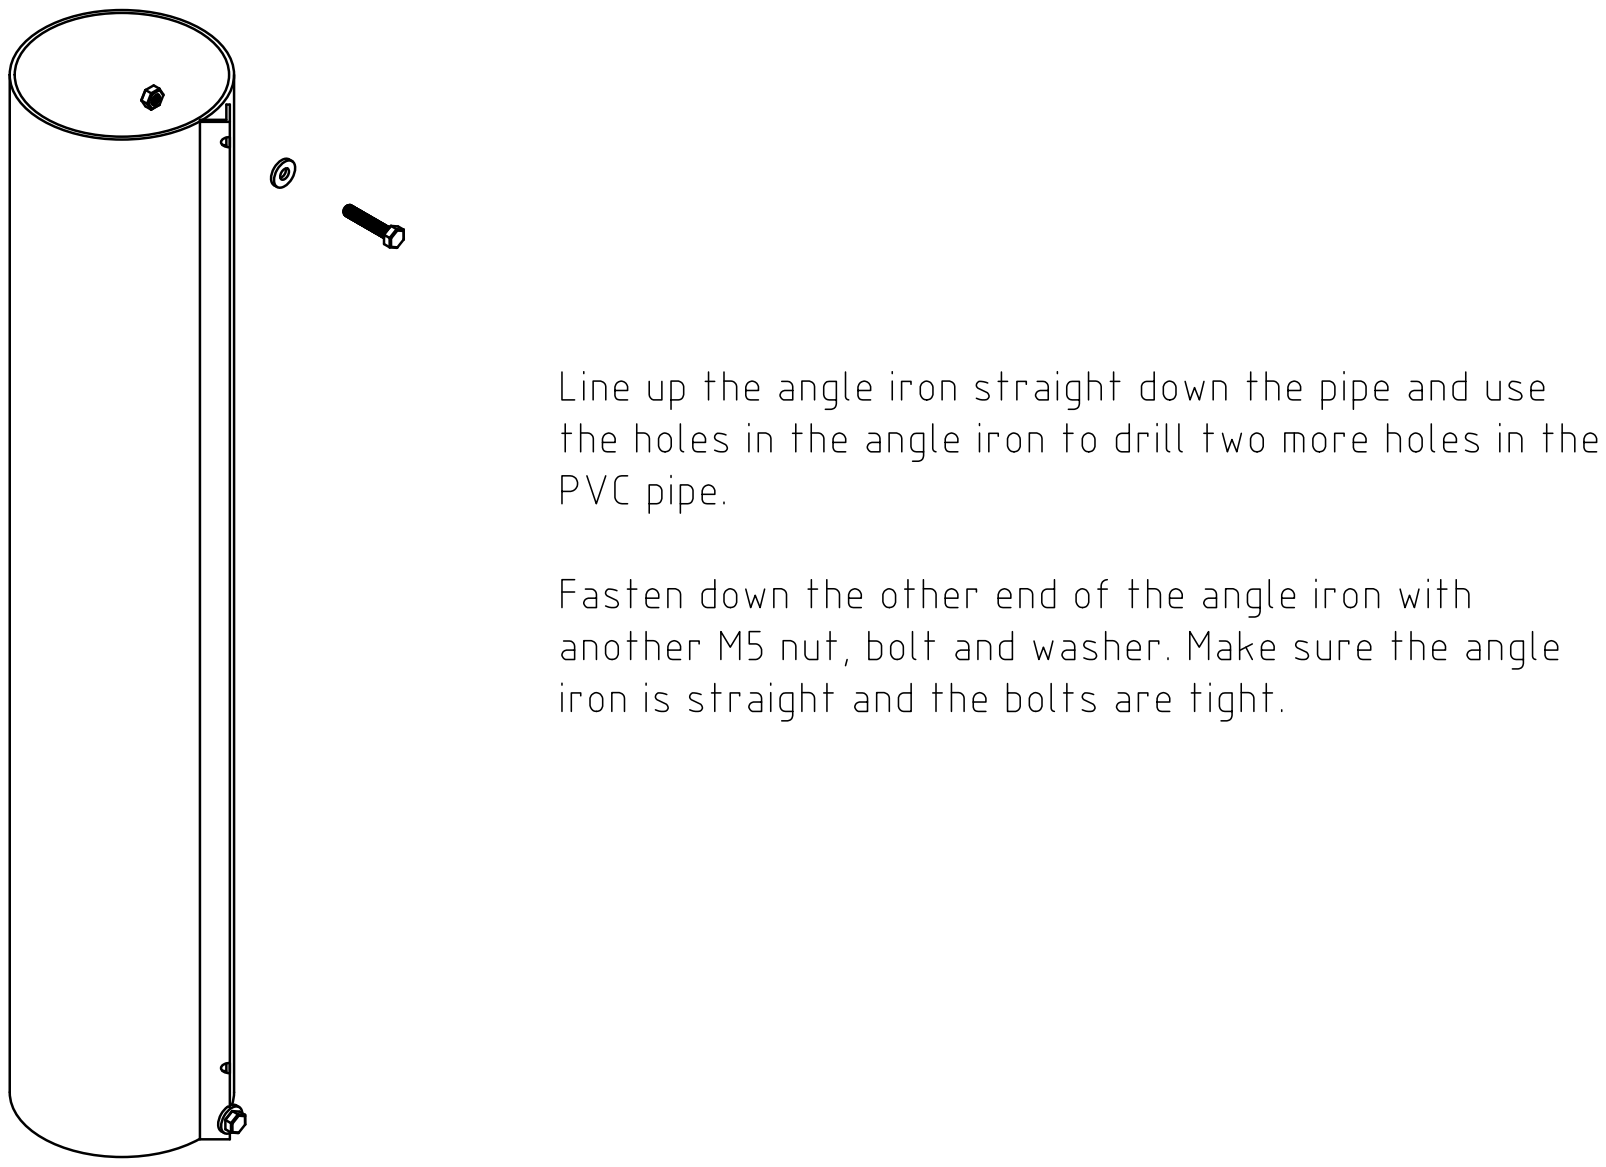
[picture p173: page 44]

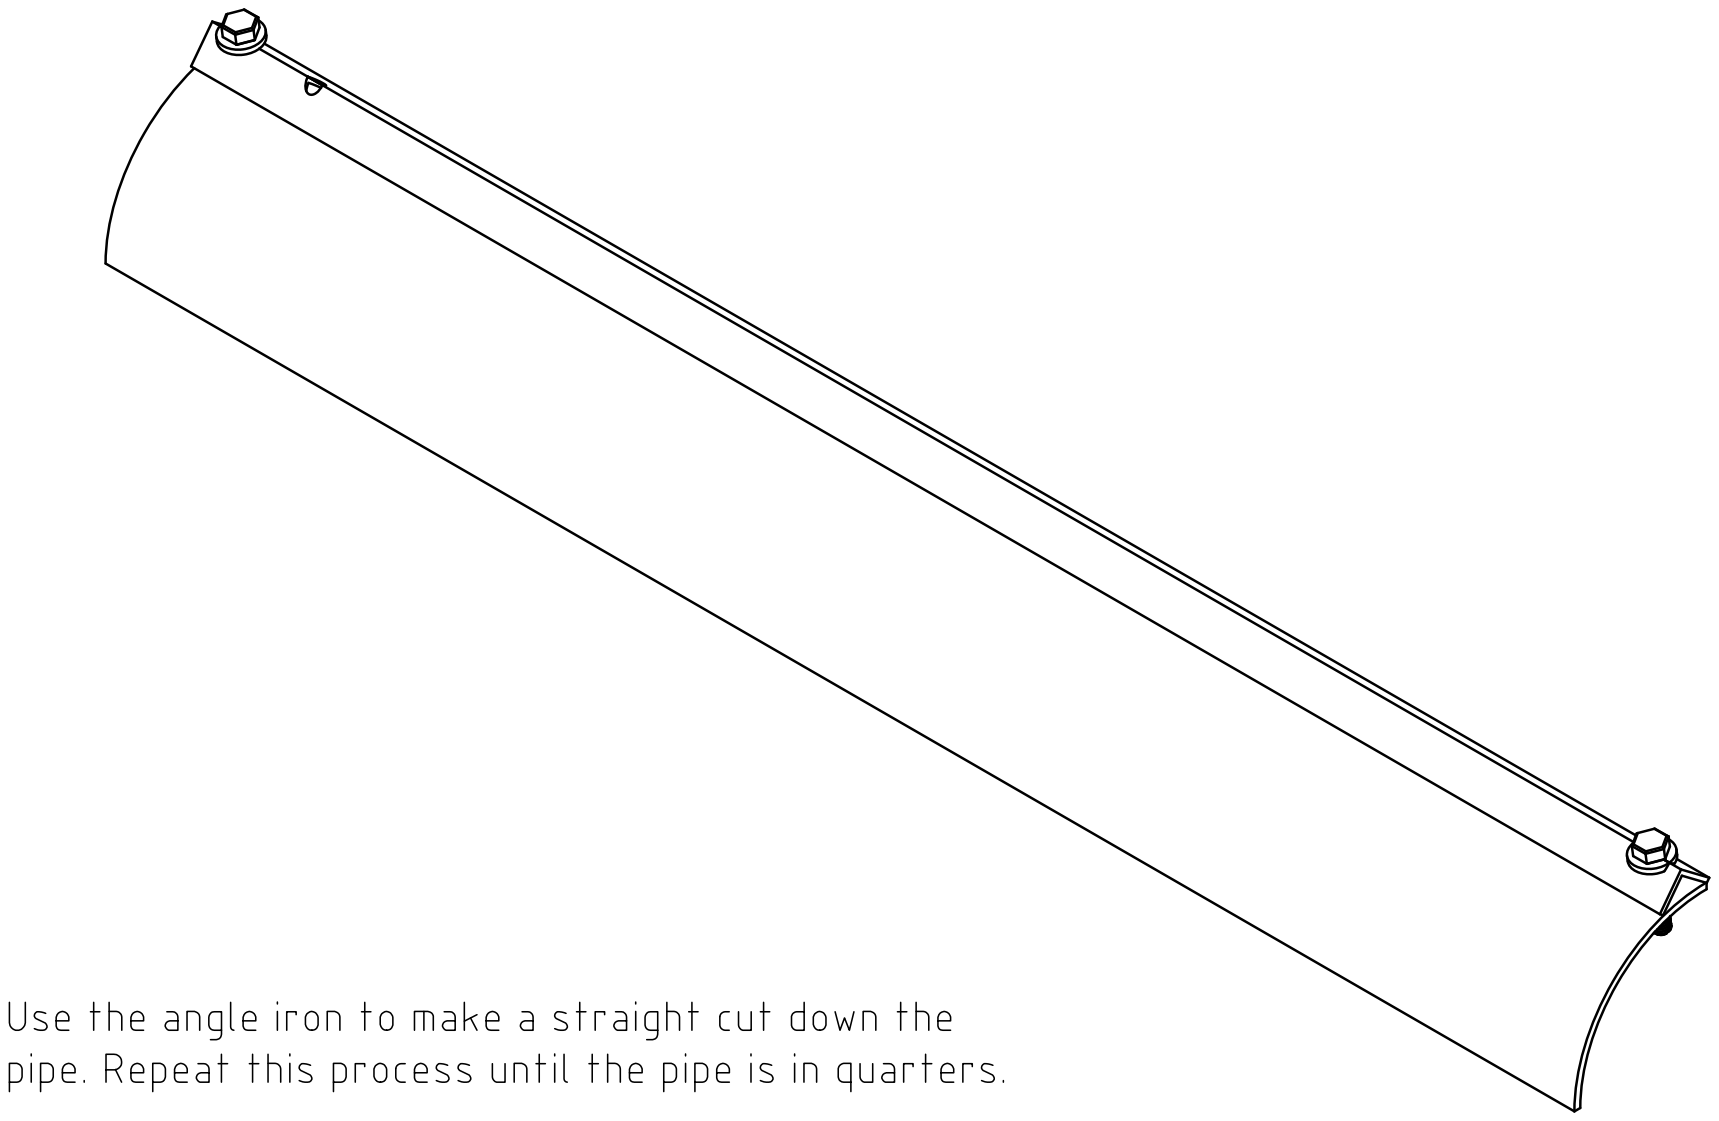
[picture p174: page 45]

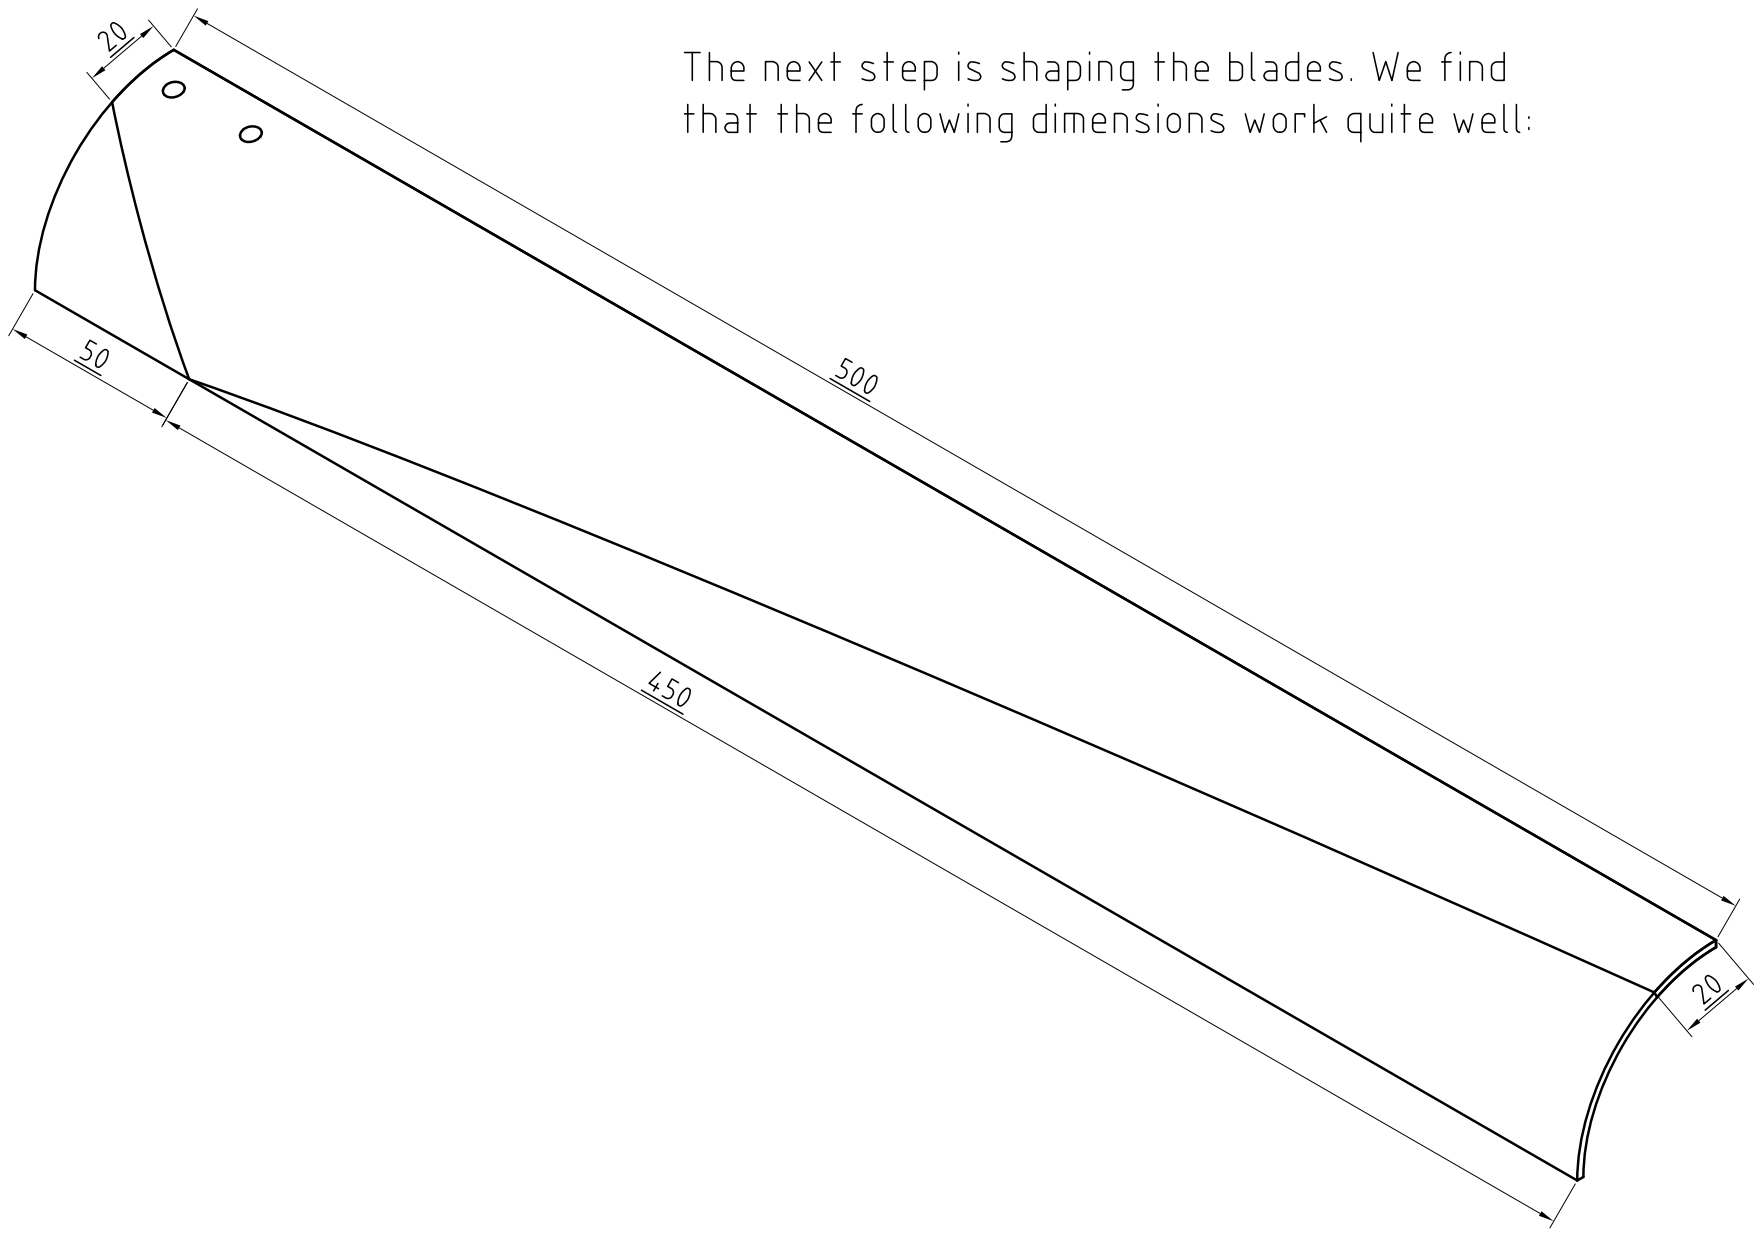
[picture p175: page 46]

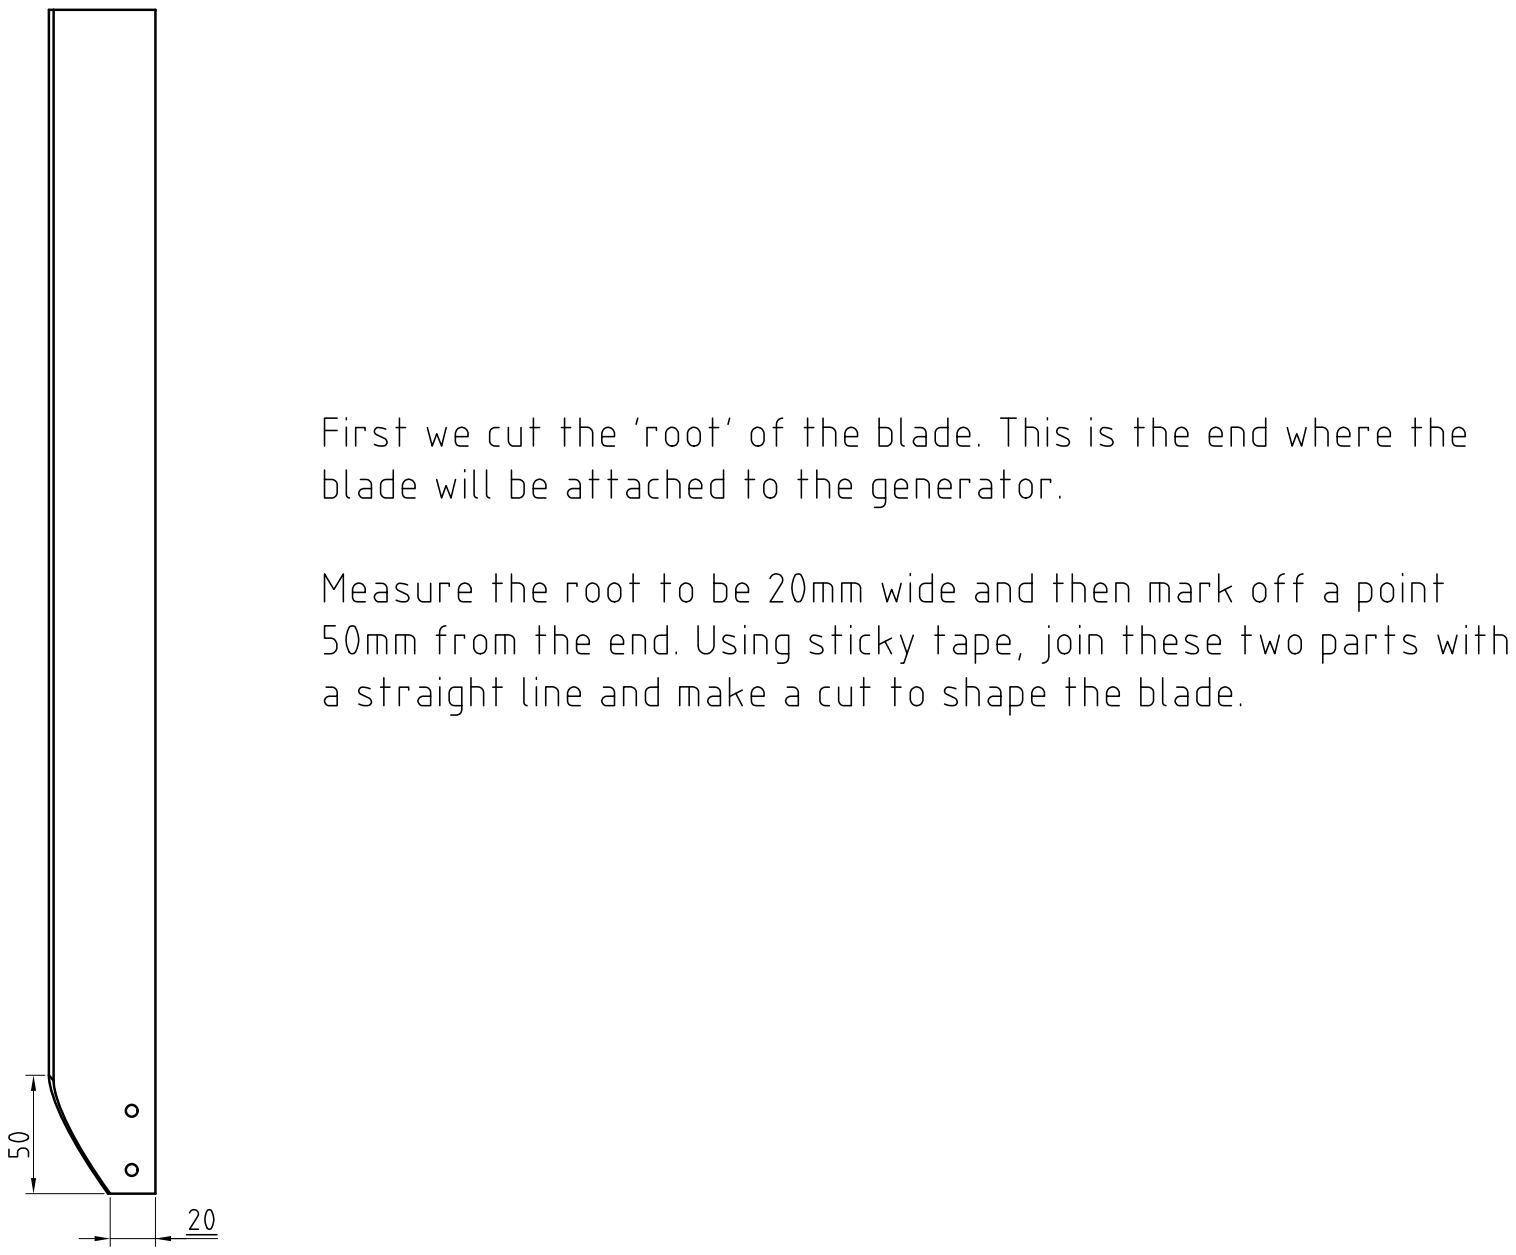
[picture p176: page 47]

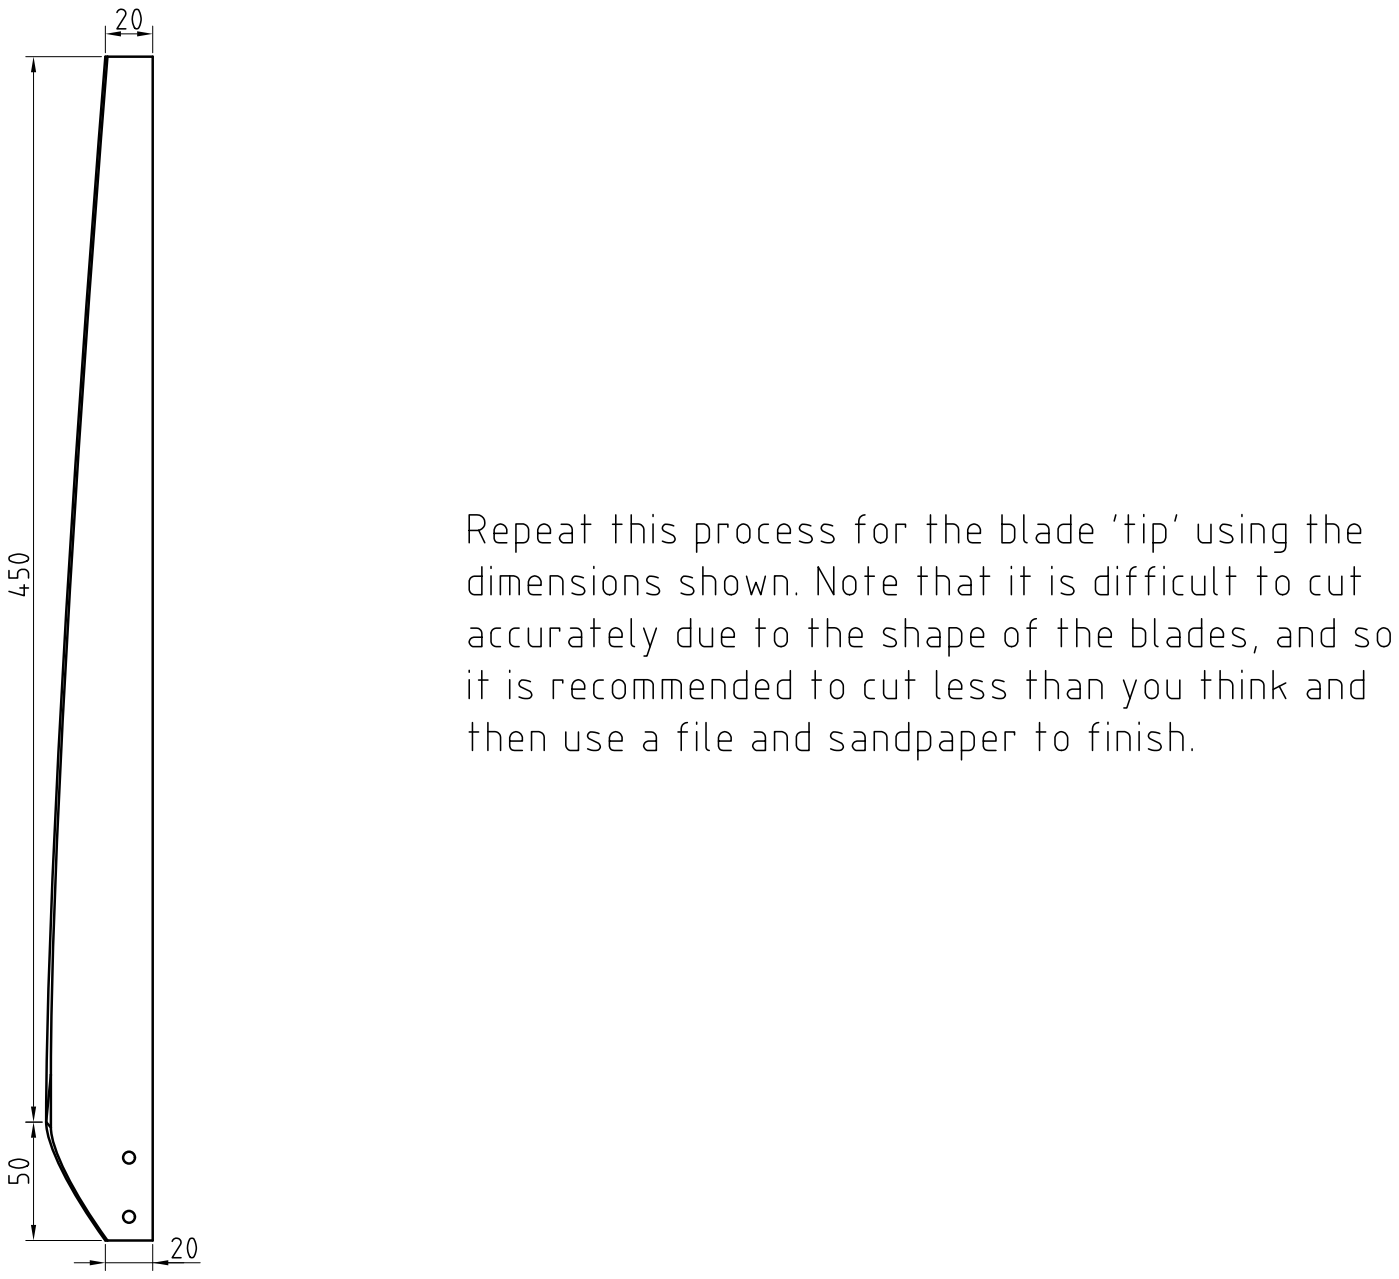
[picture p177: page 48]

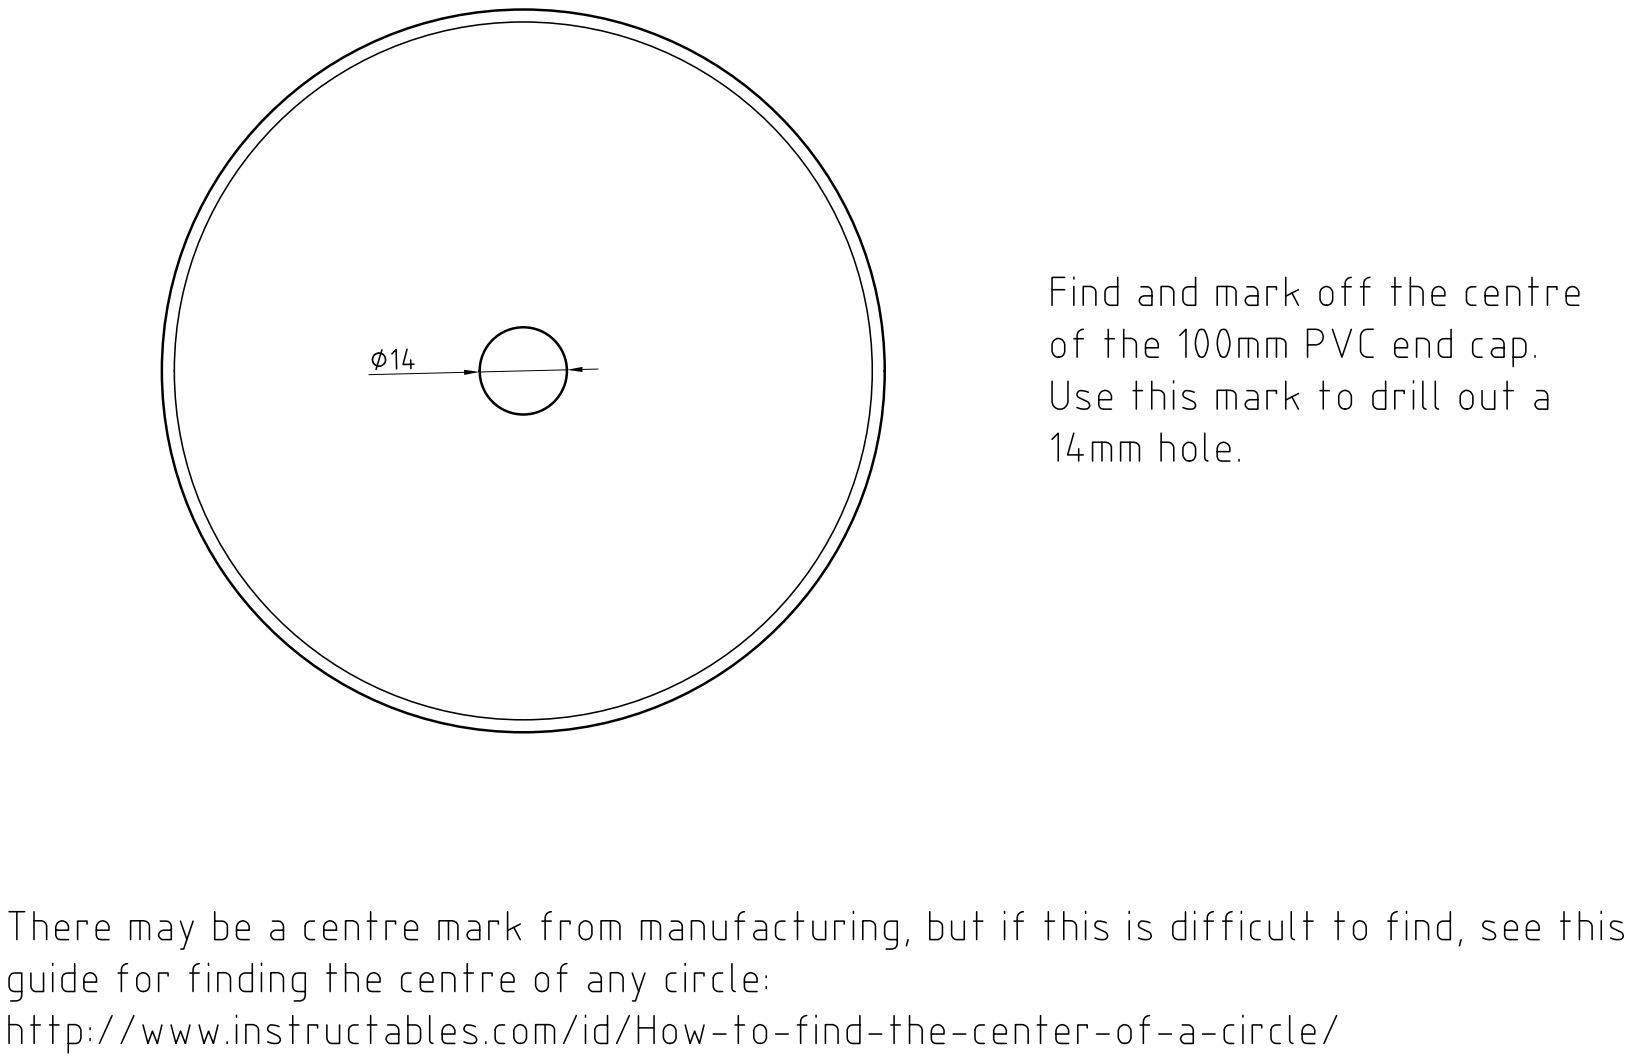
[picture p178: page 49]

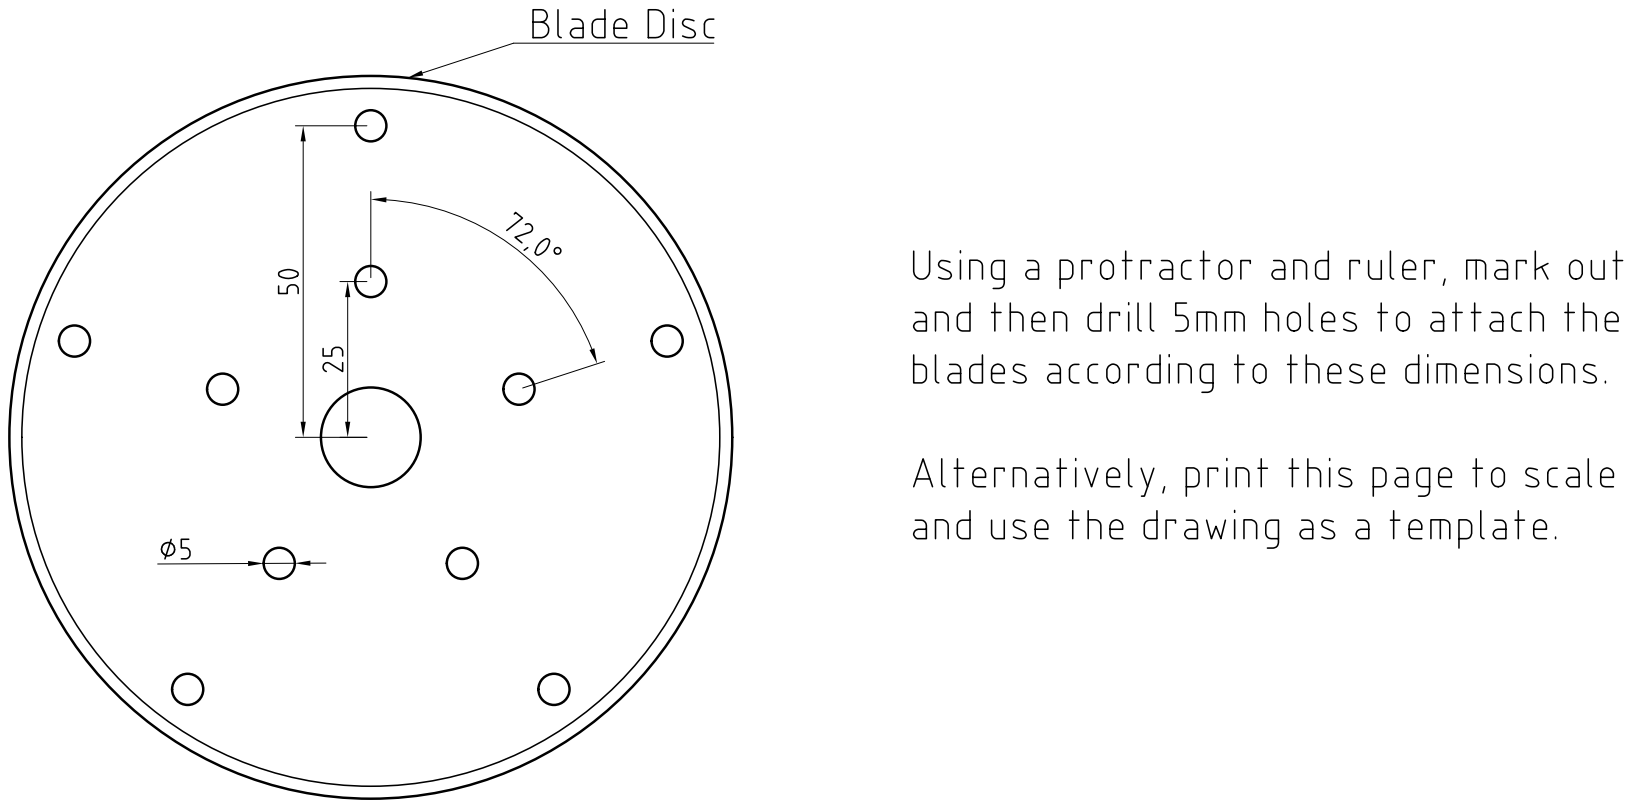
[picture p179: page 50]

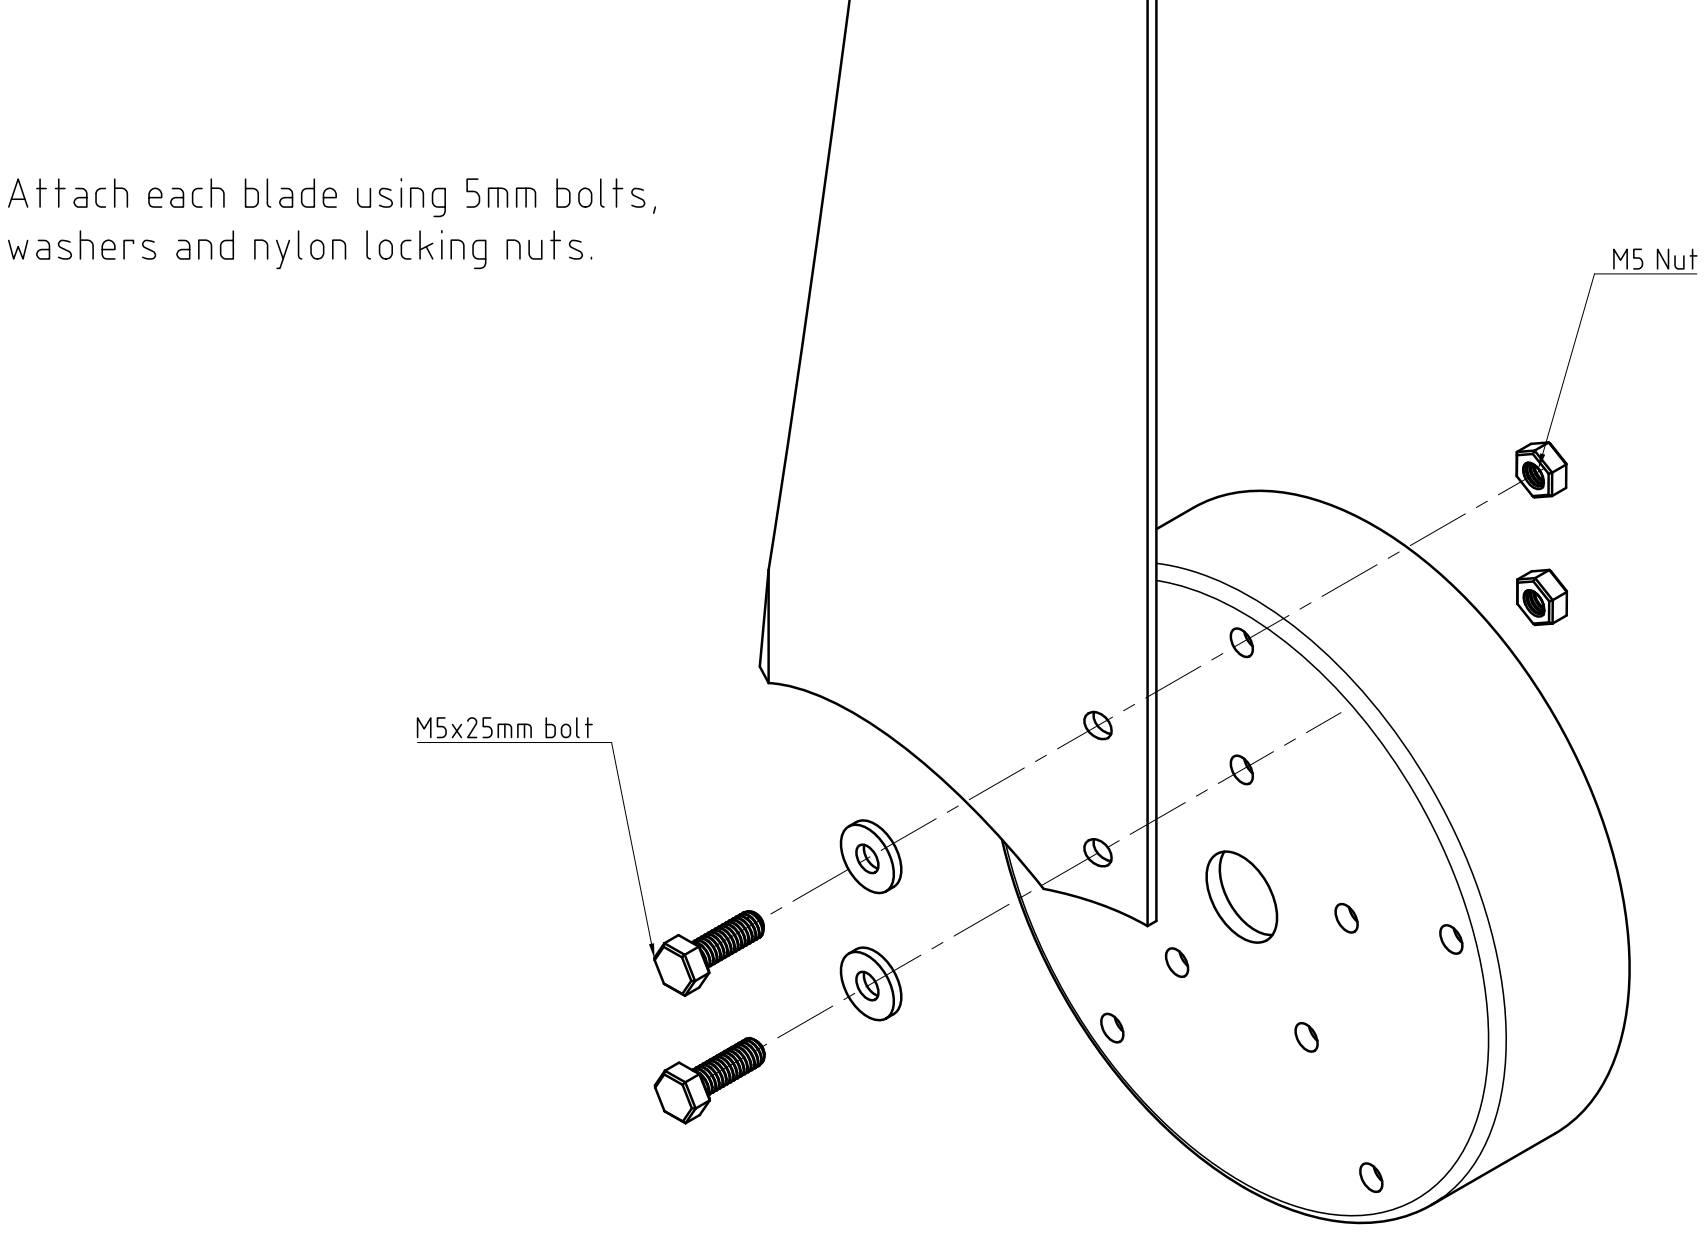
[picture p180: page 51]

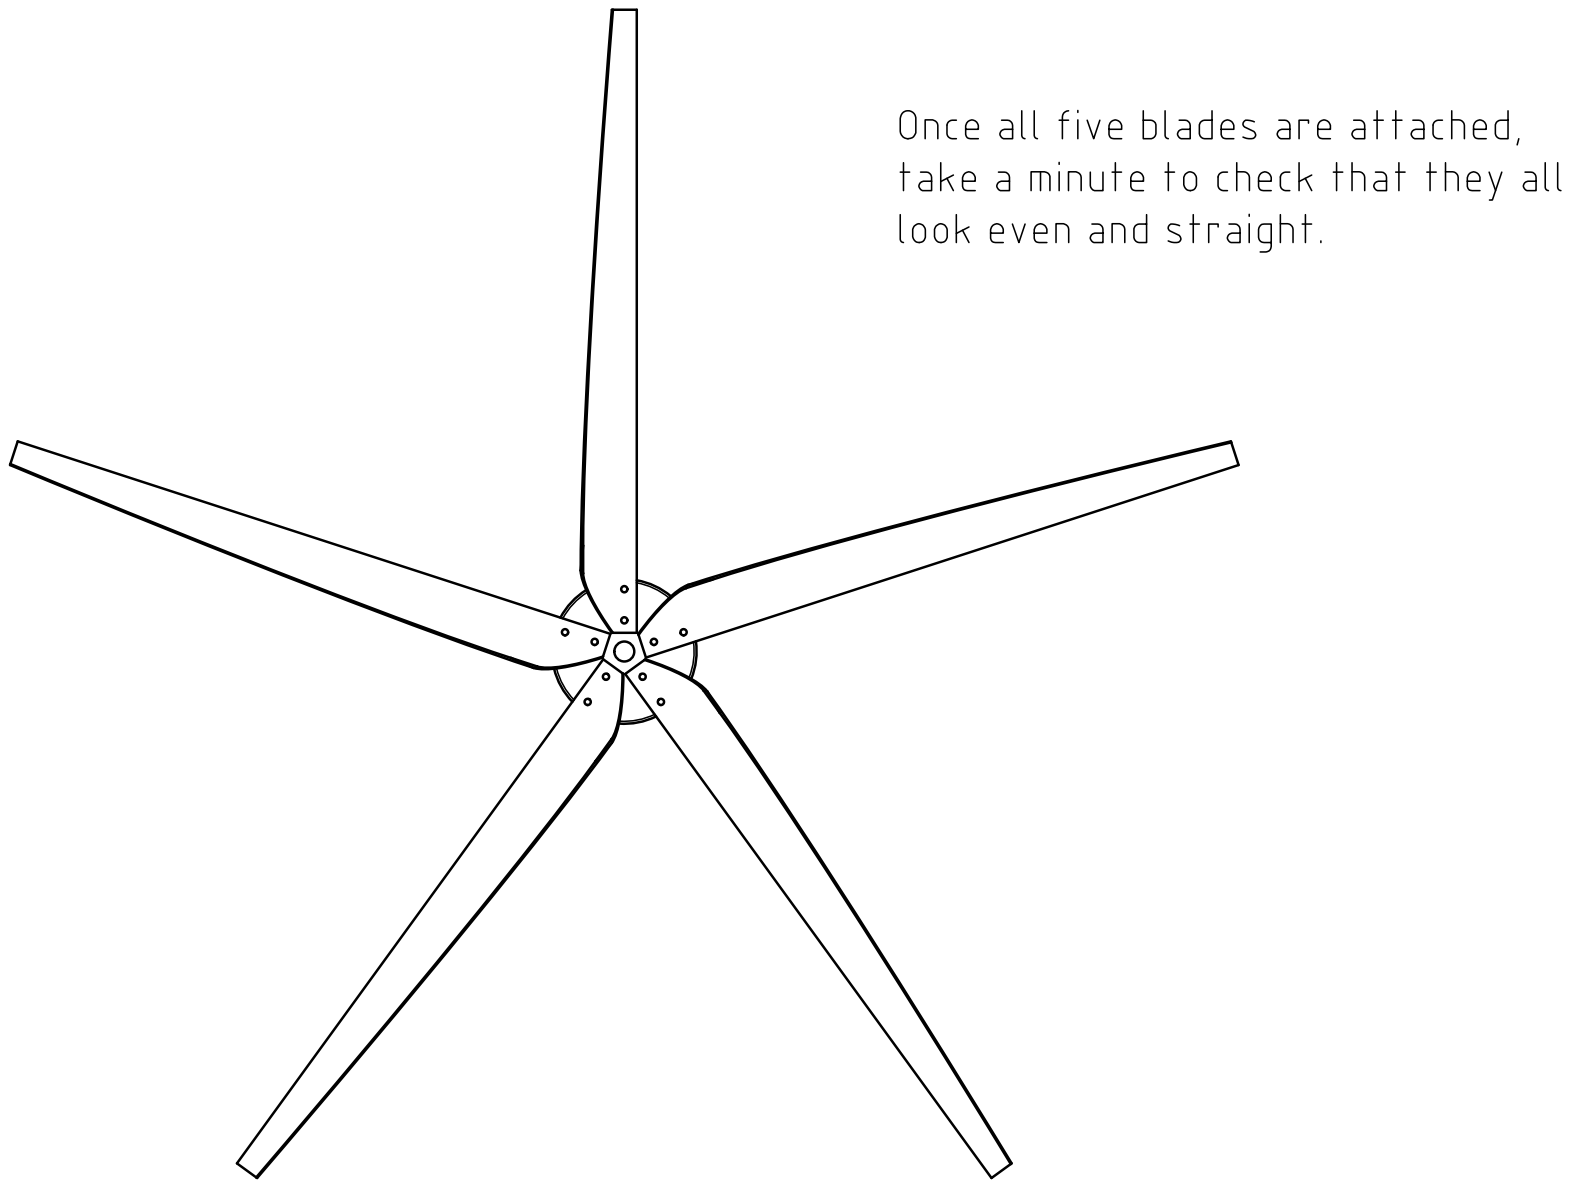
[picture p181: page 52]

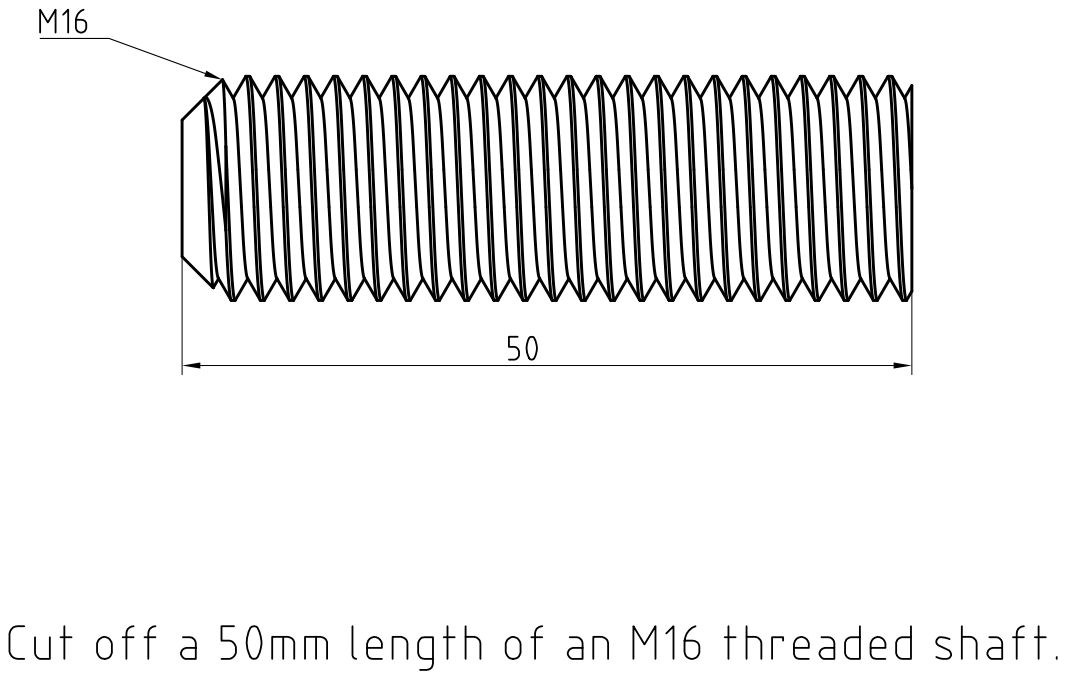
[picture p182: page 53]

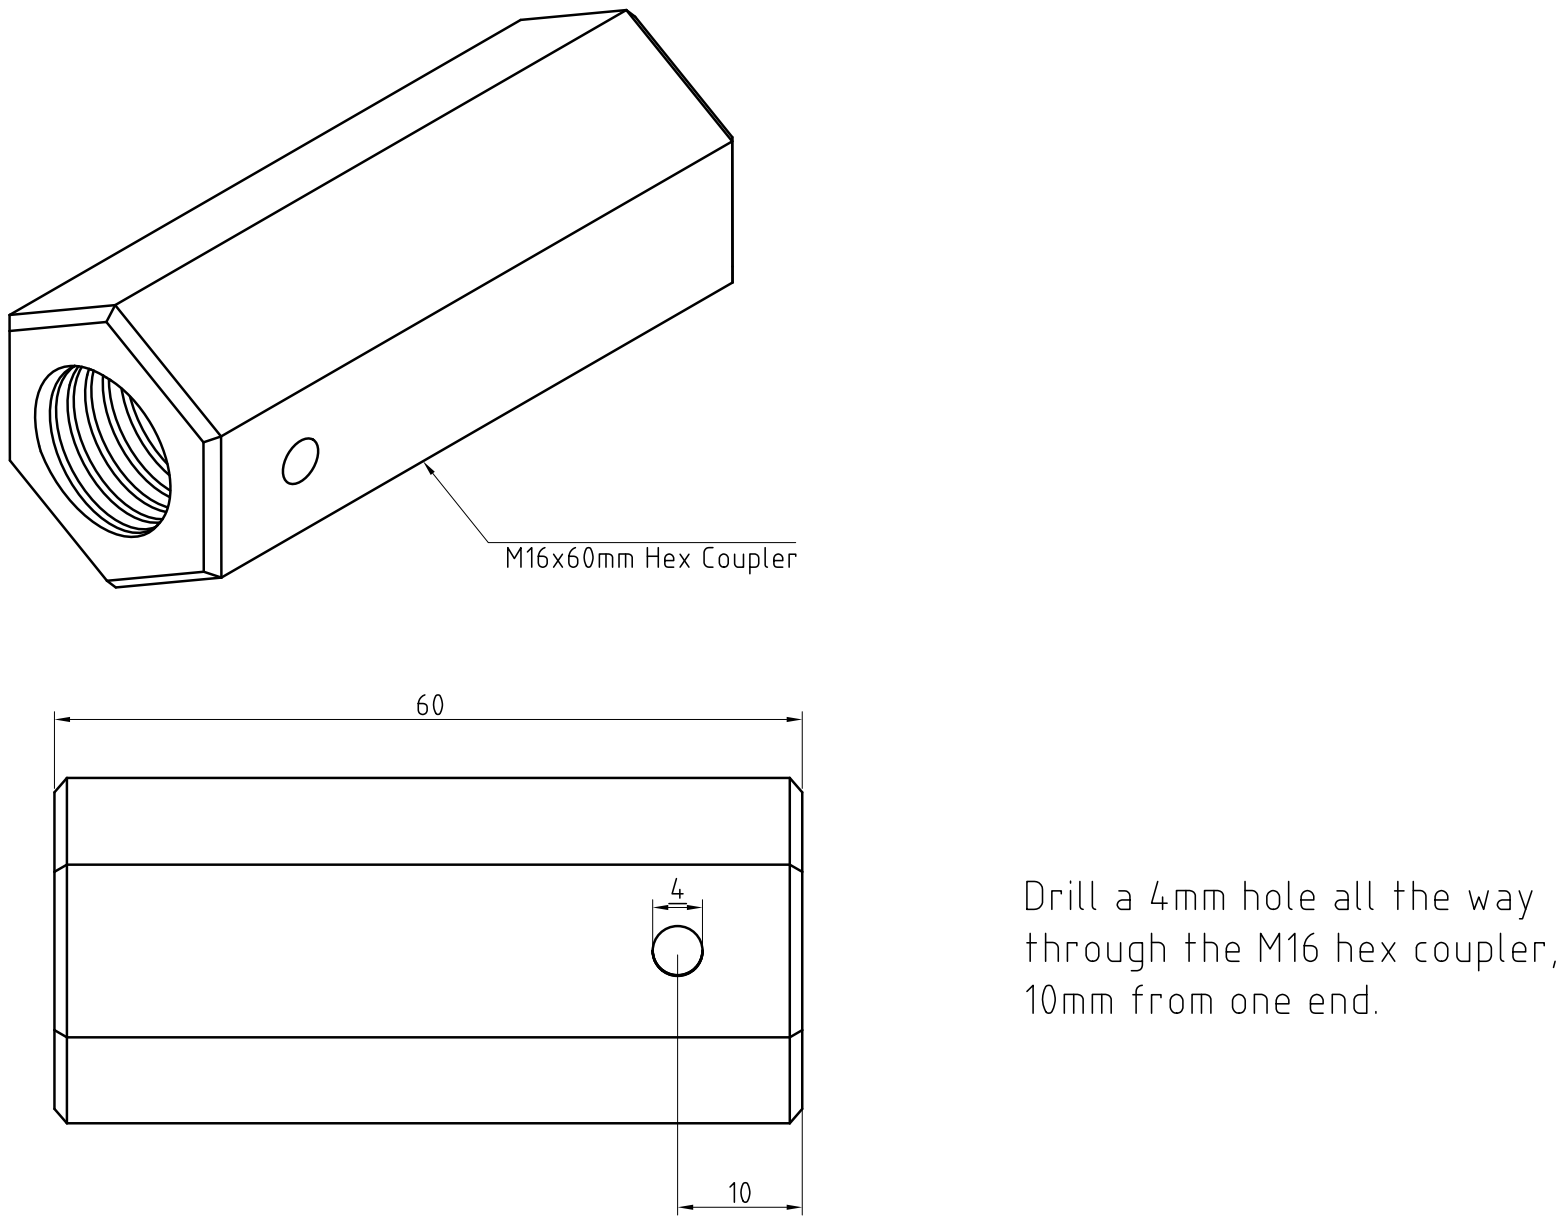
[picture p183: page 54]

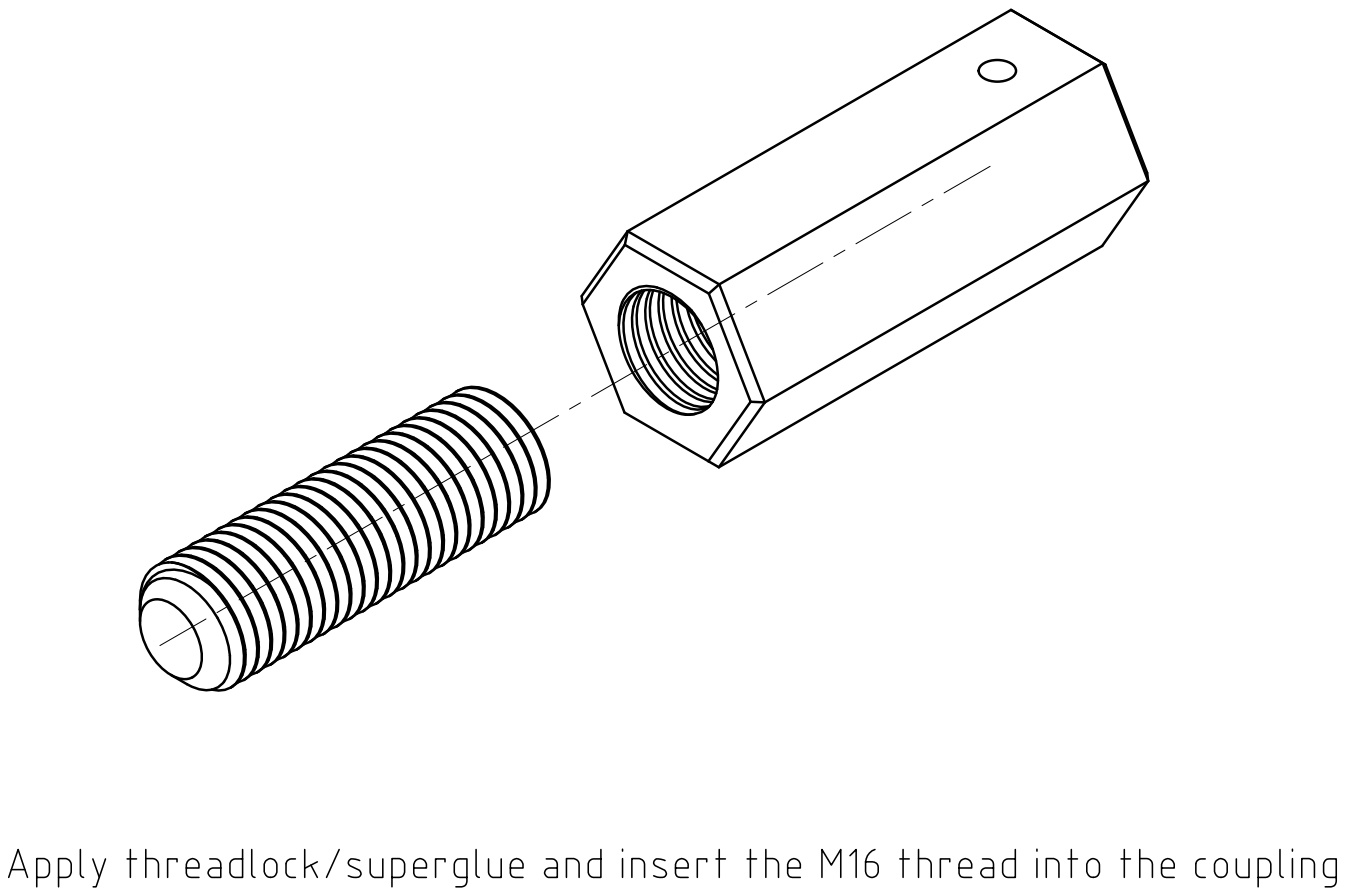
[picture p184: page 55]

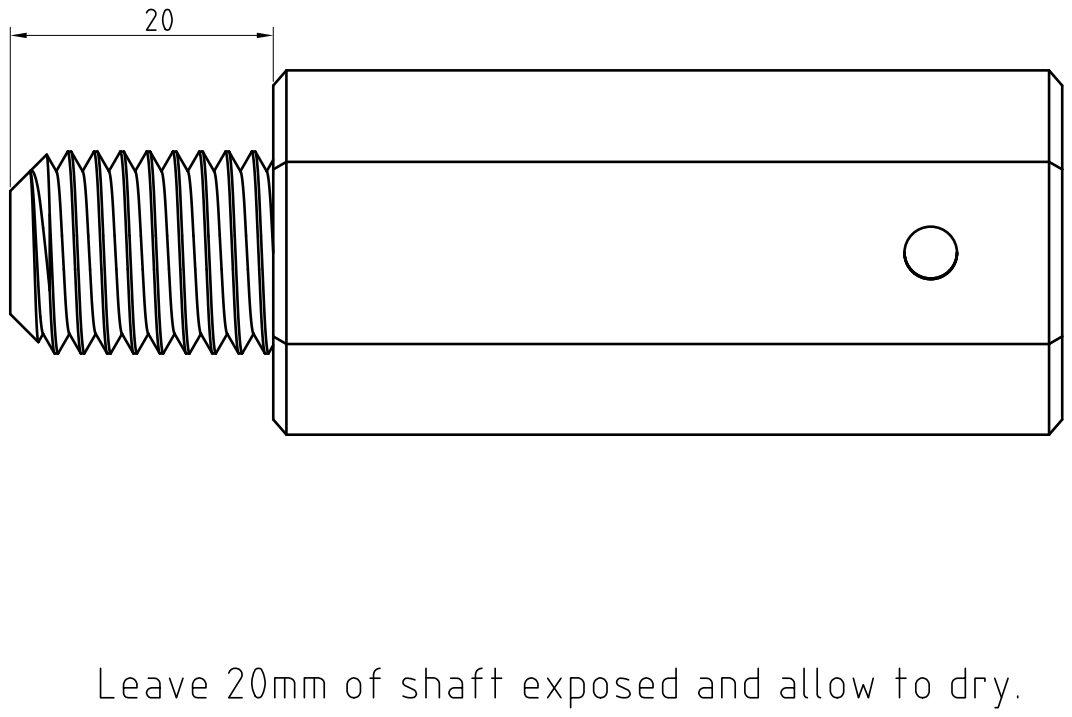
[picture p185: page 56]

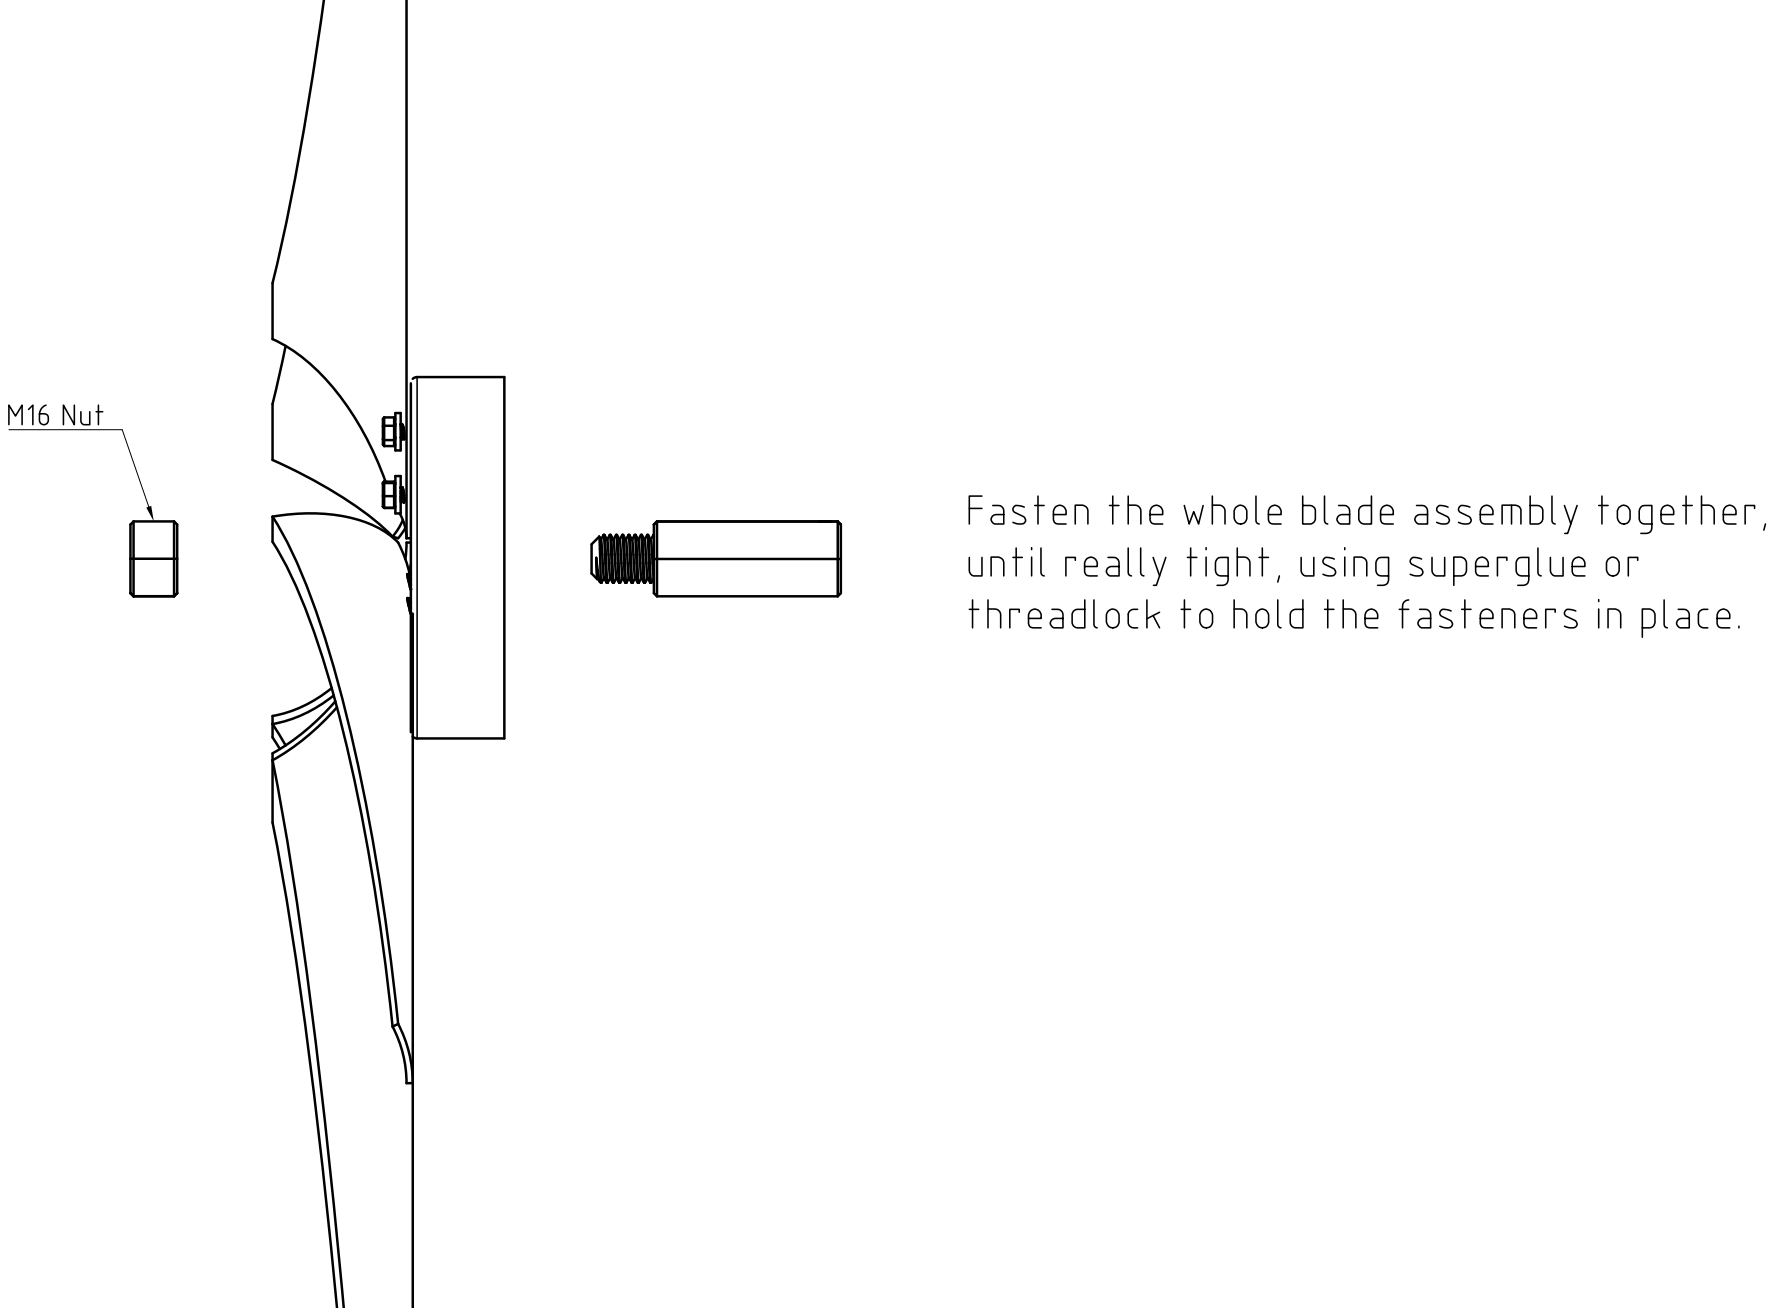
[picture p186: page 57]

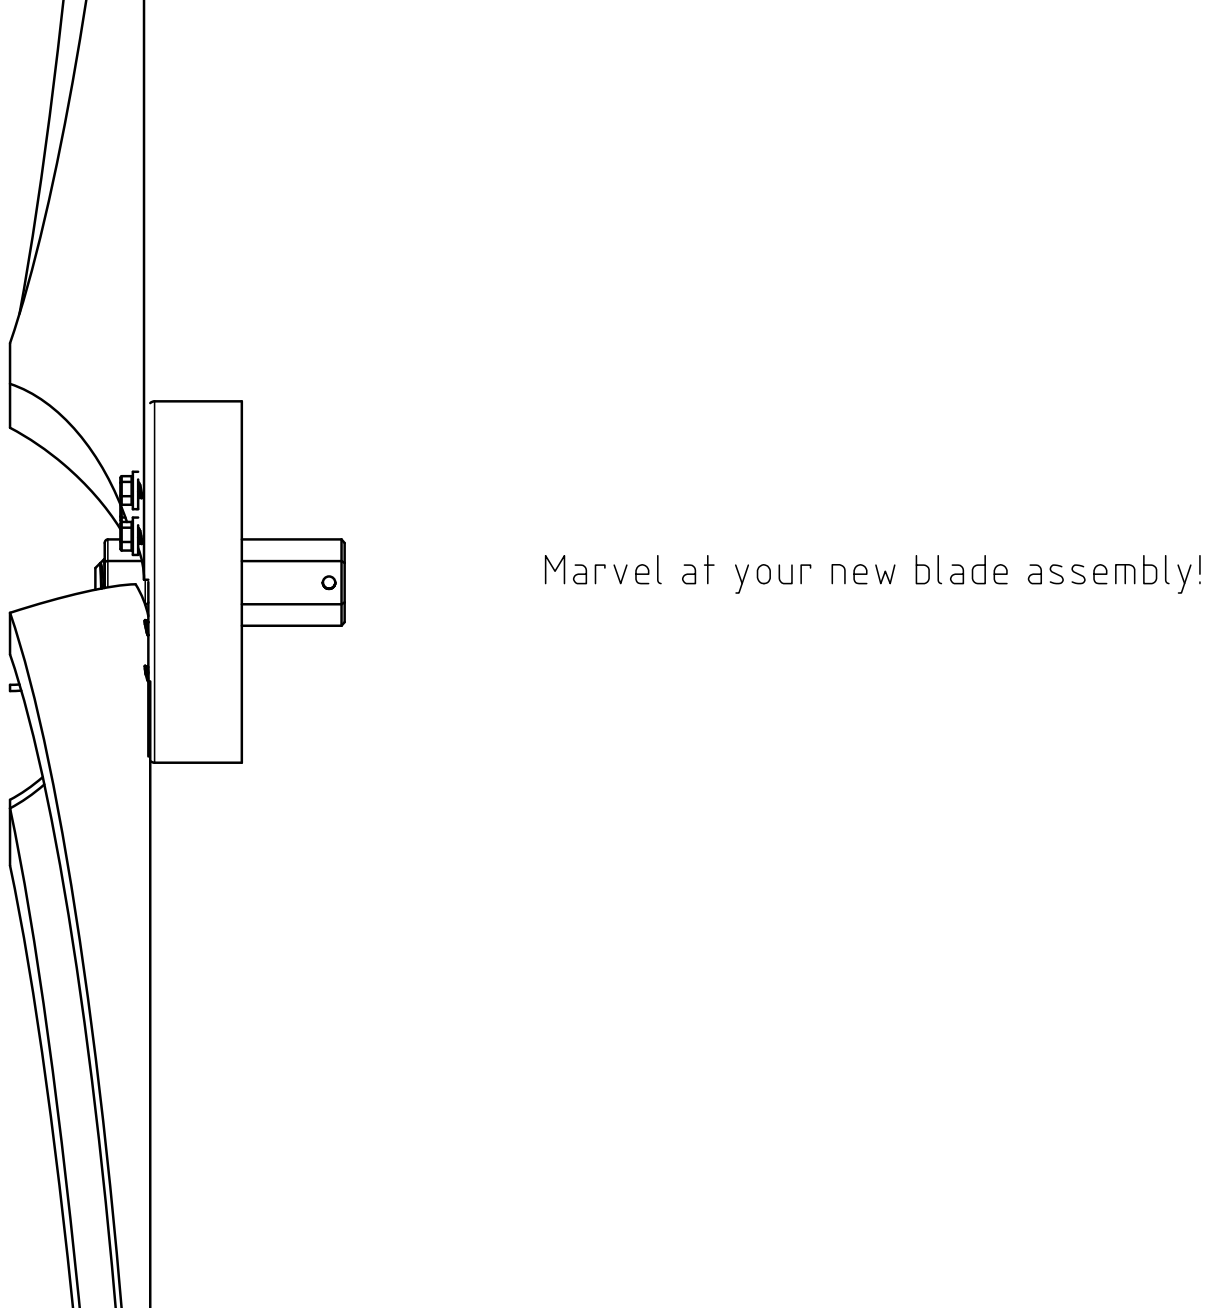
[picture p187: page 58]

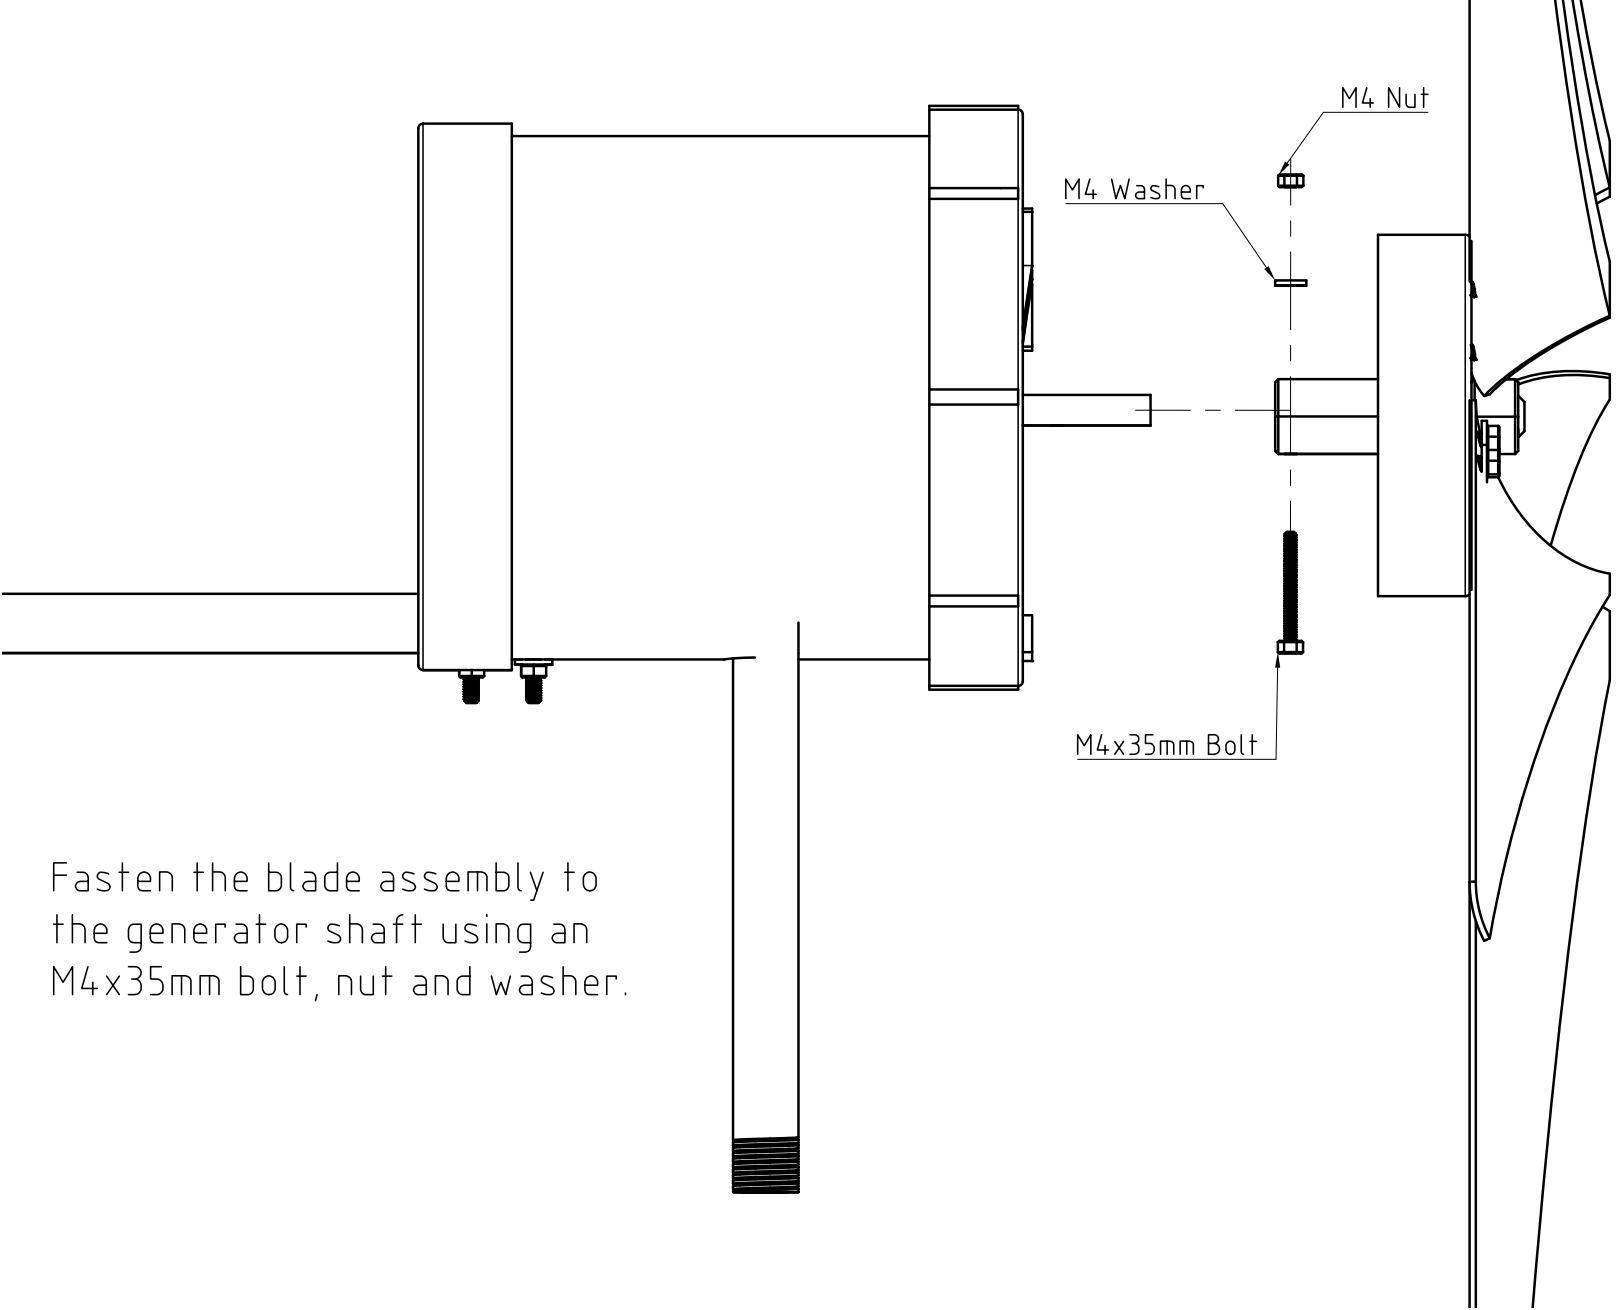
[picture p188: page 59]

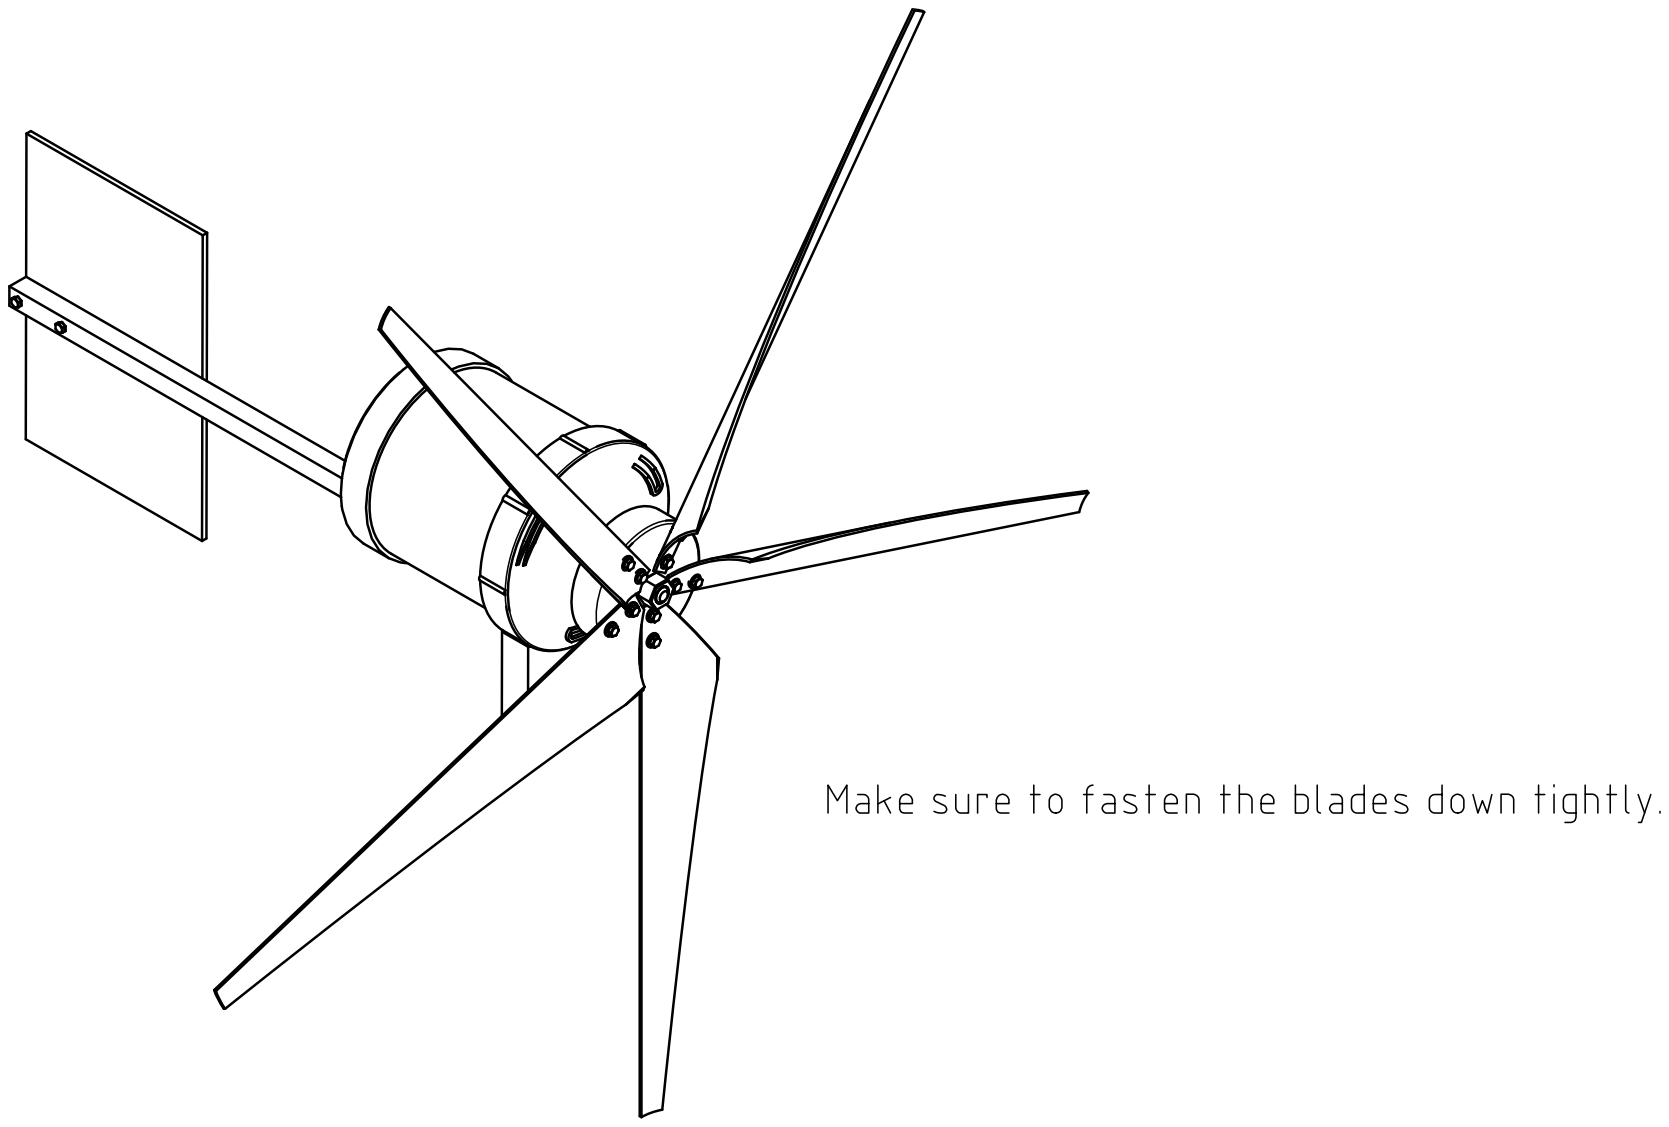
[picture p189: page 60]

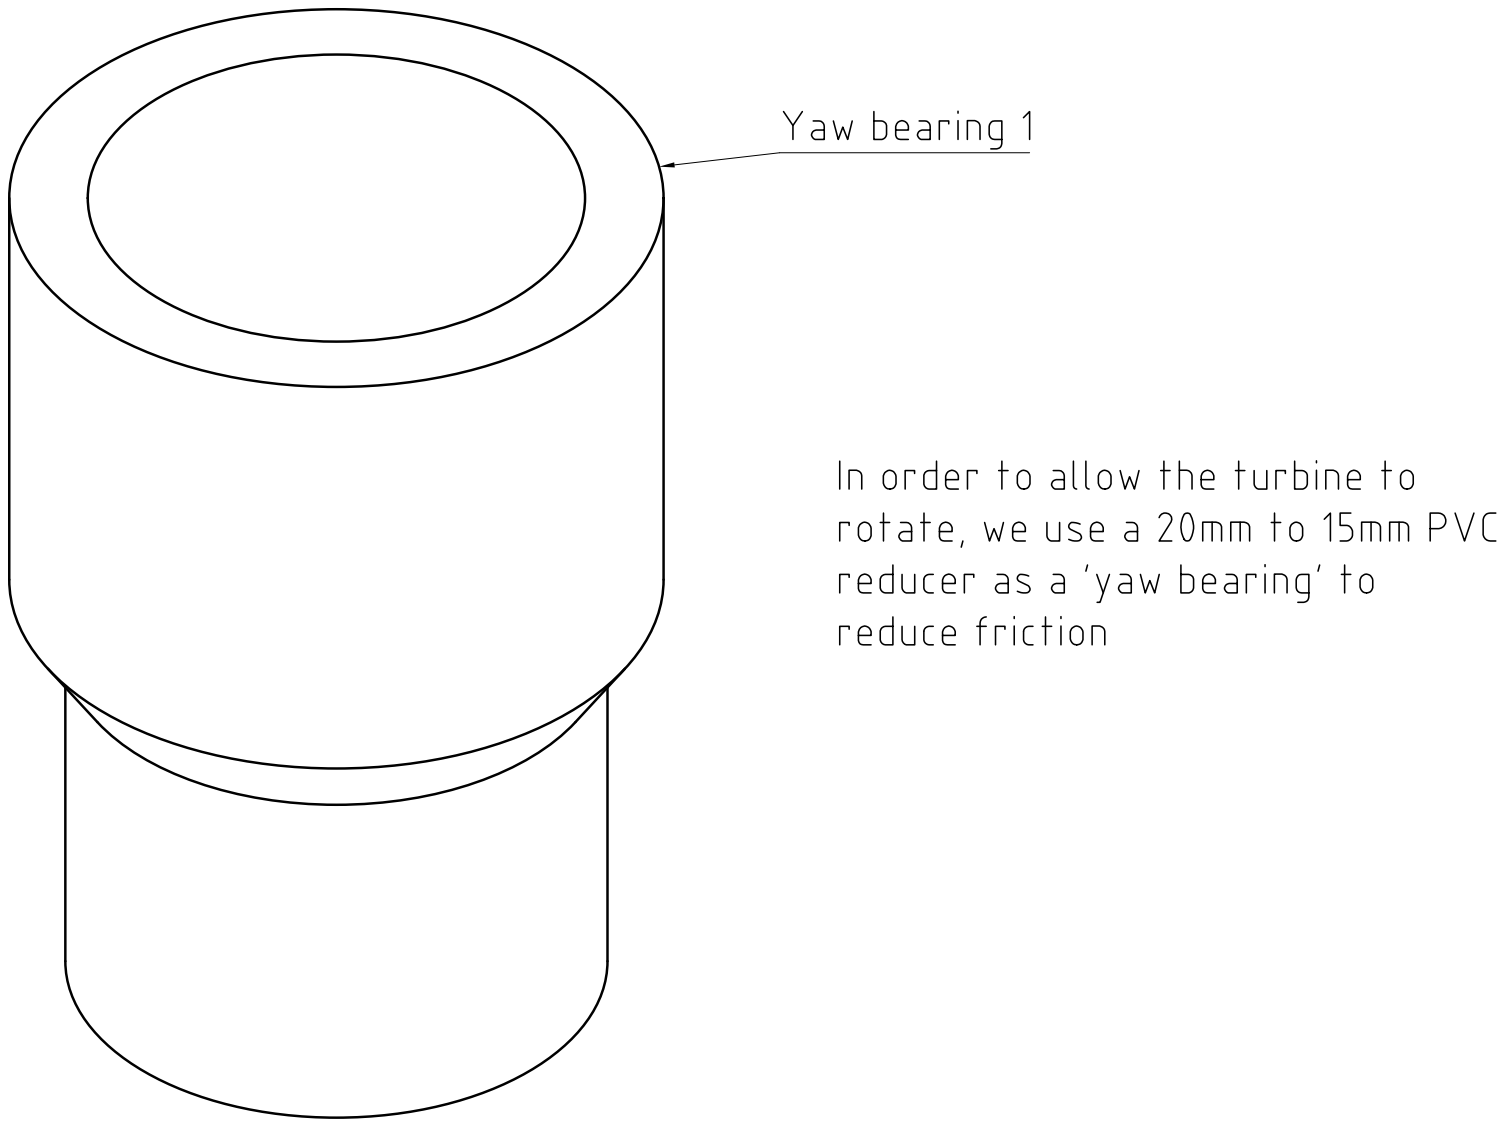
[picture p190: page 61]

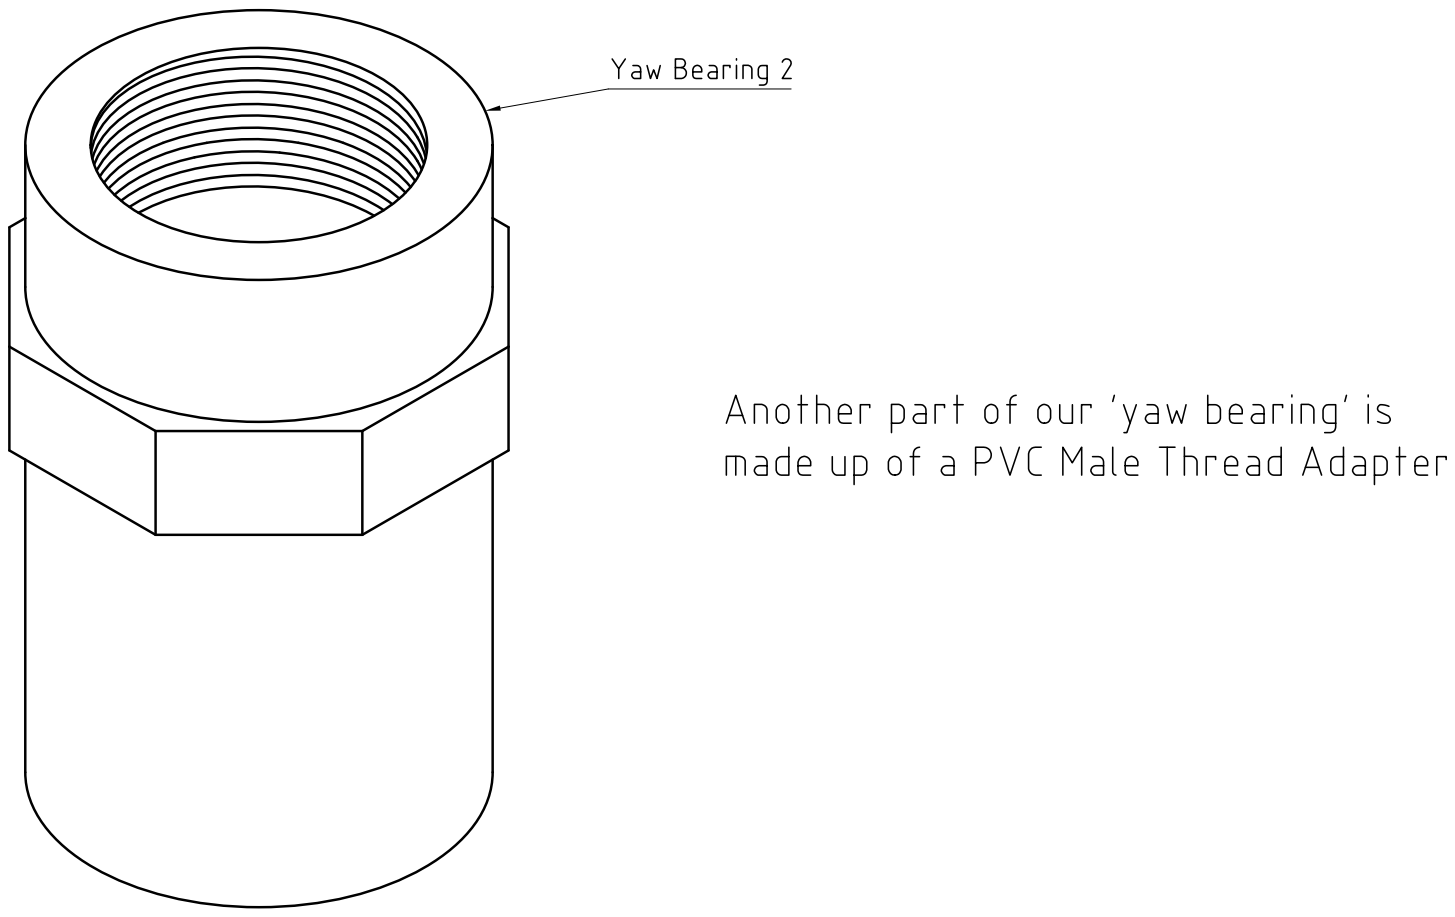
[picture p191: page 62]

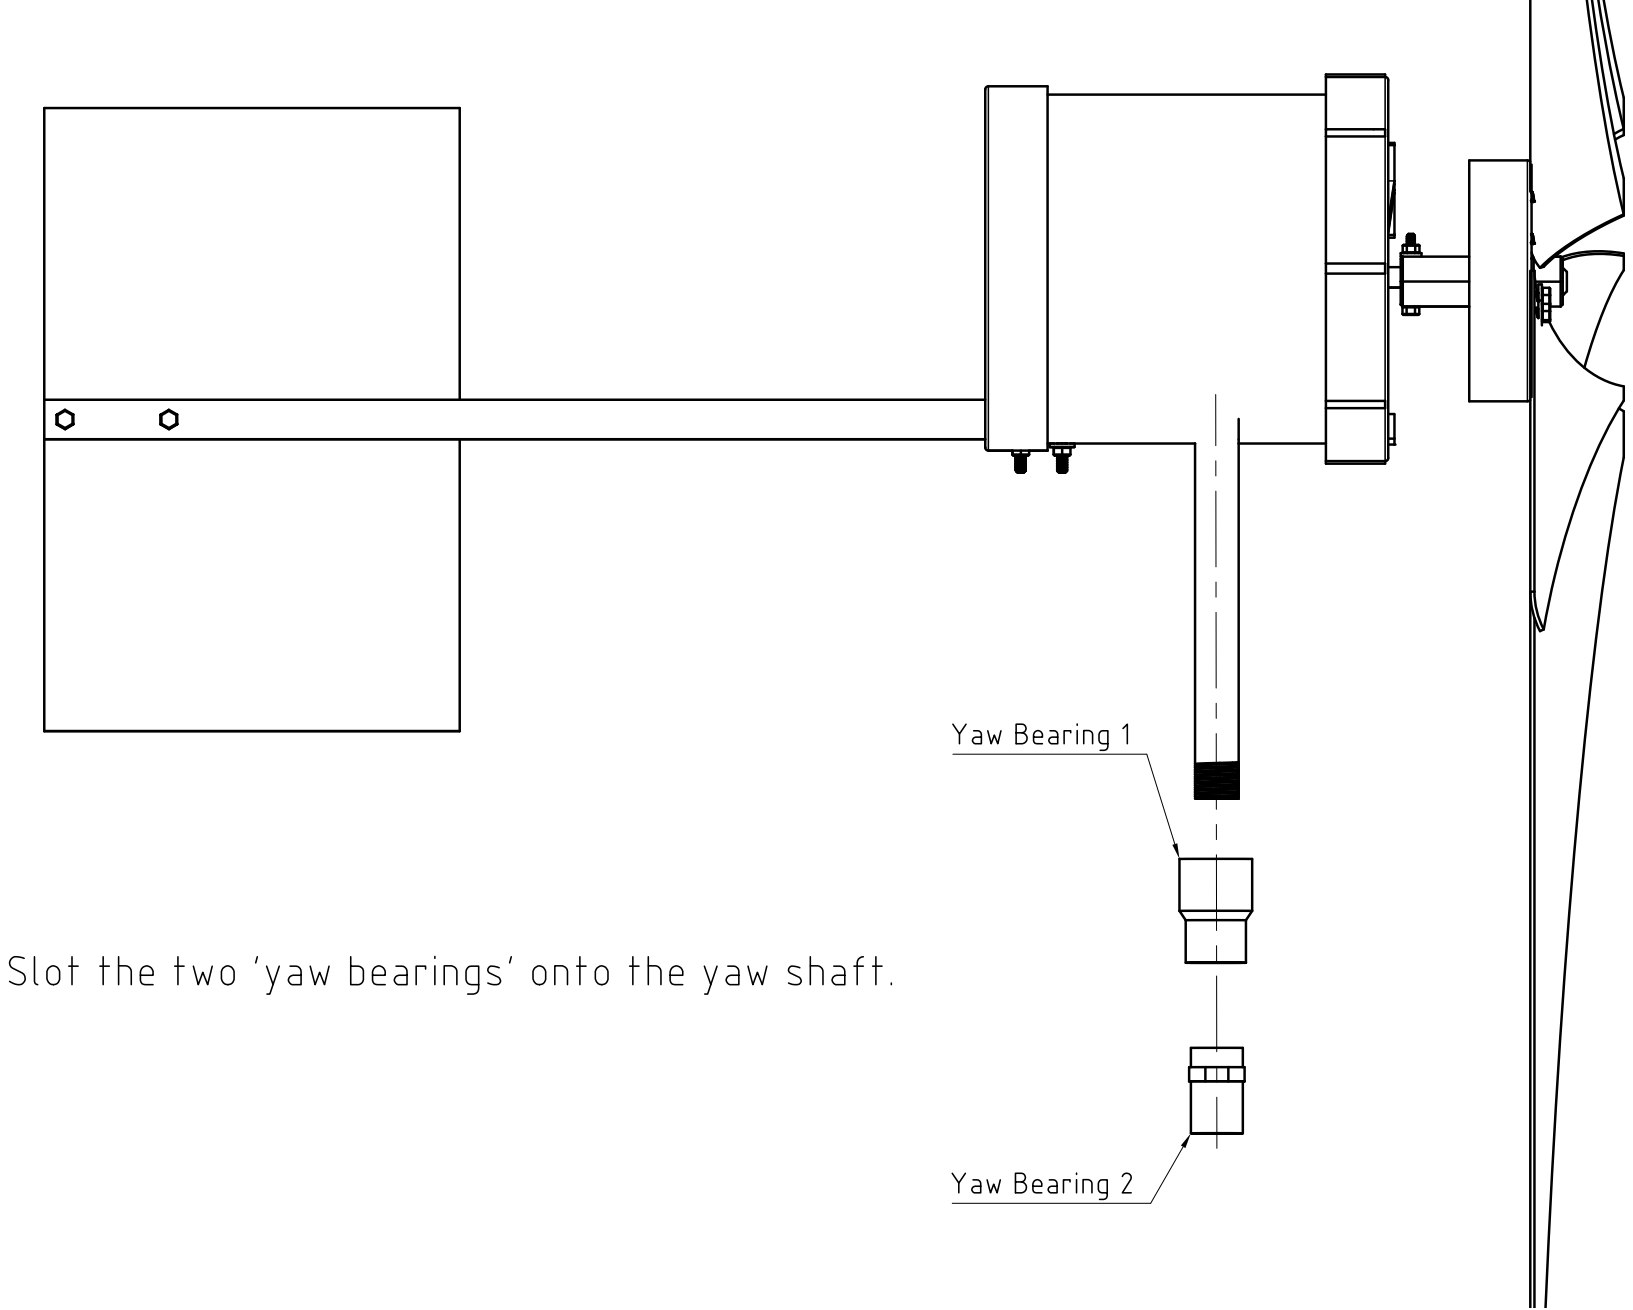
[picture p192: page 63]

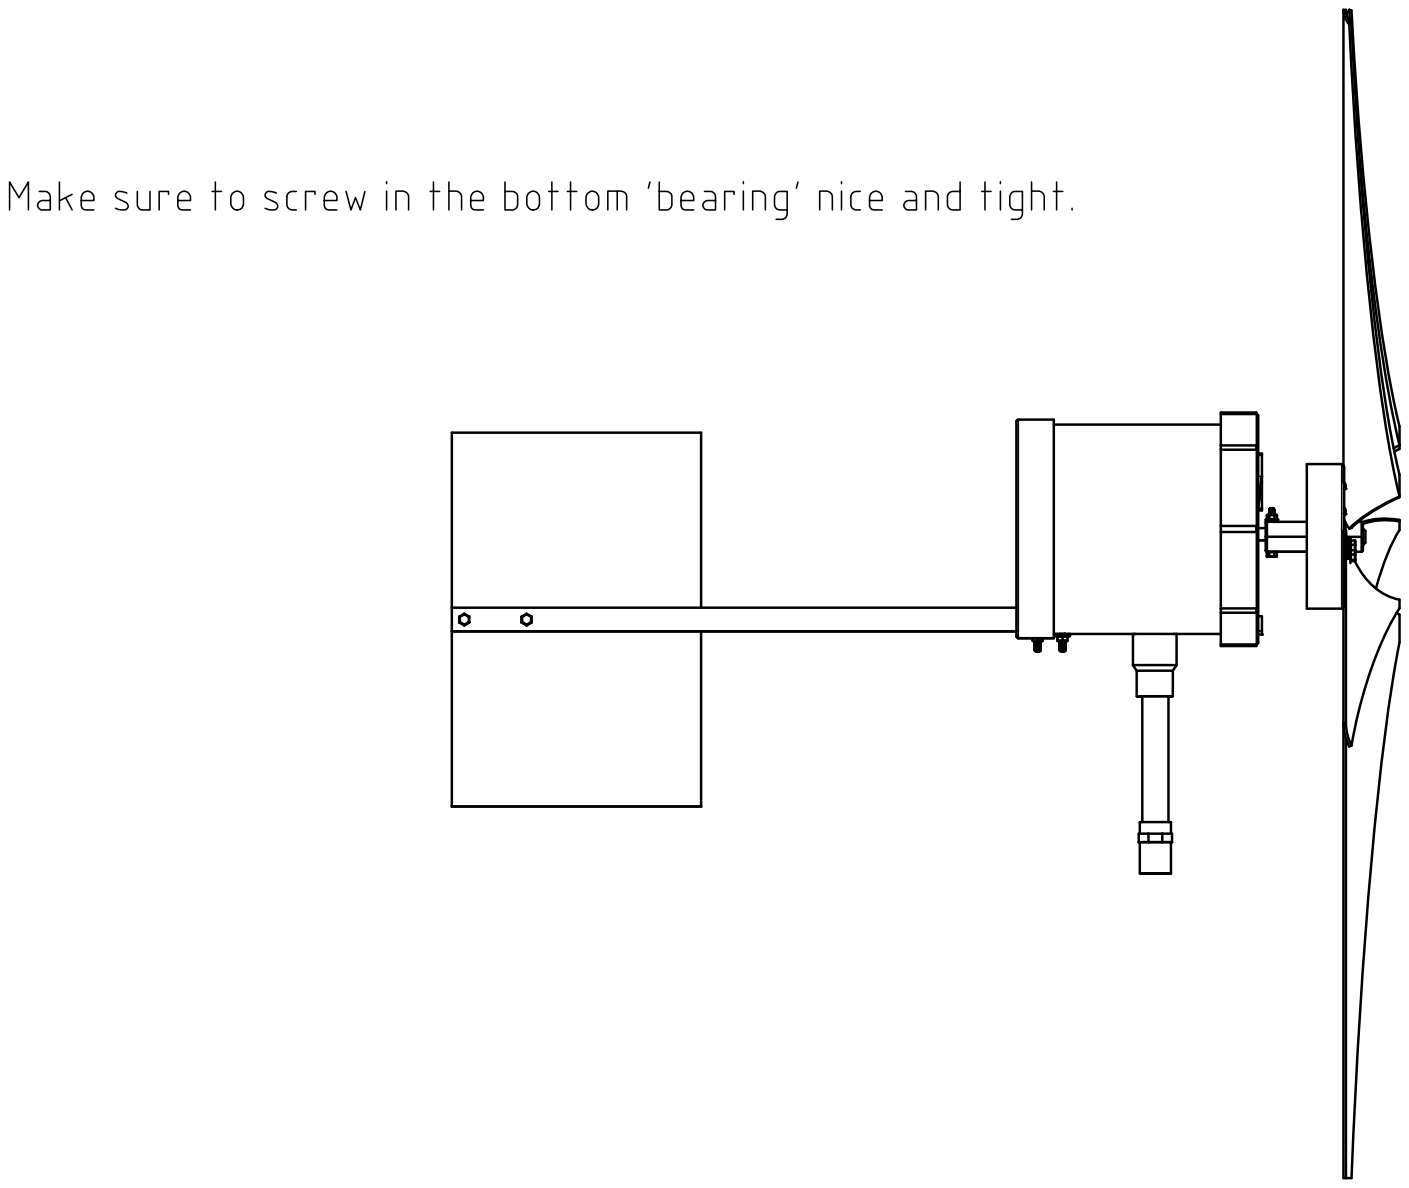
[picture p193: page 64]

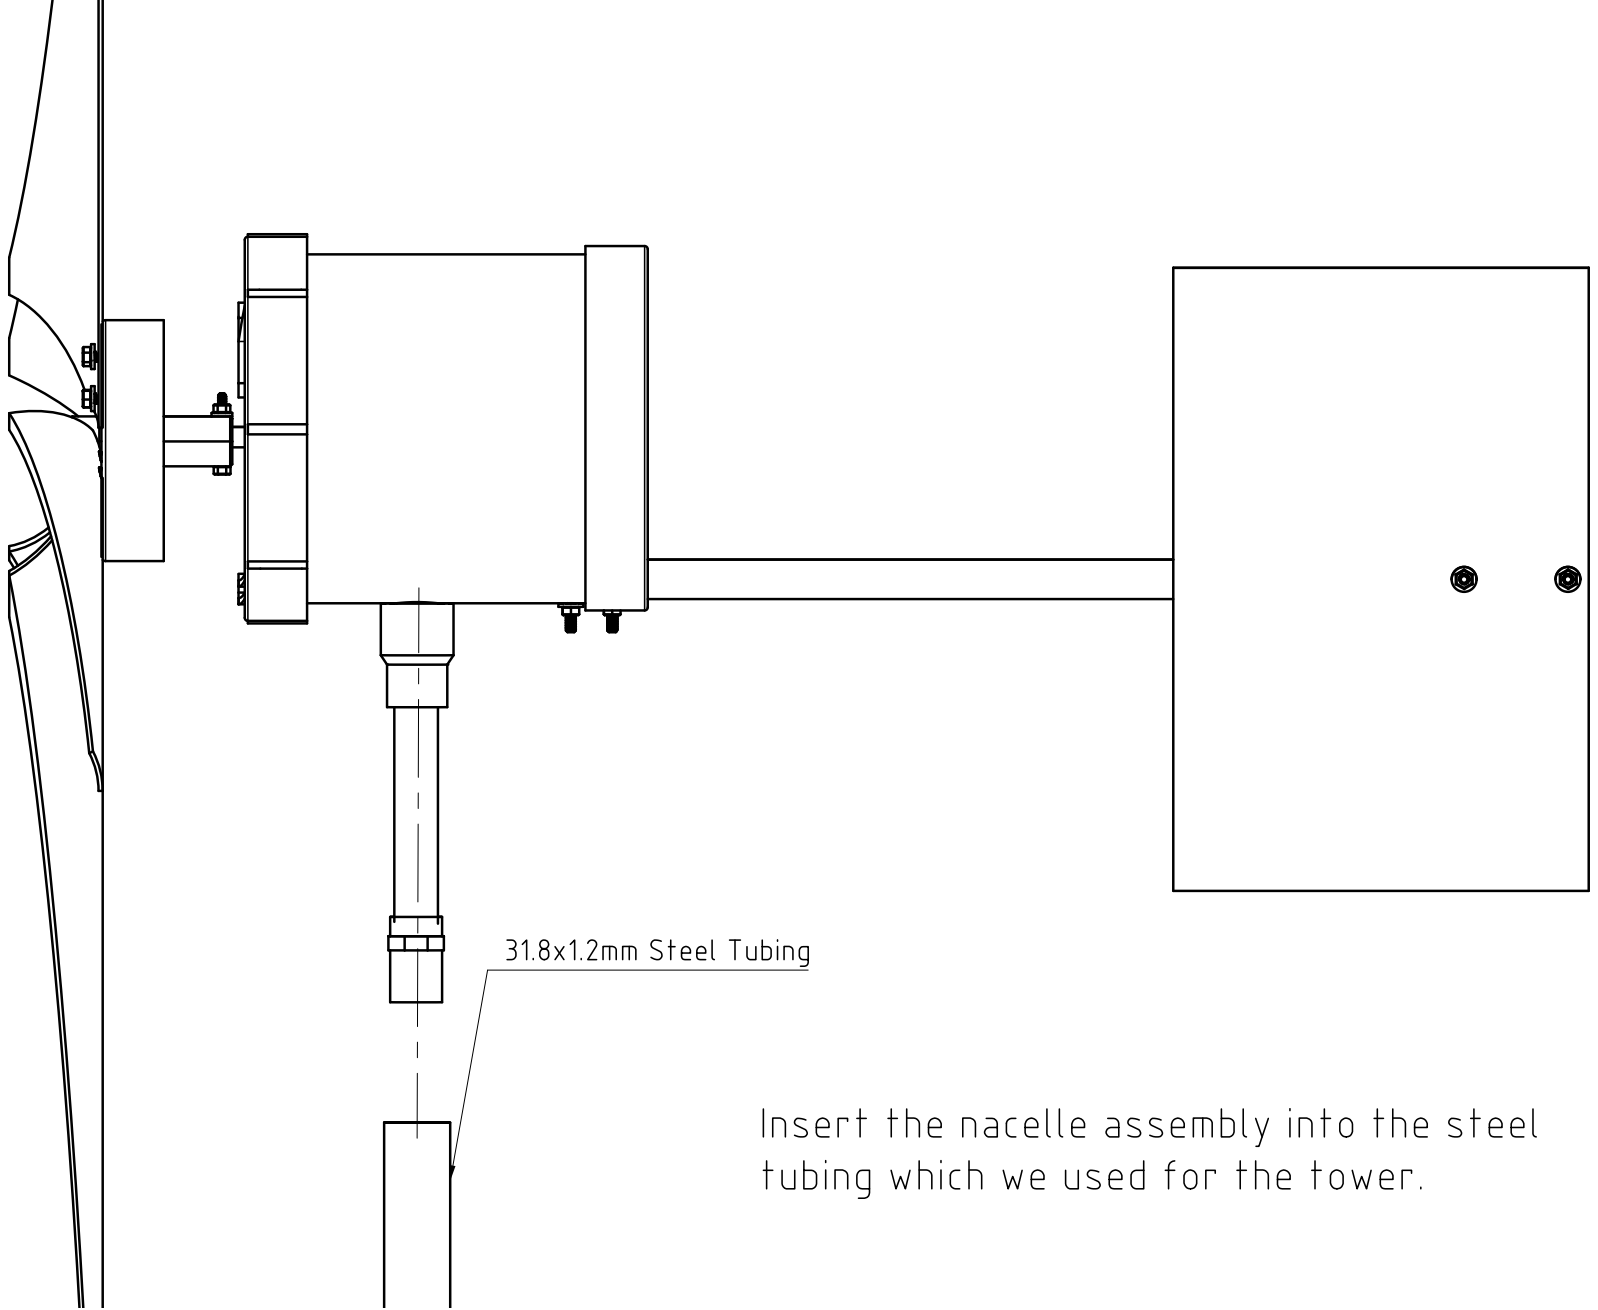
[picture p194: page 65]

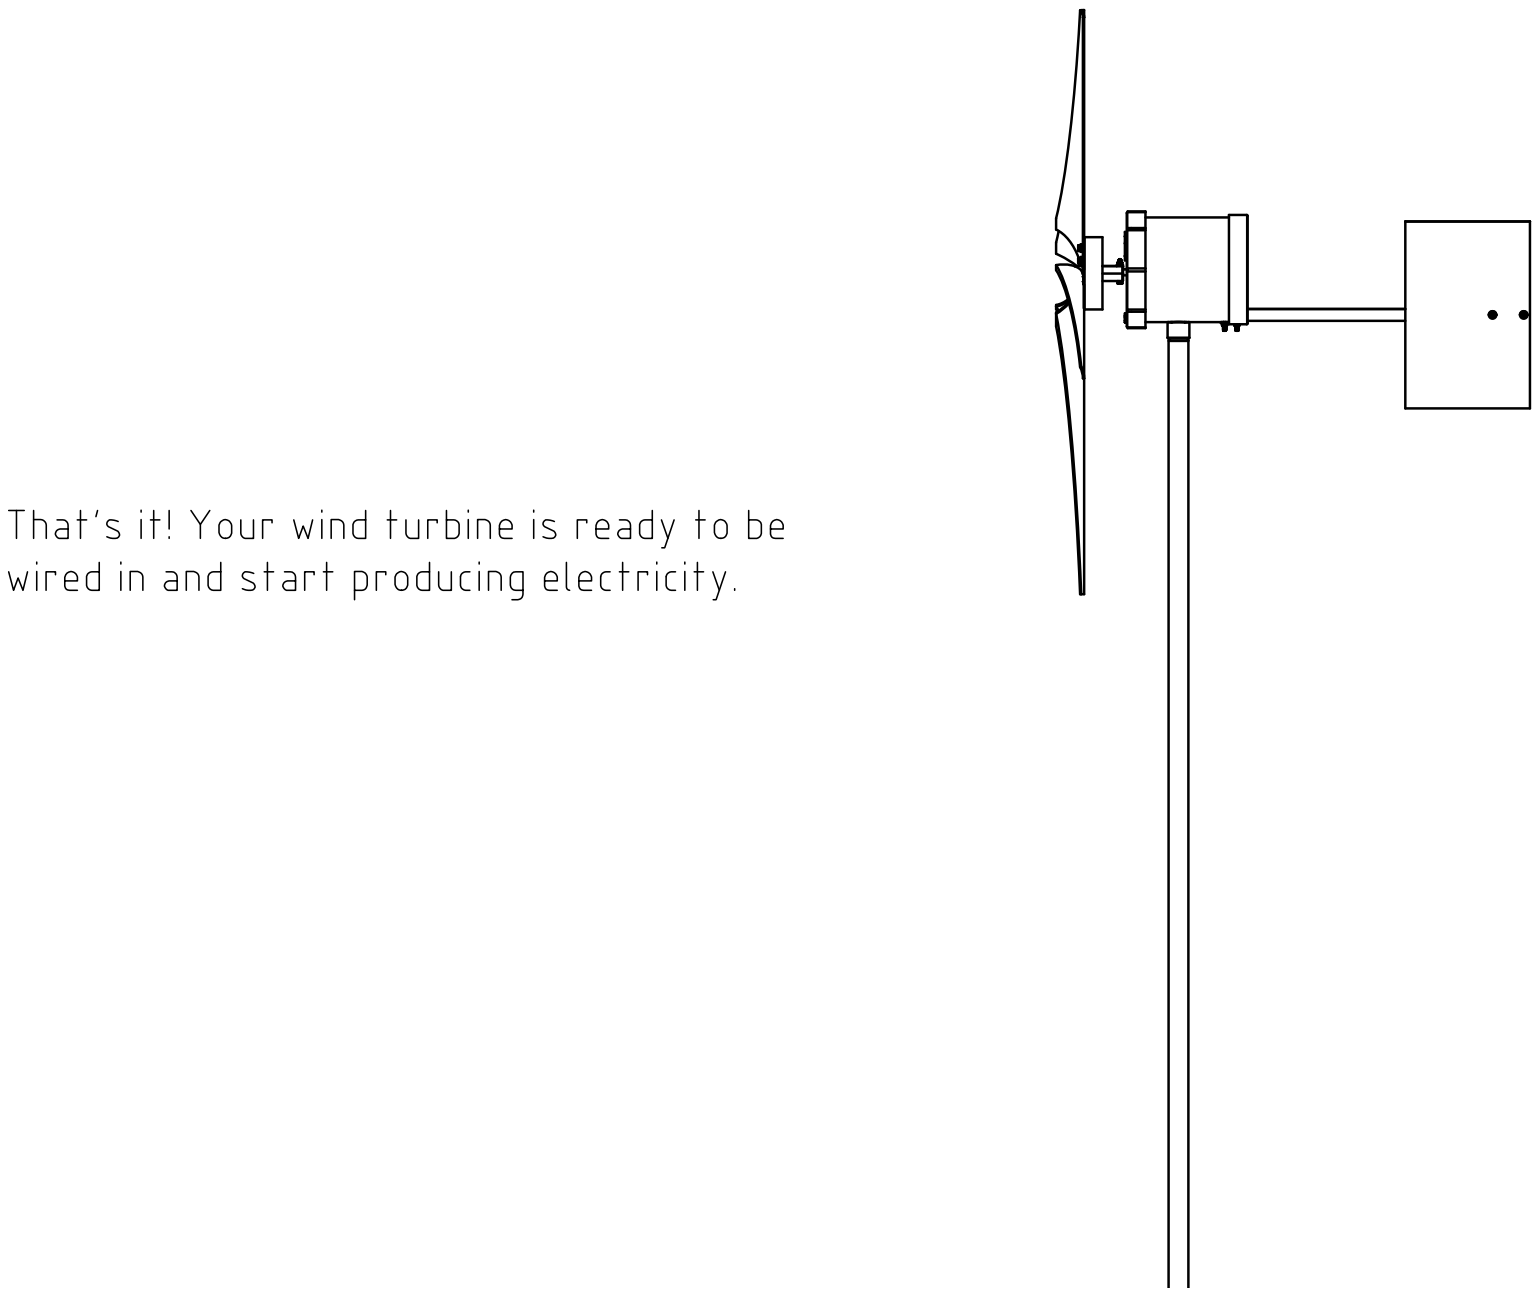
[picture p195: page 66]

## Next Steps

This is a first attempt at creating a wind turbine that fits our requirements and a set of instructions to go with it. While we are reasonably happy with the success we acknowledge that there is plenty of room for improvement!

- Tower/foundation – we have not yet addressed how to mount the tower, we will be creating some guidelines on this soon.
- Furling – a good wind turbine should have a system to stop it spinning too fast in high winds. We will be incorporating a passive furling system into the next instructions.
- Power curve – while we have done some basic testing in the wind, we will be logging the power output at various wind speeds using an anemometer to develop a detailed power curve which will allow us to incorporate improvements and test their effect.
- More power – ideally we want to achieve 50W in moderate wind conditions. This will require a new motor and we are on the lookout!
- PVC – we appreciate that PVC is not ideal for applications in direct sunlight. This can be rectified by painting with paint that protects from UV rays, but we are looking to minimise use of PVC with our next design.
