zettrik/eddy2power/photos/wiring_overview.png

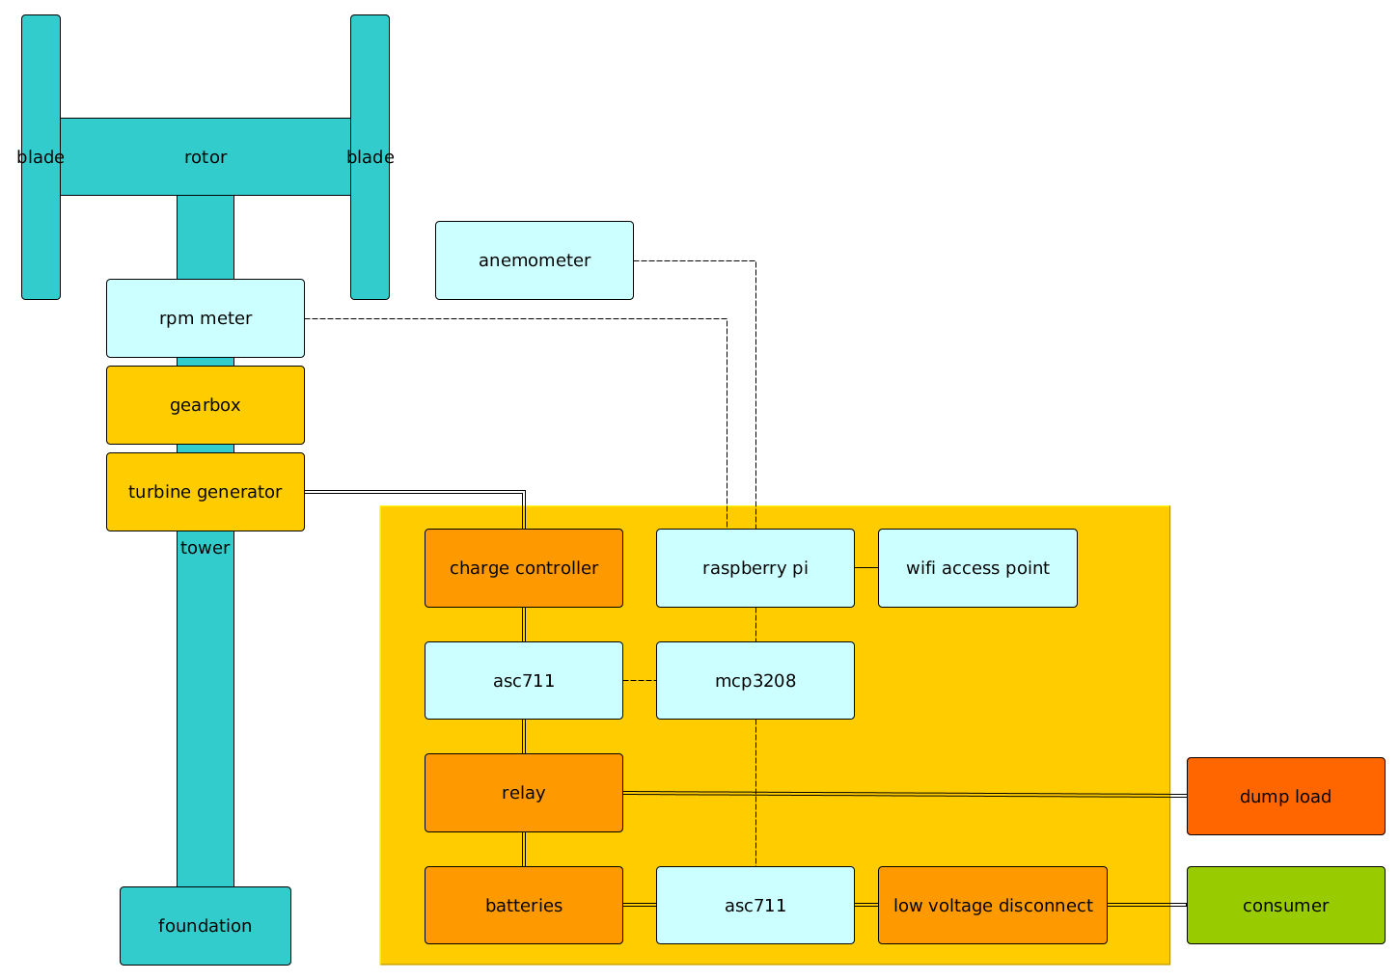
photos/wiring_overview.png
