zettrik/eddy2power/measure/arduino_reset_via_pi-gpio/arduino_reset_via_pi-gpio.png

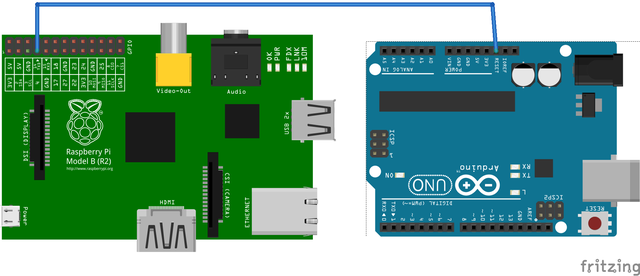
measure/arduino_reset_via_pi-gpio/arduino_reset_via_pi-gpio.png
