zettrik/eddy2power/work_in_progress/gnuplot_testmessung.png

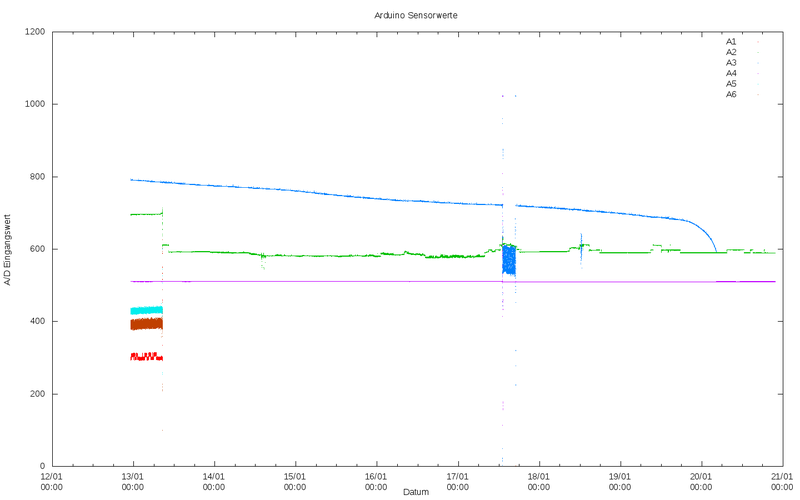
work_in_progress/gnuplot_testmessung.png
