zettrik/eddy2power/work_in_progress/Level_shifting_4_arduino.pdf

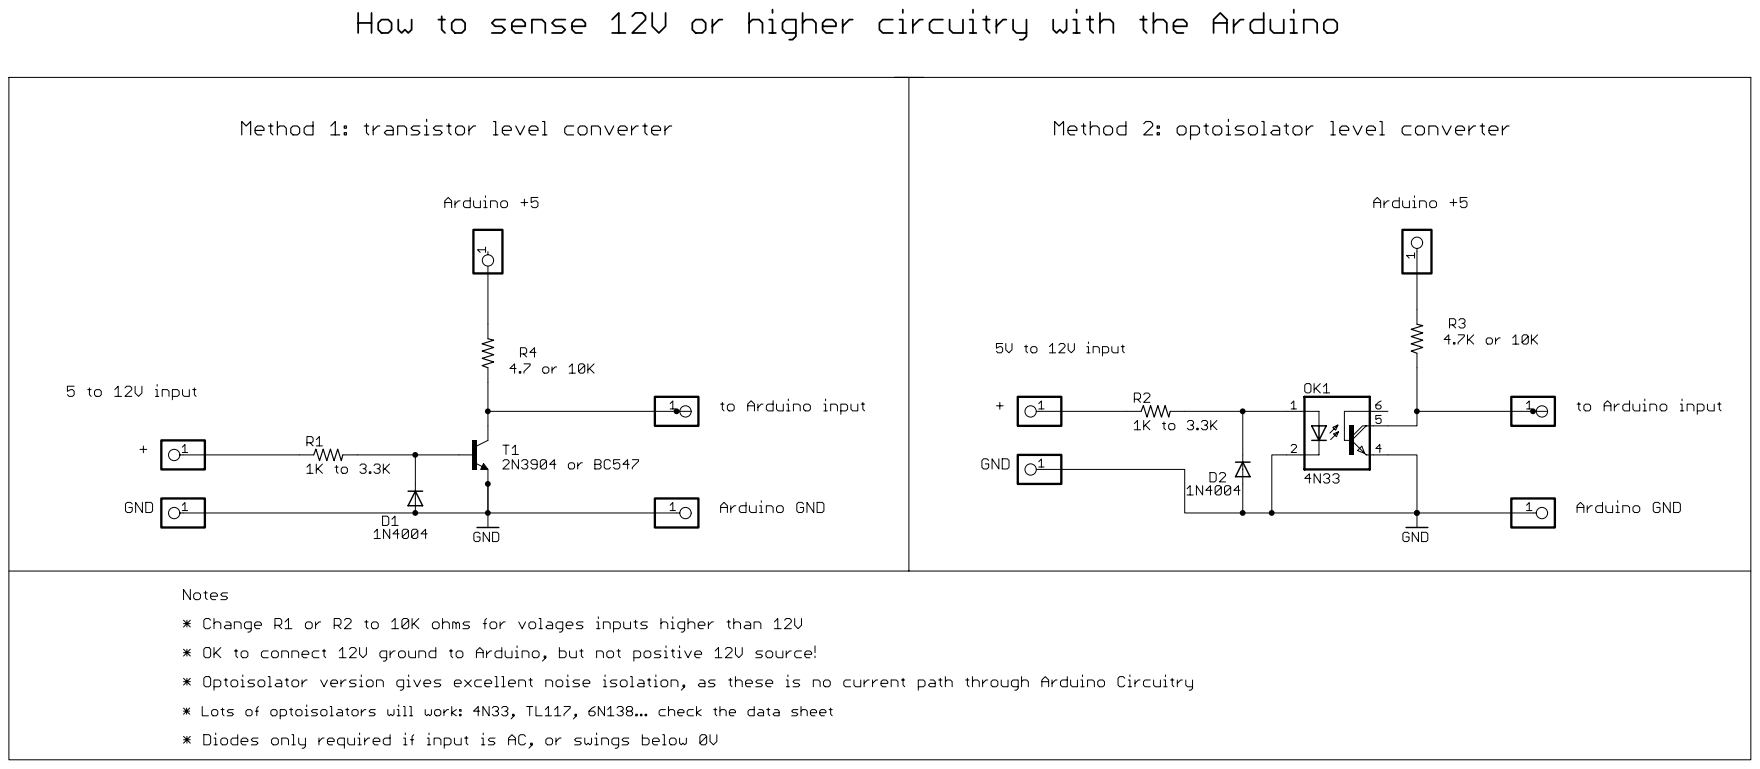
[picture p199: page 1]
