zettrik/eddy2power/charge_controller/pcb/pcb-nodemcu_mcp3208_etch_copper_bottom.pdf

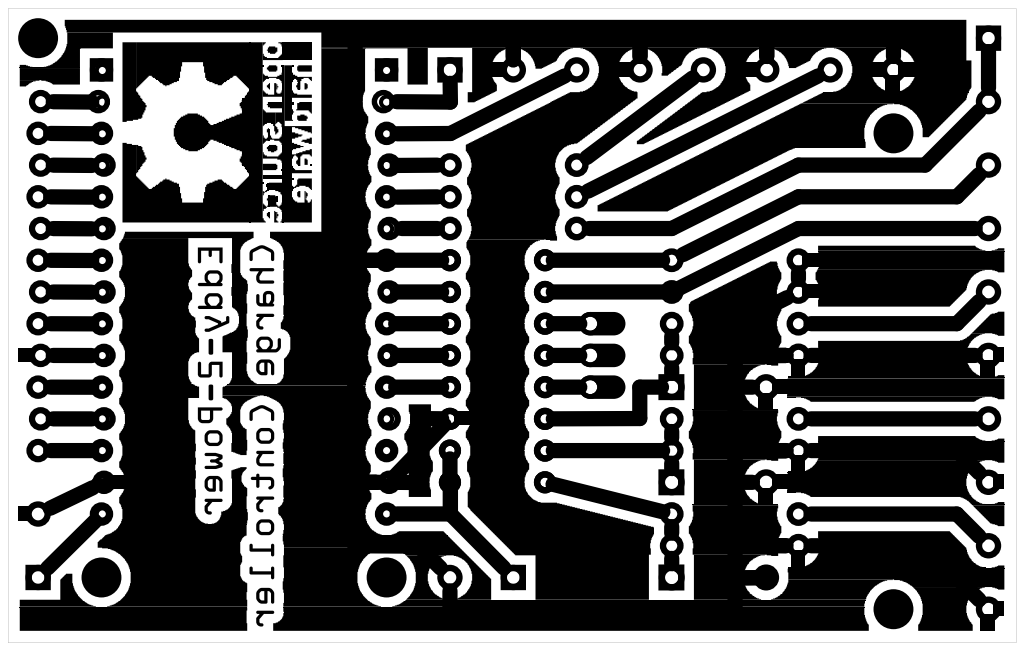
[picture p200: page 1]
