zettrik/eddy2power/charge_controller/pcb/pcb-nodemcu_mcp3208_etch_copper_bottom_mirror.pdf

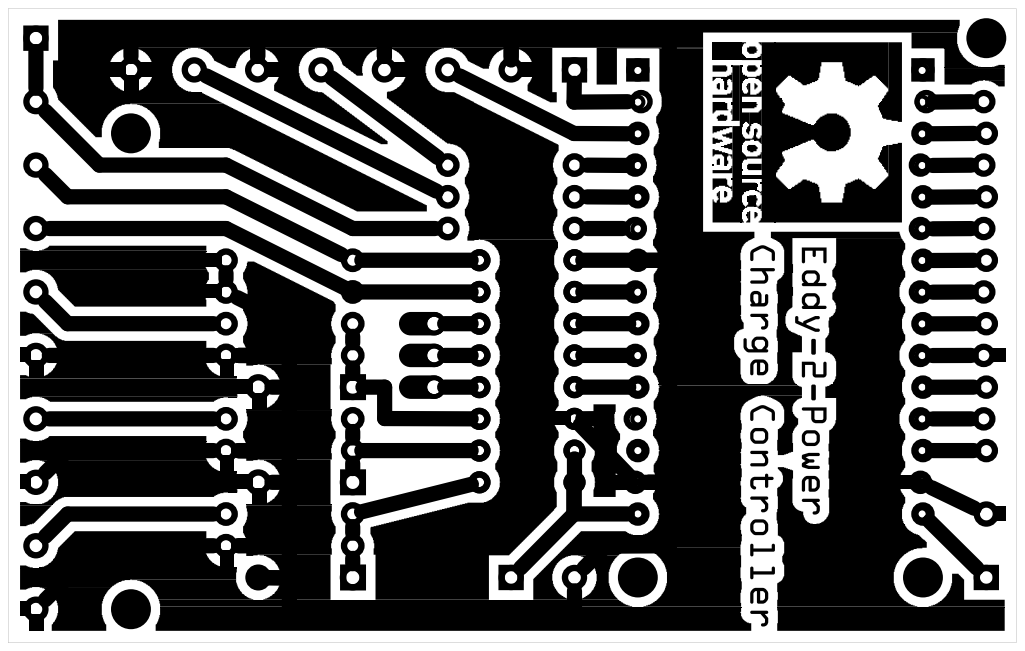
[picture p201: page 1]
