zettrik/eddy2power/charge_controller/pcb/pcb-nodemcu_mcp3208_etch_copper_top.pdf

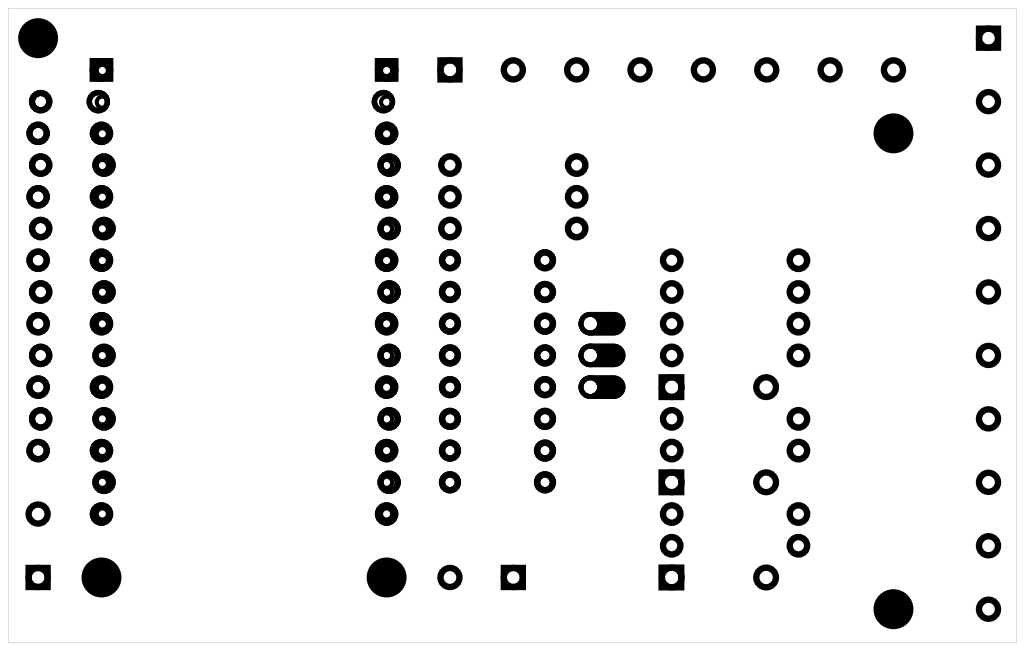
[picture p202: page 1]
