zettrik/eddy2power/charge_controller/pcb/pcb-nodemcu_mcp3208_etch_copper_top_mirror.pdf

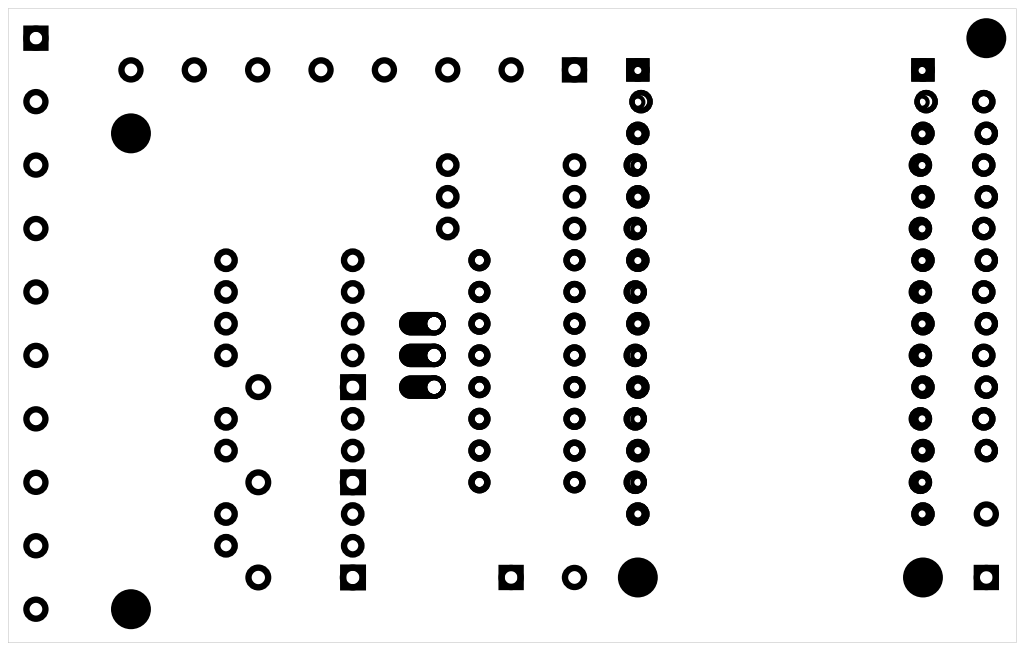
[picture p203: page 1]
