zettrik/eddy2power/charge_controller/pcb/pcb-nodemcu_mcp3208_etch_mask_bottom.pdf

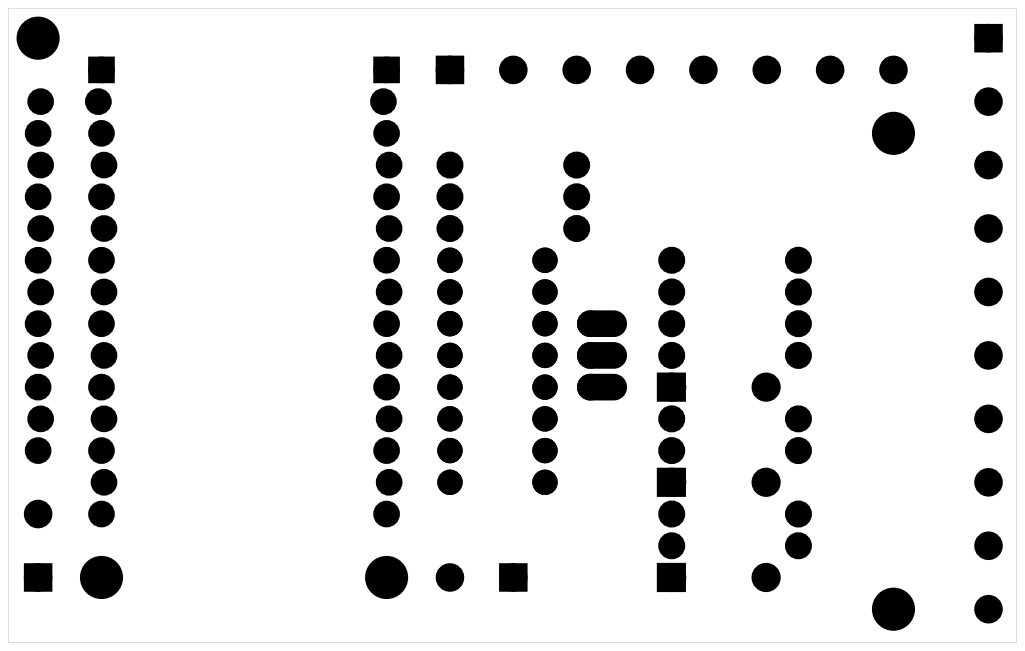
[picture p204: page 1]
