zettrik/eddy2power/charge_controller/pcb/pcb-nodemcu_mcp3208_etch_mask_bottom_mirror.pdf

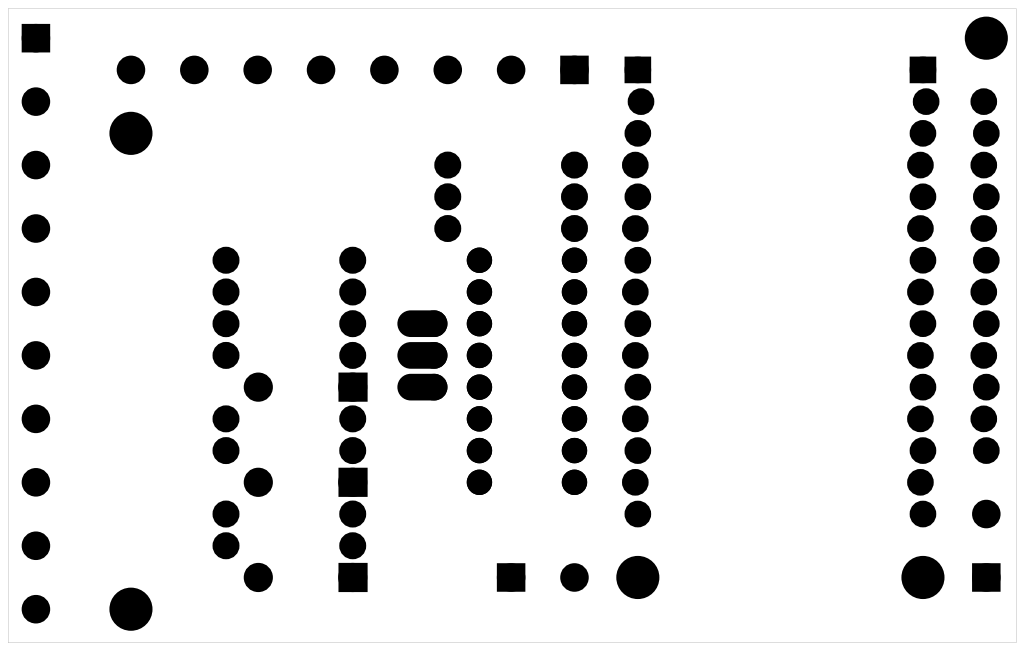
[picture p205: page 1]
