zettrik/eddy2power/charge_controller/pcb/pcb-nodemcu_mcp3208_etch_mask_top.pdf

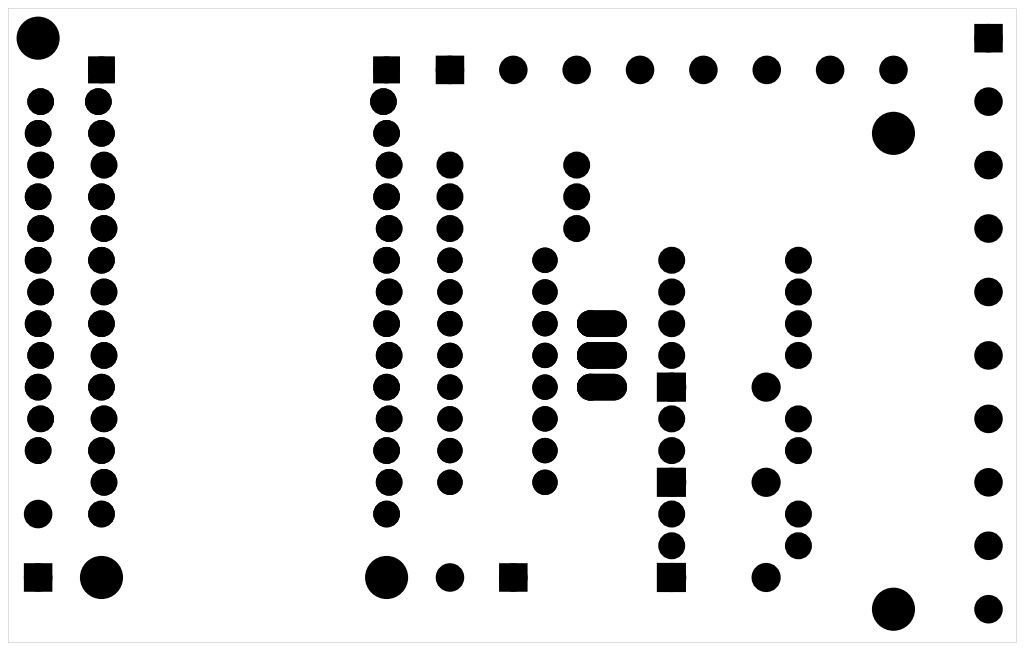
[picture p206: page 1]
