zettrik/eddy2power/charge_controller/pcb/pcb-nodemcu_mcp3208_etch_mask_top_mirror.pdf

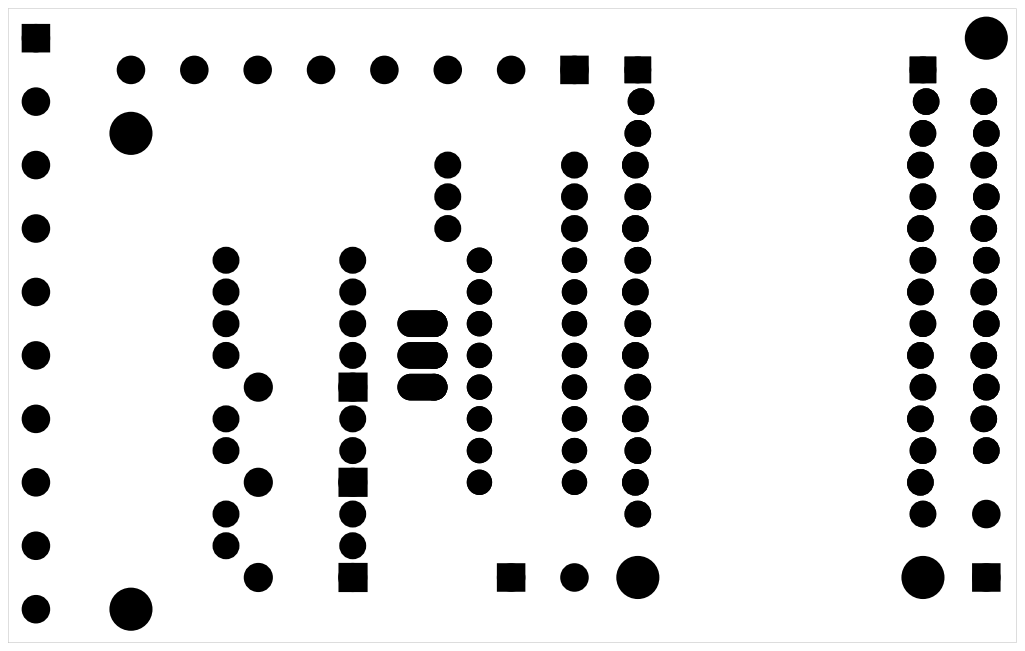
[picture p207: page 1]
