zettrik/eddy2power/charge_controller/pcb/pcb-nodemcu_mcp3208_etch_silk_bottom.pdf

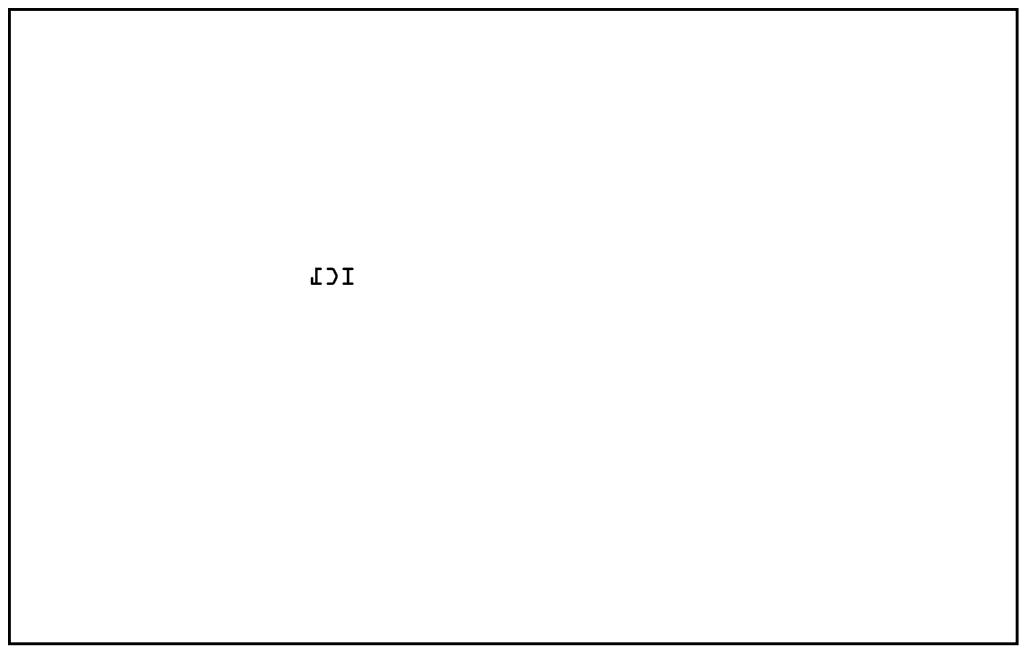
[picture p208: page 1]
