zettrik/eddy2power/charge_controller/pcb/pcb-nodemcu_mcp3208_etch_silk_bottom_mirror.pdf

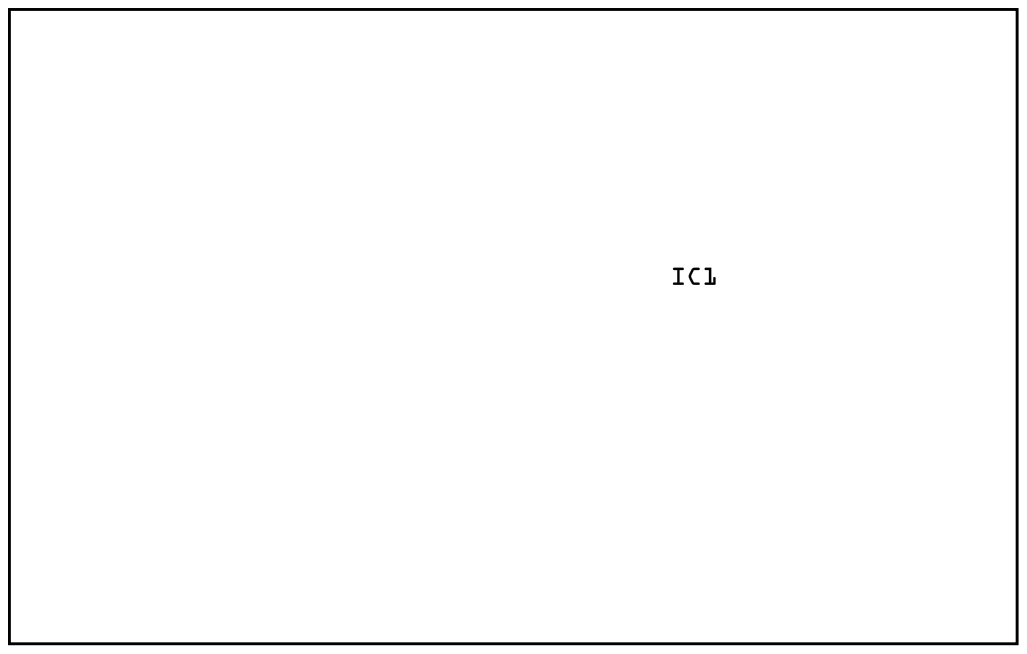
[picture p209: page 1]
