zettrik/eddy2power/charge_controller/pcb/pcb-nodemcu_mcp3208_etch_silk_top.pdf

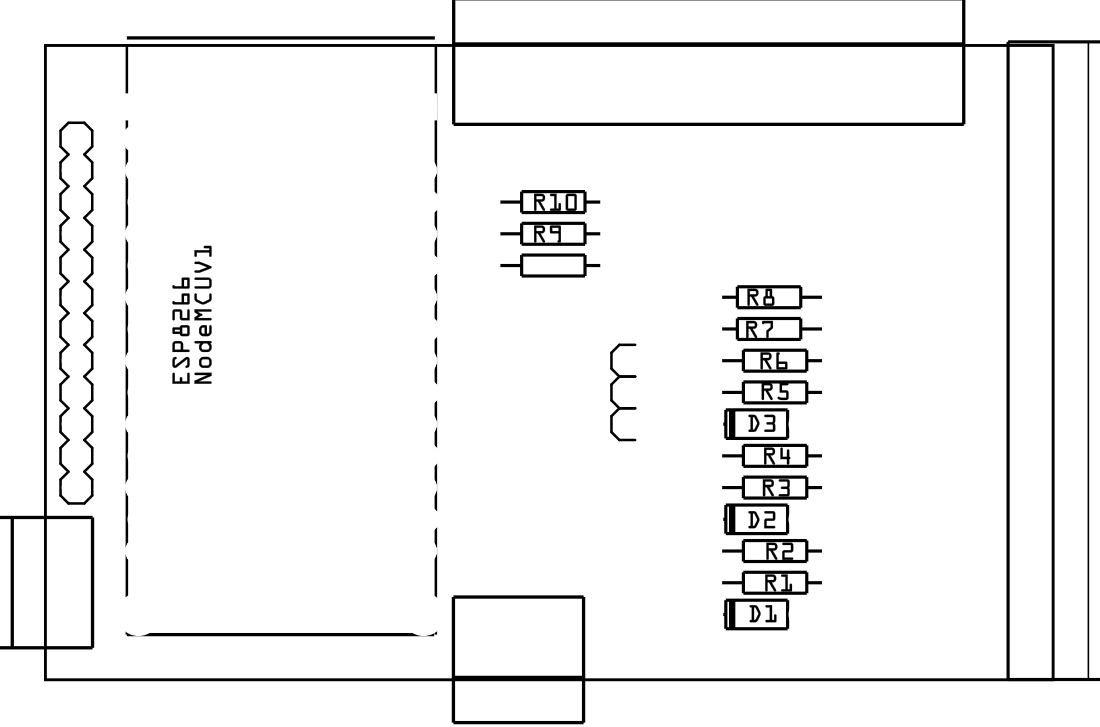
[picture p210: page 1]
