zettrik/eddy2power/charge_controller/pcb/pcb-nodemcu_mcp3208_etch_silk_top_mirror.pdf

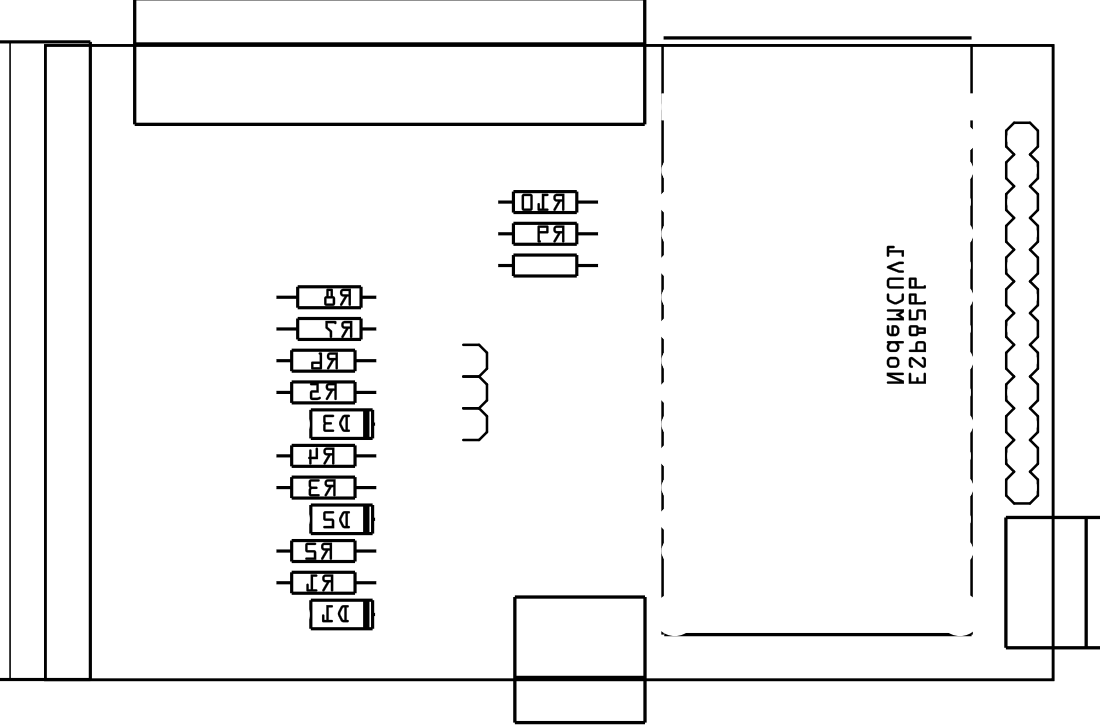
[picture p211: page 1]
