zettrik/eddy2power/(list of files, drawings)

Other design files:
charge_controller/breadboard-nodemcu-wind-power-monitor-mcp3208.fzz
charge_controller/pcb-nodemcu_mcp3208.fzz
circuits/Entladeschutz.fzz
circuits/Hallsensor_Strom_messen.fzz
circuits/MCP3008_an_Pi_mit_Spannungsteiler.fzz
circuits/nodemcu-sdcard.fzz
circuits/Spannungsteiler.fzz
measure/arduino_reset_via_pi-gpio/arduino_reset_via_pi-gpio.fzz
measure/pi_read_reed_switch/sensors_arduino_pi.fzz
work_in_progress/nodemcu-esp8266/nodemcu-wind-power-monitor-mcp3208-relays.fzz
work_in_progress/nodemcu-esp8266/nodemcu-wind-power-monitor-mcp3208.fzz
work_in_progress/nodemcu-esp8266/nodemcu-wind-power-monitor.fzz
