zettrik/eddy2power/(commit log)

2017-04-20 added links and calculations
    [berechnungen.ods]
2017-04-28 munin plugins for sensors added
2017-04-28 arduion code added
    [arduino_reset_via_pi-gpio.fzz]
2017-04-28 raspberry pi python code added
2017-04-28 wind-power calculation table (in German)
    [Leistungsberechnung.ods]
2017-04-28 read reed switches
    [sensors_arduino_pi.fzz]
2017-04-28 circuits added (fritzing)
    [Entladeschutz.fzz, Hallsensor_Strom_messen.fzz, MCP3008_an_Pi_mit_Spannungsteiler.fzz, Spannungsteiler.fzz]
2017-04-28 sketch for reading arduino analog inputs
2017-04-28 rotor profile
2017-05-17 added photos of rotor blade
2017-05-24 undocumented sites und thesis
2017-06-02 schematics added, directoryname translated
2017-06-02 started translation
    [Leistungsberechnung.ods, calculations.ods, power_estimation_h-rotor.ods]
2017-06-02 added english version
    [calculations.ods]
2017-08-19 sd-card wiring to nodemcu
    [nodemcu-sdcard.fzz]
2017-08-20 simple sd wiring; arduino test
    [nodemcu-sdcard.fzz]
2017-09-14 voltage regulator replacement
2017-09-14 voltage measurement links; mppt white paper and more to read
2017-09-20 nodemcu schematics; sd card handling;
    [nodemcu-wind-power-monitor.fzz]
2017-09-27 moved some files
    [nodemcu-wind-power-monitor.fzz]
2017-09-27 adc test
2017-09-28 circuits with adc, voltage divider and relays
    [nodemcu-wind-power-monitor-mcp3208-relays.fzz, nodemcu-wind-power-monitor-mcp3208.fzz]
2017-10-04 added potis to lvd
    [Entladeschutz.fzz]
2017-10-04 reading 12bit adc values
2017-10-11 changes in circuit and pins; new links;
    [nodemcu-wind-power-monitor-mcp3208-relays.fzz]
2018-02-07 added calculation table for voltage divider
    [voltage_divider_for_ad_converter.ods]
2018-02-12 interrupt handling of reed switches (e.g. for anemometer)
2018-02-12 better place for charge_controller files
2018-02-14 general cleanup
    [nodemcu-wind-power-monitor-mcp3208-relays.fzz, voltage_divider_for_ad_converter.ods]
2018-02-16 first board layout added
    [pcb-nodemcu_mcp3208.fzz]
2018-02-20 added circuit board layout for nodemcu-mcp3208 unit
    [nodemcu-wind-power-monitor-mcp3208-relays.fzz, pcb-nodemcu_mcp3208.fzz]
2018-02-28 workflow from sensor data to visualisation with grafana
2018-03-01 added grafana template; send internal voltage via mqtt; syntax clean up
2018-03-04 pcb layout ready for etching
    [pcb-nodemcu_mcp3208.fzz]
2020-01-19 mqtt logger; mosfet; mcp3208; ...
    [breadboard-nodemcu-wind-power-monitor-mcp3208.fzz, nodemcu-wind-power-monitor-mcp3208-relays.fzz]
